Lain-Ego0/G-Exo/Q&A.md

# G-Exo — 产品定位 Q&A

AI主动提问的思路整理

> 状态：**5 轮全部完成 ✓** (2026-06-28)  
> 产出：[关键参数草表 V0.1](specs/关键参数草表-V0.1.md) · [BOM 初稿](specs/BOM-初稿.md)  
> 下一步：等灵足 7 月中旬 DM4340 类似物上市 → 采购 → 样机组装

---

## Round 1 · 产品定位基线 ✓

### 一、用户与场景

| # | 问题 | 回答 |
|---|---|---|
| 1 | **核心用户是谁？** | 户外人群，拓展人类活动边界。搜救、户外爱好者、工业场景 |
| 2 | **使用环境？** | 多场景通用 |
| 3 | **穿戴时长？** | 连续 2-3 小时，充电宝供电 |

### 二、功能与能力

| # | 问题 | 回答 |
|---|---|---|
| 4 | **核心动作？** | 矢状面屈伸 + 冠状面外展/内收。**不要髋旋转** |
| 5 | **"自由度"含义？** | 机械结构多自由度适配人体。髋 1 + 膝 1 |
| 6 | **驱动方式？** | **电机直驱**，连杆 + 绑带固定 |
| 7 | **助力还是矫正？** | **增强健康人的力量/耐力** |

### 三、控制与人机交互

| # | 问题 | 回答 |
|---|---|---|
| 8 | **控制策略？** | IMU + 电机编码器 → 最终选：先 PID/导纳控制跑通硬件 |
| 9 | **操作方式？** | **全自动姿态触发** |

### 四、产品形态

| # | 问题 | 回答 |
|---|---|---|
| 10 | **单腿几个关节？** | 髋 + 膝，双腿共 4 主动自由度 |
| 11 | **材质与重量？** | 铝合金 + 碳纤维。整机 **~4kg**（电池外置） |
| 12 | **穿戴方式？** | 腿部绑带 + 腰部快拆卡扣，独立穿脱 |

### 五、能源与续航

| # | 问题 | 回答 |
|---|---|---|
| 13 | **供电方案？** | 外接充电宝（USB-PD 20V） |
| 14 | **能量回收？** | 有最好 |

### 六、市场与竞品

| # | 问题 | 回答 |
|---|---|---|
| 15 | **对标产品？** | 不同于医疗/工业竞品。G-Exo = 单人小型四自由度主动式外骨骼 |
| 16 | **价格锚点？** | 消费电子级，BOM ≤5K |
| 17 | **差异化卖点？** | 膝关节主动自由度 + 更智能的控制算法 |

### 七、研发阶段

| # | 问题 | 回答 |
|---|---|---|
| 18 | **当前阶段？** | 概念阶段，目标：**8 月物理 AI 黑客松样机** |
| 19 | **最关键瓶颈？** | 选型（关节模组）、确认构型、明确技术路线 |

---

## Round 2 · 深挖矛盾与边界 ✓

### A. 机械构型

| # | 回答 |
|---|---|
| A1 | 竞品 Dnsys X1、Hypershell 仅有髋关节单方向。G-Exo 增加**膝关节主动** + 冠状面**被动** |
| A2 | 冠状面 = **被动跟随**。主动自由度 = 髋屈伸 + 膝屈伸 ×2 = **4 个** |
| A3 | 重量拆解：电机 ×4 ~1,448g + 连杆 ~500g + 绑带腰带 + 电控 ≤ 4kg（电池外置） |

### B. 动力 / 控制 / 成本 / 场景

| # | 回答 |
|---|---|
| B1 | 多档位 **25-60W**，15-20% 助力比例 |
| C1/K1 | 最终选 **路线 3：先 PID/导纳控制跑通硬件，控制算法后续迭代** |
| D1 | **BOM ≤5K**。目标关节模组 ¥799/个，4 个 = ¥3,196 |
| D2 | **购买成品关节模组**，不自研 |
| E1 | **户外场景** |
| E2 | **周末徒步为主** + 越野跑兼容。徒步是最大用户盘（数千万），Dnsys/Hypershell 已做市场验证 |

---

## Round 3 · 关键参数收敛 ✓

| # | 回答 |
|---|---|
| G1 | DM4340：额定 9 N·m / 峰值 27 N·m / 36 rpm / 40:1 / 24V — ⚠️ **缺货** |
| G2 | 扭矩够（峰值 27 N·m ≫ 20% 助力所需 10-14 N·m）。助力比例参考：70kg 成人平地走，髋峰值 ~50-70 N·m，放大 20% → 外骨骼需 ~10-14 N·m |
| H1 | **4 个 IMU**（左右大小腿），G354 车规级 |
| H2 | **不加**压力鞋垫（论文消融实验：去掉仅降 R² 0.03-0.07，徒增成本） |
| H3 | **RK3588 或同类 Linux 开发板**（带 NPU，后续可部署 TCN 推理） |
| I1 | 20V PD → 24V 电机供电拓扑待解决 |
| I2 | **接受**带 1-2 个充电宝（比自制电池包有搞头） |
| K2 | **有动捕设备**，也可租借 |
| O2 | **接受电流估算力矩**（零成本，精度较低但 V1 够用） |

---

## Round 4 · 核心阻塞点突破 ✓

| # | 回答 |
|---|---|
| L1 | CubeMars 太贵。DM4340 ¥799 零售价但缺货。灵足 RS00/RS02 减速比太小速度过快。坚持**买成品模组不自研** |
| L2 | 最终选 **灵足 7 月中旬 DM4340 类似物**（15-60V 宽电压版），直接购买 |
| M1 | PD 3.1 EPR 兼容性差。引用酷泰科 × 中电科外骨骼（充电宝供电 + 双电池换弹式，南京已试用）→ 验证了充电宝外骨骼方向 |
| N1 | 功率 25-60W 三档，助力 15-20% |
| O1 | **4 关节全功能样机**（黑客松用），工作量不会因单腿而减半 |

> 💡 酷泰科情报：充电宝直驱 + 双电池"换弹式"设计，定位户外行走/爬山助力。G-Exo 差异化 = 膝关节主动自由度。

---

## Round 5 · 最终收敛 ✓

| # | 回答 |
|---|---|
| P1 | 黑客松：**2026 年 8 月**。EduLite 05 已上线，但我们不用 |
| P2 | 比赛主题"物理 AI"——强调 AI 算法在物理世界中的应用，与外骨骼契合 |
| Q1 | 灵足 7 月中旬推出 DM4340 类似物（15-60V 宽输入），直接采购。其他品牌售价均有大问题不适用 |
| R1 | 供电拓扑确认：**20V PD 直驱，不升压**。链路：充电宝 → PD 诱骗器(20V) → 电源分配板 → 4×电机 + 降压(5V/3.3V)→主控+IMU |
| R2 | 先单充电宝，后续加热插拔管理器 |
| S1 | 参数共识确认（见下表） |
| S2 | 同意产出参数草表 + BOM |

### 最终参数共识

| 参数 | 值 |
|---|-----|
| 整机重量 | ≤4kg（不含电池） |
| 主动自由度 | 4（髋屈伸×2 + 膝屈伸×2） |
| 被动自由度 | 冠状面外展/内收 |
| 关节模组 | 灵足 4340 类似物 ×4（15-60V，~¥800/个） |
| 助力比例 | 15-20% 生物力矩 |
| 整机功率 | 25-60W（三档：步行/慢跑/爬山） |
| 传感器 | 4×IMU（大小腿）+ 4×电机编码器 |
| 计算平台 | RK3588 / Linux 开发板 |
| 控制 V1 | 电流估算力矩 + 导纳控制 |
| 供电 | 充电宝 20V PD（先单后换弹） |
| BOM | ≤5K |
| 主场景 | 户外徒步 + 慢跑/爬山 |

---

## 附录 A · 灵足 RS06 完整参数

> 用户选型过程中考察的备选方案，保留供参考。最终选择等 7 月中旬 DM4340 类似物。

| 参数 | 值 |
|---|-----|
| 尺寸 | 88 × 88 × 49 mm |
| 重量 | 621g ± 10g |
| 减速比 | 9:1（行星减速，机加工齿轮） |
| 额定电压 | 48V / 使用范围 15-60V |
| 额定扭矩 | 11 N·m / 额定转速 100 rpm |
| 峰值扭矩 | 36 N·m / 峰值电流 57 Apk |
| 空载转速 | 480 rpm |
| 转矩常数 | 1.1 N·m/Arms |
| 编码器 | 14bit 单圈绝对值磁编码器 ×2 |
| 通信 | CAN 总线 1Mbps |
| 驱动 | FOC |
| 认证 | CE / FCC |

## 附录 B · 竞品参考

| | Dnsys X1 | Hypershell | 酷泰科×中电科 | **G-Exo** |
|---|---|---|---|---|
| 关节 | 髋（单） | 髋（单） | 髋（推测） | **髋+膝（4主动）** |
| 供电 | 内置电池 | 内置电池 | 充电宝换弹 | **充电宝 PD 20V** |
| 价格 | ~$500-800 | ~$600-800 | 未公布 | **BOM ≤5K** |
| 场景 | 徒步/登山 | 户外探险 | 行走/爬山 | **徒步+慢跑+爬山** |
| 控制 | 预设模式 | 预设模式 | 未公布 | **导纳控制→TCN力矩估计** |

---

*Q&A 阶段结束。进入等采购 + 构型设计阶段。*
