Lain-Ego0/G-Exo/RL/PHYSICAL_PPO_AUDIT.md

# 动态外骨骼 PPO 复审记录

更新时间：2026-08-02

本文记录动态 URDF、Kinesis 人体、肌肉负载分担和 PPO 链路的第二轮复审结果。

本文不把“相位对齐”列为当前问题。当前所有训练动作使用固定参考动作和固定仿真时间，现阶段首先要解决的是物理传力、肌肉指标和 PPO 探索稳定性。

## 一、已经确认的内容

### 1. 动态模型可以运行

- 动态模型维度：`nq=46, nv=45, nu=90`。
- 人体原有肌肉执行器：`86` 个。
- 外骨骼新增电机：`4` 个。
- 外骨骼质量：约 `3.098 kg`，与 URDF 质量一致。
- 电机通过大腿、小腿绑带约束向人体传力，不再直接给人体关节写入外力矩。
- 绑带力可以通过同一状态下的“电机开/关差值”提取。

### 2. 基线数据已经补齐

当前动态零电机基线为：

```text
11 个动作 × 3 个 seed = 33 个成功 rollout
```

评估模式已经改为严格 seed 模式。缺失 seed 时直接报错，不再自动映射到其他 seed。

### 3. Kinesis 冷启动已经处理

Kinesis 第一次 reset 与后续 reset 存在一次性差异。现在 `AssistBackend.reset()` 会在每个新 backend 的第一次 reset 时预热一次。

同一 motion、同一 seed 的连续测试已经达到完全一致：

```text
activation、muscle torque、MPJPE 的最大差值 = 0
```

## 二、必须优先修正的问题

> 2026-07-31 修复状态：以下四项 P0 已落实。Balance residual 不再终止
> episode；PPO 动作幅值与 `17 Nm` 硬限额解耦，pilot 默认使用 `0.5 Nm`
> 且 `log_std_init=-3`；激活成本只统计跨越四个目标关节的肌肉；力矩
> 省力项改为逐肌肉绝对力矩贡献。新的 33 份基线位于
> `RL/outputs/kinesis_physical_baseline_v2`。以下内容保留为修复依据。

### P0-1：不能用 balance residual 直接终止 episode

原逻辑位于：

```text
RL/env/kinesis/exo_env.py::_abnormal_termination_reason()
```

`balance residual` 表示肌肉层预测力矩与动力学后验力矩之间的不一致，不等价于人体摔倒。

因此以下逻辑不应作为人体失败条件：

```python
if balance_ratio > MAX_BALANCE_RESIDUAL_RATIO:
    return "excessive_muscle_balance_error"
```

它会把正常的探索动作提前截断，导致 PPO 学习“不要探索”，而不是学习如何助力。

真正的 episode 终止条件应只包括：

- pelvis 高度过低；
- 躯干倾角过大；
- Kinesis 原生 tracking failure；
- 肌肉求解器失败；
- NaN/Inf 或其他数值异常。

Balance residual 可以保留为 TensorBoard 指标和软惩罚，但不应直接终止 episode。

### P0-2：训练探索范围不能直接使用 `±17 Nm`

`17 Nm` 是 URDF 给出的硬限制，不应该成为 PPO 初始探索范围。

当前动作近似为：

$$
\tau_t = 17 a_t, \qquad a_t\in[-1,1]
$$

随机策略经过 rate limiter 后，仍可能在数个控制周期内产生较大的力矩，破坏原始步态。

训练应该使用独立的动作课程：

$$
\tau_t = \tau_{\text{train},k}a_t
$$

推荐阶段：

```text
阶段 1：±0.25 或 ±0.5 Nm
阶段 2：±1 Nm
阶段 3：±2 Nm
阶段 4：±4 Nm
阶段 5：±6 Nm
```

`±17 Nm` 只保留为最后的硬安全边界。

同时应使用较小的初始策略方差，例如 `log_std_init=-3`，避免刚开始就输出大幅随机力矩。

### P0-3：激活奖励不应统计全部 86 块肌肉

当前激活成本类似于：

```python
np.mean(np.square(state["muscle_activation"]))
```

这会把上身和不跨越目标关节的肌肉也纳入外骨骼省力奖励。

正确的目标肌肉集合应定义为：

$$
\mathcal{M}_{target}
=
\left\{i\mid \exists j\in\{hip_l,knee_l,hip_r,knee_r\},\ |r_{ij}|>\epsilon\right\}
$$

其中 $r_{ij}$ 是肌肉 $i$ 对目标关节 $j$ 的力矩臂。

之后需要同步修改：

- `AssistBackend` 的目标肌肉 mask；
- `collect_kinesis_baseline.py` 的保存字段；
- `BaselineReference` 的读取字段；
- `exo_env.py` 的 activation reward；
- 33 个基线文件。

### P0-4：净关节力矩不能单独代表肌肉负担

当前关节力矩是：

$$
\tau_j=\sum_i r_{ij}f_i
$$

拮抗肌可能互相抵消，使净关节力矩变小，但肌肉本身仍然很用力。

因此需要同时记录两个量：

1. `net_joint_torque`：用于动力学和平衡；
2. `muscle_effort_torque`：用于省力奖励。

推荐肌肉力矩成本为：

$$
C_{muscle}
=
\frac{1}{|\mathcal{M}_{target}|}
\sum_{i\in\mathcal{M}_{target}}
\sum_{j\in\mathcal{J}}
|r_{ij}f_i|
$$

这样才能区分“净关节力矩下降”和“肌肉真正省力”。

## 三、当前物理模型风险

### 1. 绑带约束仍需校准

目前测得：

- 四个绑带平均位移误差约 `2.1 cm`；
- 峰值约 `3.4 cm`；
- 部分情况下约束力峰值超过 `500 N`。

这说明动态模型已经能够传力，但还不能称为高精度穿戴模型。

需要继续检查：

- 绑带锚点局部坐标；
- `solref` 和 `solimp`；
- 大腿/小腿几何位置；
- 约束力峰值；
- 是否需要有限宽度的绑带接触几何，而不是单点 `connect` 约束。

### 2. 预测 residual 与实际 residual 仍需分开记录

当前应同时保留：

- `pre_step_predicted_balance_residual`：求解器在当前状态的预测误差；
- `post_step_measured_balance_residual`：动力学积分后的实测误差。

二者不能混成一个指标，也不能把后者直接当作摔倒判断。

## 四、剂量响应测试结论

旧测试脚本：

```text
RL/runners/validate_kinesis_dose_response.py
```

移除错误终止并更换目标肌肉口径后，motion 82、三个 seed 的速度同向
助力结果为：

| 助力上限 | 成功率 | 激活省力 | 逐肌肉力矩省力 | MPJPE 变化 |
|---|---:|---:|---:|---:|
| `0 Nm` | `3/3` | `0.00%` | `0.00%` | `0.00 mm` |
| `0.25 Nm` | `3/3` | `-0.18%` | `-1.94%` | `+2.17 mm` |
| `0.5 Nm` | `3/3` | `-0.34%` | `-3.22%` | `+2.50 mm` |
| `1 Nm` | `3/3` | `-2.70%` | `-3.85%` | `+3.75 mm` |
| `2 Nm` | `3/3` | `-5.06%` | `-6.08%` | `+3.31 mm` |
| `4 Nm` | `3/3` | `-17.28%` | `-13.89%` | `+10.27 mm` |

负值表示人体负担增加。该结果证明物理模型可以完成 `2/4 Nm` 测试，旧失败
确实来自人工终止；同时也证明固定速度同向助力不是有效控制律，PPO 必须从低力矩
范围学习何时、向哪个方向助力。完整报告位于
`RL/outputs/kinesis_dose_response/p0_fixed_motion_082.json`。

## 五、重新进入 PPO 前的顺序

1. ~~删除 balance residual 的硬终止。~~ 已完成。
2. ~~加入动作幅值课程和较小初始策略方差。~~ 已完成初始 `0.5 Nm` 阶段；
   后续通过 `--action-scale-nm` 分阶段扩大。
3. ~~修改激活成本，只统计目标下肢肌肉。~~ 已完成。
4. ~~增加逐肌肉力矩成本，保留净关节力矩作为动力学指标。~~ 已完成。
5. ~~重新生成 33 个带新字段的物理基线。~~ 已完成。
6. ~~重跑 `0/0.25/0.5/1/2/4 Nm` 剂量响应。~~ 已完成 motion 82 基线。
7. 从零开始跑 `200k` pilot，而不是从旧模型 resume。
8. 使用多动作、多 seed 的配对指标选择 checkpoint。
9. 只有低力矩阶段稳定后，才扩大动作范围并进入 `1M` 训练。

## 六、PPO 阶段验收标准

短期 pilot 至少需要满足：

- 所有留出动作完成率接近 `100%`；
- 激活成本和逐肌肉力矩成本均下降，而不是只下降净关节力矩；
- MPJPE 不明显恶化；
- balance residual 只作为监控和软惩罚，不作为普通探索的终止条件；
- 绑带约束误差和峰值力保持在可解释范围；
- PPO 的 reward 提升必须和真实配对省力指标同步。

当前不足 `5%` 激活卸载或不足 `3%` 肌肉力矩卸载的结果，不能视为最终达标结果。

## 七、冻结 Kinesis 与外骨骼助力的最终有效性边界

### 7.1 当前闭环到底在计算什么

当前动态链路为：

```text
受助力后的人体状态
        -> 冻结 Kinesis 策略
        -> 86 维名义肌肉兴奋度
        -> MuscleLoadSharing 接收四关节外骨骼力矩
        -> 重新分配肌肉负载
        -> 动态 URDF 通过绑带向人体传力
        -> MuJoCo 积分得到下一状态
```

外骨骼力矩已经真实进入动力学，脉冲测试也证明四个关节的响应方向正确。因此，
当前仿真不是“完全假的”。但冻结 Kinesis 每一步都读取受助力后的状态，并继续以
复现原参考动作为目标。它可能把外骨骼作用识别为扰动，再用人体肌肉进行补偿。

真实使用者通常会在多个步态周期内逐渐调整前馈用力并利用外骨骼；冻结 Kinesis
没有这种助力感知和共同适应能力。因此当前模型中的肌肉变化同时包含：

1. 外骨骼通过物理传力产生的负载变化；
2. `MuscleLoadSharing` 解析层主动重新分配的负载；
3. Kinesis 为维持原参考轨迹产生的反馈补偿。

三者在当前闭环中不能从最终激活值里直接分离。

### 7.2 当前结果可以证明什么

当前链路可以继续用于：

- 检查 URDF 质量、惯量、关节方向和绑带传力；
- 检查电机力矩、变化率、功率和安全限额；
- 检查某条助力曲线是否破坏 Kinesis 的行走稳定性和轨迹质量；
- 做脉冲、剂量响应、故障终止和仿真渲染；
- 把冻结 Kinesis 视为一个特定的鲁棒控制对象，研究闭环扰动响应。

当前链路不能直接证明：

- 真人肌肉激活或代谢消耗下降了同样比例；
- PPO 学到的是人体自然利用助力后的最优策略；
- 仿真中的 `activation_saving` 可以按固定比例映射到实机省力；
- 在冻结 Kinesis 上继续提高 Reward 就一定会提高真人助力效果。

因此，后续报告必须把当前激活、逐肌肉力矩和代谢代理称为“模型内指标”或
“固定轨迹条件下的预测卸载”，不能直接称为真人代谢下降。

### 7.3 已经用过的方案与明确没有做过的方案

已经用过：

- 同一受助力状态下的 `MuscleLoadSharing`；
- 只积分名义激活的 `shadow_activation`；
- 离线零助力 baseline Reward；
- tracking hinge、balance gate、相位/context baseline；
- 50 Hz 因果 TCN、显式未来运动特征和 PPO 对照；
- 动态 URDF、绑带传力、脉冲和剂量响应测试。

这里的 `shadow_activation` 不是一套独立影子人体。它没有独立的 `MjData`、
位置、速度、接触、动力学积分和 Kinesis Observation。因此当前工程从未运行过
“受助力人体与零助力人体同步前进”的完整双动力学影子方案。

也没有实现过以下新方案：

- 以固定运动学轨迹为约束的整周期肌肉--外骨骼联合优化；
- 用该优化结果生成四关节助力标签并监督训练 Actor；
- 能显式接收外骨骼作用并重新学习省力行为的人体策略。

### 7.4 两条已经否决的捷径

不能直接删除或投影 Kinesis 的反作用力。若人为限制与外骨骼反向的肌肉力矩，
激活下降将部分来自人为规则，而不是人体模型自然响应。此时 Reward 会奖励设计者
写入的卸载，无法作为生理结论。

也不能把同一个黑盒 Kinesis 策略的输出简单拆成“名义动作 + 反馈纠偏”：

$$
u_t=\pi(o_t)
$$

在该结构中，助力前后策略输出之差同时包含相位、接触、推进、平衡和轨迹误差的
变化，并不是可辨识的纯反馈项。对这部分做比例缩放同样会人为修改人体控制规律。

TCN 或相位头只能改善 Actor 对未来运动的观察，不能解决肌肉 Reward 的物理
因果性。若人体模型仍把助力当扰动，增加 TCN 只能让 Actor 更准确地预测何时会被
抵消，不能凭空生成自然的人机共同适应。

## 八、时间受限条件下的可执行路线

### 8.1 结论

短时间内可以训练出一个可运行、可部署形式的助力策略，但不应继续从零训练当前
冻结 Kinesis PPO。最快路线是：

```text
Phase 1/2 与 Kinesis 参考运动
        -> 固定轨迹肌肉--外骨骼联合优化
        -> 每帧四关节最优助力标签
        -> 已有 TCN 提供未来运动特征
        -> 监督学习四输出 Actor
        -> Kinesis + 动态 URDF 做稳定性和安全复核
        -> 可选的小范围 residual PPO
```

这条路线不需要先训练一个新的人体行走策略，也不依赖低信噪比的在线 PPO effort
Reward。它把“人体在给定轨迹下怎样分配肌肉和外骨骼负载”变成一个明确的优化
问题，再把求解结果蒸馏为实机可运行的网络。

### 8.2 最优助力标签如何产生

对参考轨迹的每个时刻，先得到维持该运动所需的关节力矩：

$$
\tau_{req,t}=M(q_t)\ddot q_t+C(q_t,\dot q_t)+g(q_t)+\tau_{contact,t}
$$

若 Phase 1/2 已经给出同一关节定义下的生物关节力矩，可以先把它作为
$\tau_{req,t}$ 的数据标签，避免首版重复做完整逆动力学。Kinesis/MuJoCo 轨迹则
应使用其自身模型重新计算名义肌肉力矩，不能把不同人体模型的关节力矩不经标定
直接混用。

在固定 $q_t,\dot q_t$ 下，联合求解肌肉激活 $a_t$ 和四关节外骨骼力矩
$\tau_{e,t}$：

$$
\begin{aligned}
\min_{a_t,\tau_{e,t}}\quad
&w_a\lVert a_t\rVert_2^2
+w_e\lVert\tau_{e,t}\rVert_2^2
+w_s\lVert\tau_{e,t}-\tau_{e,t-1}\rVert_2^2 \\
\text{s.t.}\quad
&R(q_t)F(a_t,q_t,\dot q_t)+\tau_{e,t}=\tau_{req,t}, \\
&0\le a_t\le1, \\
&\lvert\tau_{e,t}\rvert\le\tau_{max}, \\
&\lvert\tau_{e,t}-\tau_{e,t-1}\rvert\le\dot\tau_{max}\Delta t.
\end{aligned}
$$

首版可以复用当前肌肉力臂、主动/被动力和 BVLS/QP 计算，不必立即引入新的大型
肌肉网络。与当前 `MuscleLoadSharing` 的关键区别是：目标运动和所需总力矩固定，
求解器直接比较同一运动下有无外骨骼的最优肌肉代价，不让 Kinesis 在下一步通过
反馈补偿改变问题本身。

为了避免拮抗肌抵消造成假省力，标签筛选同时检查：

$$
C_{act}=\frac{1}{|\mathcal M_{target}|}
\sum_{i\in\mathcal M_{target}}a_i^2
$$

以及：

$$
C_{force}=\frac{1}{|\mathcal M_{target}|}
\sum_{i\in\mathcal M_{target}}\sum_{j\in\mathcal J}|r_{ij}f_i|.
$$

只有两者在留出动作上都下降，且力矩、变化率和功率不超限，才接受该助力标签。

### 8.3 Actor 如何快速训练

部署 Actor 不读取仿真肌肉真值。输入仍使用实机可获得信息：

```text
4 个编码器位置/速度
+ 4 个 IMU 的角速度与比力
+ 历史电机力矩
+ 冻结 TCN 的 100/200 ms 显式未来运动预测
```

监督目标是优化器产生的四关节力矩：

$$
\mathcal L_{actor}
=\lVert\hat\tau_{e,t}-\tau^*_{e,t}\rVert_1
+\lambda_s\lVert\Delta^2\hat\tau_{e,t}\rVert_2^2.
$$

已有 TCN 继续冻结。只训练一个小型 MLP Actor，通常比从零 PPO 快得多，也不会
出现 Reward 被 tracking、seed 噪声或 Kinesis 补偿淹没的问题。若监督 Actor 在
动态 Kinesis 上偶尔破坏稳定性，再让 PPO 只输出小残差：

$$
\tau_{exo}=\tau^*_{actor}+\alpha\,\Delta\tau_{PPO},
\qquad \alpha\in[0.1,0.2].
$$

此时 residual PPO 的主要任务是保持稳定、跟踪和满足硬件约束，不再承担从噪声
肌肉 Reward 中发现完整助力规律的任务。

### 8.4 最短执行计划与工时

建议按以下顺序执行，任何一关失败都停止扩大训练：

| 阶段 | 内容 | 预计墙钟/人工工时 |
|---|---|---:|
| P0 | 用 3 条代表性 motion、每条 1 个周期生成优化标签，画四关节力矩与两类肌肉成本曲线 | `2--4 h` |
| P1 | 扩到现有 8 条训练 motion、多个 seed/cycle，生成训练/验证标签 | `2--6 h` |
| P2 | 冻结 TCN，监督训练小型四输出 Actor，并检查留出误差 | `0.5--1.5 h` |
| P3 | 在动态 Kinesis + URDF 上跑 baseline/teacher/Actor 三组配对测试和渲染 | `1--2 h` |
| P4 可选 | `100k--300k` 小残差 PPO，只修稳定与约束 | `0.5--2 h` |

首个可展示版本预计需要约 `6--12 h`，而不是再等待数百万步 PPO。这里的时间是
基于现有数据、TCN、动态 URDF 和肌肉求解器均可复用的估计，不包含重新训练人体
策略或重新标定完整 OpenSim 模型。

如果只需要当天演示，可以先做更小的 P0/P2：选 1--3 条平地步态，生成周期助力
曲线并训练 Actor。演示应同时展示：

- 零助力与 Actor 助力的动态仿真；
- 四关节力矩、功率和绑带力；
- 固定轨迹优化下的激活平方与逐肌肉力矩成本；
- 动态 Kinesis 下的成功率和 MPJPE 不明显恶化。

展示文案必须明确“固定轨迹模型预测卸载 + 动态稳定性验证”，不能写成已经证明
真人代谢下降。

### 8.5 进入下一阶段的硬门槛

P0 标签实验至少满足以下条件，才值得训练 Actor：

- 优化等式残差足够小，不能靠破坏所需总关节力矩换取省力；
- 激活平方和逐肌肉绝对力矩成本在多数 motion/cycle 上同时下降；
- 标签在周期边界连续，且不持续撞击电机力矩、变化率或功率上限；
- 不同 seed 上的助力方向和主要峰值相位基本一致；
- 留出动作上的收益不是只由单个关节或单块肌肉主导。

若 P0 不通过，问题在肌肉模型、力矩映射或硬件约束，不应开始 Actor/PPO 训练。
若 P0 通过而动态 Kinesis 复核失败，说明冻结人体控制器不接受该助力模式；此时
只能把 Kinesis 用作保守安全筛选，最终动态生理训练仍需助力感知的人体策略。

## 九、长期正确路线

要让动态仿真中的肌肉省力更接近真实共同适应，最终仍需训练或微调一个明确接收
外骨骼作用的人体策略。其输入至少包含人体状态、任务目标和外骨骼交互信息；目标
应是速度、方向、平衡和任务完成，逐帧轨迹只能作为软先验，同时最小化肌肉激活或
代谢代理。

短期固定轨迹优化不是最终人体模型，但它可以提供：

- 可解释的助力上界和相位力矩模板；
- 监督 Actor 的高信噪比标签；
- 助力感知人体策略的 curriculum 和初始外骨骼分布；
- 后续 PPO 不再从随机力矩开始探索的初始化。

因此当前推荐决策是：停止围绕冻结 Kinesis 的肌肉 Reward 继续长程调权重，先完成
固定轨迹优化 P0。P0 通过后用监督 Actor 在当天得到首版策略；PPO 只作为后续小
残差修正，而不是首版助力规律的发现器。
