Lain-Ego0/G-Exo/2.software/alloop/README.md

# Alloop 套件使用范围说明（第三方受限许可）

本目录为 Alloop 提供的黑客松套件（Dart 源代码与随附的二进制组件 AAR）在本地的存放位置。
**套件代码未随本仓库分发（本地保留，仅此说明随仓库提供）**，其使用受 Alloop 的许可条款约束，
不属于本仓库的 MIT 许可范围。

## 许可范围

依据 `code/packages/alloop_blue_lite/LICENSE`（Copyright (c) 2026 Alloop. All rights reserved.）：

> 本软件包（含 Dart 源代码与随附的二进制组件）仅授权黑客松参赛者在
> 本次赛事期间及参赛作品范围内使用、修改与演示。

## 禁止事项（未经版权方书面许可）

1. 将本软件包或其任何组成部分用于赛事之外的商业或生产用途；
2. 对随附的二进制组件（AAR）进行反编译、反汇编或其他逆向工程；
3. 单独再分发本软件包或其任何组成部分。

## 使用前提

- 仅限**黑客松参赛者**在**本次赛事期间及参赛作品范围内**使用；
- 如将本套件用于其他用途（含开源再分发），请先联系 Alloop 获取书面许可；
- 本目录内除 `alloop_blue_lite` 包外的文件未附带明确许可，默认保留所有权利，同样受上述限制约束。

## 版权与联系

Copyright (c) 2026 Alloop. All rights reserved. 许可事宜请联系 Alloop。
