Lain-Ego0/G-Exo/1.hardware/BOM.md

# G-Exo BOM

> 版本：V2.2 · RS02 准直驱 + RL+TCN 混合控制（Nature 2024 范式）  
> 日期：2026-07-30（价格更新）  
> 目标：BOM ≤ ¥5,000  
> 状态：**技术路线确认，RS02 已采购（学生9折，实购5台）**

---

## 技术路线

基于 [Molinaro et al., Nature 2024](https://doi.org/10.1038/s41586-024-08157-7) 的任务无关控制范式 + sanholy 分支 RL 训练框架：

```
G354 IMU×4 + RS02 编码器 → K3 → TCN时序编码 + PPO策略推理 → CAN 力矩指令 → RS02×4
```

- RL + TCN 时序编码器混合架构：TCN 压缩传感器时序特征 → PPO 策略输出四关节力矩
- 仿真训练：MyoSuite 80 肌肉人体 + MuJoCo 物理引擎 + PPO（Stable-Baselines3）
- 同一控制器覆盖走路、跑步、深蹲、弓步、上下楼梯等 28+ 动作，无需任务分类器
- 辅助力矩：策略网络直接输出归一化力矩 → 缩放/延时/滤波/限幅 → CAN MIT 指令

---

## 一、执行器 — ¥2,516（63%）

| # | 物料 | 型号/规格 | 数量 | 单价 | 小计 | 采购 |
|---|---|---|---|---|---|---|
| 1 | 髋关节模组 | **RobStride RS02**（准直驱 QDD，7.75:1，峰值 17Nm，CAN+MIT 模式，Φ58mm，405g） | 2 | ~¥629 | ¥1,258 | ✅ 已采购（学生9折，实购5） |
| 2 | 膝关节模组 | **RobStride RS02**（同上） | 2 | ~¥629 | ¥1,258 | ✅ 已采购（同上，共用5台） |

> RS02 vs 论文 AK80-9：减速比 7.75:1 ≈ 9:1，反驱接近，峰值 17Nm ≈ 18Nm，MIT 协议兼容。  
> 对比先前 DM4340（40:1）：反驱低 5 倍，力控带宽更高，更适合转矩控制方案。

---

## 二、电源系统 — ¥540（12%）🆕 锂电直驱

| # | 物料 | 型号/规格 | 数量 | 单价 | 小计 | 采购 |
|---|---|---|---|---|---|---|
| 3 | 动力电池 | **新安能 6S 3000mAh**（22.2V 标称 / 25.2V 满电，XT60 输出） | 2 | ~¥105 | ¥210 | 🔧 待采购 |
| 4 | 6S 平衡充电器 | ISDT / ToolkitRC（LiPo 平衡充，含并充板） | 1 | ~¥200 | ¥200 | 🔧 待采购 |
| 5 | 电源分配板 | 24V 1进4出 → 4×RS02 + 1×降压模块（XT30×4 + 保险丝） | 1 | ~¥80 | ¥80 | 🔧 等确认电流 |
| 6 | 降压模块 | 24V→5V/5A（主控供电） | 1 | ~¥30 | ¥30 | ✅ 可现购 |
| 7 | 电源开关 + 电压监控 | 20A 开关 + BB响电压报警器 | 1 | ~¥20 | ¥20 | ✅ 可现购 |

> **6S 电压匹配**：满电 25.2V > RS02 最低 24V。放电至 22V 时可能触发 RS02 欠压保护，可尝试将欠压阈值寄存器 `0x00` 调低至 20V（灵足电机通常有余量），或用 BB 响在 3.6V/节（21.6V 总）时提前换电。  
> **续航**（每块 66.6Wh，可用 ~53Wh）：走路 ~80W → **~40min/块** → 两电 ~1.3h；跑步 ~120W → **~26min/块** → 两电 ~50min。  
> **两电轮换**：一块跑一块充，无限续航。

---

## 三、机械结构 — ¥1,100（24%）3D 打印 + 碳纤维

| # | 物料 | 规格 | 数量 | 单价 | 小计 | 采购 |
|---|---|---|---|---|---|---|
| 8 | 髋关节连杆 | 碳纤维管/板 + 3D 打印连接件（适配 RS02 安装孔位） | 2 | ~¥50 | ¥100 | 🔧 等 RS02 到手量尺寸 |
| 9 | 膝关节连杆 | 碳纤维管/板 + 3D 打印连接件（适配 RS02 安装孔位） | 2 | ~¥40 | ¥80 | 🔧 等 RS02 到手量尺寸 |
| 10 | 腰部固定架 | 碳板 + 3D 打印 PETG/尼龙 + 快拆卡扣座 | 1 | ~¥80 | ¥80 | 🔧 等模组尺寸 |
| 11 | 关节-连杆连接件 | 3D 打印 PETG/尼龙 | 8 | ~¥5 | ¥40 | 🔧 等模组尺寸 |
| 12 | 3D 打印耗材 | PETG/PLA+ 1.75mm 2-3kg | 3 | ~¥60 | ¥180 | ✅ 可现购（若有打印机） |
| 13 | 碳纤维管/板外发加工 | 大腿连杆 + 腰部悬臂 + 电机固定板 | 若干 | — | ~¥580 | 🔧 等确认最终尺寸 |
| 14 | 热熔螺母 + 螺栓 | M3/M4 铜螺母 + 不锈钢螺栓 | 若干 | ~¥40 | ¥40 | ✅ 可现购 |

---

## 四、穿戴固定 — ¥200（4%）

| # | 物料 | 规格 | 数量 | 单价 | 小计 | 采购 |
|---|---|---|---|---|---|---|
| 15 | 大腿绑带 | 50mm 尼龙织带 + 魔术贴 + 快拆扣 | 2 | ~¥40 | ¥80 | ✅ 可现购 |
| 16 | 小腿绑带 | 38mm 尼龙织带 + 魔术贴 + 快拆扣 | 2 | ~¥35 | ¥70 | ✅ 可现购 |
| 17 | 腰带 | 加宽尼龙腰带 + 铝合金快拆卡扣 | 1 | ~¥50 | ¥50 | ✅ 可现购 |

---

## 五、电子电控 — ¥85（2%）

| # | 物料 | 型号/规格 | 数量 | 单价 | 小计 | 采购 |
|---|---|---|---|---|---|---|
| 18 | 主控板 | 进迭时空 K3 COM260 Kit | 1 | ¥0 | ¥0 | ✅ 已借到 |
| 19 | USB-CAN 模块 | CANable/周立功 USB 转 CAN（RS02 自带 CAN 但调试需上位机接入） | 1 | ¥0 | ¥0 | ✅ 已有 |
| 20 | IMU 模块 | G354 车规级 6 轴 IMU（SPI/I2C），大腿×2 + 小腿×2 | 4 | ¥0 | ¥0 | ✅ 已有 |
| 21 | 线材与接插件 | XT30/XT60 电源头、CAN 分支线、硅胶线 14-22AWG、JST/SH1.0 信号线 | 若干 | ~¥85 | ¥85 | ✅ 可现购 |

> **RS02 省掉的**：PD 诱骗模块（不再用 USB-C 供电）、额外降压模块（只需一路 24V→5V）、独立编码器（RS02 内置 14-bit 磁编码）。  
> **CAN 拓扑**：K3 → CAN → RS02×4 菊花链（RS02 双 XT30(2+2) 接口支持级联）。  
> **可选**：Moticon 或国产压力鞋垫（~¥500-1000），提升力矩估计 R² 约 0.1，非必需。

---

## 六、其他 — ¥170（4%）

| # | 物料 | 规格 | 数量 | 单价 | 小计 | 采购 |
|---|---|---|---|---|---|---|
| 22 | 紧固件套件 | M3/M4/M5 螺栓+螺母+垫片（不锈钢） | 1 套 | ~¥50 | ¥50 | ✅ 可现购 |
| 23 | 缓冲垫/泡棉 | EVA/PU 自粘垫片（绑带内侧） | 若干 | ~¥30 | ¥30 | ✅ 可现购 |
| 24 | 急停开关 | 工业急停按钮（常闭，串联电源总线） | 1 | ~¥30 | ¥30 | ✅ 可现购 |
| 25 | 杂项耗材 | 扎带、热缩管、绝缘胶带、焊锡、杜邦线 | — | ~¥60 | ¥60 | ✅ 可现购 |

---

## 七、汇总

| 大类 | V1.1（DM4340 减速电机） | **V2.1（RS02 准直驱）** | 占比 | 可现购 |
|---|---|---|---|---|
| 执行器 | ¥3,200 | **¥2,516** | 54% | ✅ RS02 已采购 |
| 电源系统 | ¥145 | **¥540** | 12% | 🔧 待采购电池+充电器 |
| 机械结构 | ¥160 | **¥1,100** | 24% | 🔧 等 RS02 尺寸 |
| 穿戴固定 | ¥200 | ¥200 | 4% | ✅ |
| 电子电控 | ¥85 | **¥85** | 2% | ✅ 核心已有 |
| 其他 | ¥170 | ¥170 | 4% | ✅ |
| **总计** | **¥3,960** | **¥4,611** | 100% | |

> V1.1 → V2.1 变化：执行器从 DM4340（40:1 减速）升级为 RS02（7.75:1 QDD），更适合论文力矩控制方案；  
> 电源从 PD 诱骗改为 6S 锂电直驱；机械结构从全 3D 打印升级为碳纤维+3D 打印混合方案；  
> RS02 单价 ¥699，学生9折后 ~¥629/个，实购 5 台。

---

## 八、RS02 vs DM4340 vs AK80-9（论文）

| 参数 | RS02（选型） | DM4340（放弃） | AK80-9（论文参考） |
|---|---|---|---|
| 类型 | 准直驱 QDD | 减速电机 | 准直驱 QDD |
| 减速比 | **7.75:1** | 40:1 | 9:1 |
| 峰值扭矩 | 17 Nm | 40 Nm | 18 Nm |
| 空载转速 @24V | 205 rpm | 56 rpm | ~285 rpm |
| 重量 | 405 g | 362 g | 485 g |
| 反驱透明度 | ✅ 好 | ❌ 差（40:1 齿轮阻力） | ✅ 好 |
| 力矩控制带宽 | ✅ 高 | ⚠️ 受高减速比限制 | ✅ 高 |
| MIT 协议 | ✅ 原生支持 | ✅ 支持 | ✅ 原生支持 |
| CAN 级联 | ✅ XT30(2+2) 菊花链 | ✅ 双 CAN 口 | ✅ |
| 编码器 | 14-bit 单圈绝对值 | 14-bit 双编码器 | 14-bit 磁编码 |
| 24V 跑步适配 | ✅ 76rpm<205rpm | ❌ 76>56 不够 | ✅ |

---

## 九、采购优先级

| 优先级 | 物料 | 行动 | 金额 |
|---|---|---|---|
| **P0 现在就买** | 绑带腰带、线材接插件、紧固件+缓冲+急停+杂项耗材、3D 打印耗材/热熔螺母、降压模块+电源开关+BB响 | 淘宝 | ~¥725 |
| **P1 近期采购** | RS02 × 4 | 灵足官网/淘宝 | ~¥2,516 |
| **P1 近期采购** | 新安能 6S 3000mAh ×2 + 6S 平衡充电器 | 淘宝 | ~¥410 |
| **P1 近期采购** | 电源分配板 | 淘宝/自制 | ~¥80 |
| **P2 等 RS02 到货** | 碳纤维管/板外发加工（大腿连杆+腰部悬臂+电机固定板） | 按实际尺寸 | ~¥580 |
| **P2 等 RS02 到货** | 3D 打印结构件（髋/膝关节连杆+腰部固定架+连接件） | 按实际尺寸 | ~¥300 |

---

## 十、不含 BOM 的工具/设备

| 项目 | 用途 |
|---|---|
| 3D 打印机 | 结构件打样 |
| 电烙铁 + 焊锡 | 接线 |
| 万用表 | 调试 |
| 内六角扳手套装 | 组装 |
| RS02 上位机调试软件 | 电机校准/参数配置（灵足官网下载） |
| 动作捕捉（可选） | 如需自采训练数据（可租用高校实验室） |

---

*🟢 BOM ¥4,611。RS02 ×4（实购5，含1台自费备用）+ RL+TCN 控制方案（sanholy 分支）。主控 K3 / IMU / USB-CAN 已有，6S 新安能锂电直驱。*
>
> *注：以上物料价格为大致估计（基于当前市场询价和历史采购经验），实际采购价格可能因渠道、促销、批次等因素存在少量差异。*
