Lain-Ego0/G-Exo/4.document/K3 260com kit/K3-COM260_KIT_V02_20260318_BOM.xls

Sheet: K3-COM260_KIT_V02_20260306
 |  |  | K3-COM260_KIT_BOM_V02: J13颜色规定黑色 | 2026-03-18
Item | Value | Quantity | Reference | PCB Footprint | Description | Manufacturer | Part Numbe | ASSY_OPT | 备注
1 | EFM8SB10F2G-P3737 | 1 | U1402 | QFN020Q_P050_0030_T018X018 | 8 位微控制器MCU | SILICON LABS | EFM8SB10F8G-A-QFN20 |  | EFM8SB10F2G-P3737
2 | 100uF-50V | 2 | C1001,C1002 | CAP_SMD_7343 | 100uF±20%,25V,钽电容 | KEMET | T521D107M025ATE040 |  | https://item.szlcsc.com/datasheet/T521D107M025ATE040/730895.html
3 | 1uF | 7 | C1003,C1205,C1312,C1324,C1328,C1502,C1812 | C0402 | 1uF±10%,25V,X5R
4 | 100nF | 1 | C1101 | C0603 | 100nF±10%,50V,X7R
5 | 22uF-25V | 2 | C1102,C1105 | C0805 | 22uF±20%,25V,X5R
6 | 1uF | 1 | C1103 | C0603 | 1uF±10%,25V,X7R
7 | 4.7uF | 1 | C1104 | C0603 | 4.7uF±10%,25V,X5R |  |  | NC
8 | 4.7uF | 1 | C1201 | C0603 | 4.7uF±10%,25V,X5R
9 | 22uF | 1 | C1202 | C0805 | 22uF±20%,25V,X5R
10 | 0.47uF | 1 | C1203 | C0402 | 0.47uF±10%,25V,X5R
11 | 0.47uF | 2 | C1204,C1206 | C0402 | 0.47uF±10%,25V,X5R |  |  | NC
12 | 10uF | 6 | C1301,C1302,C1303,C1313,C1314,C1315 | C0603 | 10uF±20%,25V,X5R
13 | 100nF | 2 | C1304,C1316 | C0402 | 100nF±10%,16V,X7R
14 | 0.1uF | 10 | C1305,C1317,C1401,C1402,C1501,C1506,C1507,C1508,C1510,C1511 | C0402 | 0.1uF±10%,25V,X5R
15 | 2.2nF | 2 | C1306,C1318 | C0402 | 2.2nF±10%,50V,X7R
16 | 22uF | 8 | C1307,C1308,C1309,C1310,C1319,C1320,C1321,C1322 | C0603 | 22uF±20%,10V,X5R
17 | 2.2uF | 2 | C1311,C1323 | C0402 | 2.2uF±20%,25V,X5R
18 | 10uF | 2 | C1325,C1327 | C0603 | 10uF±20%,16V,X5R
19 | 22pF | 1 | C1326 | C0402 | 22pF±5%,25V,C0G
20 | 2.2uF | 1 | C1329 | C0402 | 2.2uF±10%,16V,X5R
21 | 10nF | 2 | C1403,C2503 | C0402 | 10nF±10%,50V,X7R
22 | 4.7uF | 1 | C1503 | C0402 | 4.7uF±20%,16V,X5R
23 | 390pF | 2 | C1504,C1505 | C0402 | 390pF±5%,50V,C0G
24 | 100uF-50V | 1 | C1509 | CAP_SMD_3216 | 100uF±20%,6.3V,钽电容 | KEMET | T520A107M006ATE070 | NC
25 | 0.1uF | 55 | C1601,C1602,C1603,C1606,C1607,C1608,C1609,C1610,C1613,C1614,C1616,C1617,C1628,C1629,C1630,C1631,C1632,C1636,C1637,C1638,C1639,C1640,C1641,C1701,C1702,C1801,C1802,C1803,C1804,C1805,C1806,C1807,C1808,C1809,C1810,C1811,C1901,C1902,C2001,C2102,C2103,C2104,C2105,C2107,C2202,C2211,C2302,C2307,C2308,C2401,C2402,C2501,C2504,C2505,C2507 | C0402 | 0.1uF±10%,16V,X5R
26 | 1uF | 15 | C1604,C1605,C1611,C1615,C1619,C1622,C1623,C1624,C1625,C1626,C1627,C1633,C1634,C1635,C1642 | C0402 | 1uF±10%,16V,X5R
27 | 10uF | 2 | C1612,C1621 | C0402 | 10uF±20%,10V,X5R
28 | 10pF | 2 | C1618,C1620 | C0402 | 10pF±5%,50V,C0G
29 | 100nF | 1 | C1643 | C0201 | 100nF±10%,16V,X5R
30 | 1uF | 1 | C1644 | C0201 | 1uF±20%,16V,X5R
31 | 1nF | 1 | C2002 | C1206 | 1nF±10%,2000V,X7R
32 | 10uF | 4 | C2101,C2106,C2201,C2301 | C0402 | 10uF±20%,6.3V,X5R
33 | 0.22uF | 10 | C2203,C2204,C2205,C2206,C2207,C2208,C2209,C2210,C2303,C2304 | C0402 | 0.22uF±10%,10V,X5R
34 | 0.22uF | 2 | C2305,C2306 | C0402 | 0.22uF±10%,10V,X5R |  |  | NC
35 | 1uF | 1 | C2502 | C0402 | 1uF±10%,6.3V,X7R
36 | 0.1uF | 1 | C2506 | C0402 | 0.1uF±10%,16V,X5R |  |  | NC
37 | NCD0603G1 | 1 | D1001 | sled1x2-2_7x1_1-h1_0 | LED,绿色,2.4V | 国星光电 | NCD0603G1
38 | BAT54HT1G | 1 | D1002 | sod2-p2_32-1_8x1_35-h1_0 | Vf=800mV@100mA Ir=2uA@25V Vr=30V | onsemi(安森美) | BAT54HT1G
39 | DDZ22BSF-7 | 1 | D1101 | diode_smd_sod323_c | 稳压二极管,耐压:21.18V 电流:0.07uA@19.6V | DIODES | DDZ22BSF-7 |  | https://item.szlcsc.com/datasheet/DDZ22BSF-7/602234.html
40 | BAT54CW | 2 | D1401,D1402 | SOT323 | 一对共阴级,电压:30V 电流:200mA | DIODES | BAT54CW-7-F |  | https://item.szlcsc.com/datasheet/BAT54CW-7-F/84738.html
41 | BZT52C3V3T | 1 | D1403 | diode_smd_sod523_b | 稳压二极管,独立式 耐压:3.3V 电流:5uA@1.0V | DIODES | BZT52C3V3T-7 |  | https://item.szlcsc.com/datasheet/BZT52C3V3T-7/162903.html
42 | MSMP20A-M3/89A | 1 | D1501 | DO219AD-2_3X1_4-H0_73 | 单向TVS 20V截止 峰值浪涌电流：4.6A@10/1000us 23.4A@8/20us | VISHAY | MSMP20A-M3/89A |  | https://item.szlcsc.com/datasheet/MSMP20A-M3%252F89A/2066115.html
43 | BTRD04A02 | 23 | D1502,D1503,D1504,D1505,D1601,D1602,D1603,D1604,D1605,D1606,D1607,D1608,D2101,D2102,D2401,D2402,D2403,D2404,D2501,D2502,D2503,D2504,D2505 | sdom2-1_4x0_85 |  |  | BTRD04A02 |  | BTRD04A02
44 | ESD | 40 | D1701,D1702,D1703,D1704,D1705,D1706,D1802,D1803,D1901,D1902,D1903,D1904,D1905,D1906,D1907,D1908,D1909,D1910,D1911,D1912,D1913,D1914,D1915,D1916,D1917,D1918,D1919,D1920,D1921,D1922,D1923,D1924,D1925,D1926,D1927,D1928,D1929,D1930,D1931,D1932 | ESD0402 | 双向ESD Vrwm=5V 0.05pF 8kV15kV | 伯恩半导体 | BPESD0402-05ST
45 | WS03DLC-B | 9 | D1801,D2001,D2002,D2003,D2004,D2005,D2006,D2007,D2008 | sdom2-3_3x0_7-h1_1 | VRWM=3.3V IPP=1A | TECH PUBLIC(台舟) | WS03DLC-B
46 | 120R-2A | 1 | FB1701 | 0402BL | 磁珠-120R/100MHz/2A/55m欧-型号：BLM15PX121SN1D-封装 0402BL | muRata | BLM15PX121SN1D |  | https://atta.szlcsc.com/upload/public/pdf/source/20181120/C333978_3E581FB55966932B05020139ABDE8E01.pdf
47 | CON_SODIMM_260 | 1 | J2 | con_sodimm_260_smt_ra_f_p005 | SODIMM连接器,260pin,0.5mm | TE Connectivity | 2309413-1 |  | https://item.szlcsc.com/datasheet/2309413-1/2904207.html?c=Q2
48 | HDR1x2P MALE 1.25MM | 1 | J3 | CON_MISC_002_SMD_RA_M_P013_WTB_B |  |  |  | NC
49 | Type-C-24PIN | 1 | J5 | CON_USB_024_SMT_RA_F_100X096_C | 24pin TypeC连接器 | Amphenol | 12401826E412A |  | https://item.szlcsc.com/datasheet/12401826E412A/3759549.html?c=Q2
50 | USB-303WSD-BRY | 2 | J6,J7 | USB3_DUAL-12_50x17_50-h16_19 | USB3.0 双层TYPE-A型母座 22P 弯插 | 讯普电子 | USB-303WSD-BRY |  | https://item.szlcsc.com/datasheet/USB-303WSD-BRY/3132965.html?c=Q2
51 | Molex-displayport-472720024_1 | 1 | J8 | dp20-p0_5-s17_8x14_4-h7 | I/O连接器 间距0.50mm的DisplayPort直角表面贴装插座，镀金层厚度0.76µm，20路，带盖、锁孔、聚酯薄膜、定位销、外壳焊片，无凸缘，无铅 | MOLEX | 472720024 |  | https://www.molex.com/content/dam/molex/molex-dot-com/products/automated/en-us/salesdrawingpdf/472/47272/472720024_sd.pdf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\
52 | 2199230-4 | 1 | J10 | m2_keyE-75p-22_15x9_35-h2_75 | M.2 KEY_E连接器 间距:0.5mm 台阶高:4.2mm 67Pin SMD | TE Connectivity | 2199230-4 |  | https://item.szlcsc.com/datasheet/2199230-4/3390450.html
53 | 1-2199230-5 | 1 | J11 | m2_keyM-77-P0_5-22x9_1-h2_75 | M.2 KEY_M连接器 间距:0.5mm 台阶高:4.2mm 67Pin SMD | TE Connectivity | 1-2199230-5 |  | https://item.szlcsc.com/datasheet/1-2199230-5/618718.html
54 | HDR2X20P | 1 | J12 | CON_HDR_002X020_TH_ST_M_P025_B | 2x20P 间距:2.54mm 排针,直插,黑色
55 | HDR1x4P MALE 1.25MM | 1 | J13 | CON_MISC_004_TH_ST_M_P013_WTB | 1x4P 间距:1.25mm 直插 系列:PicoBlade(MX 1.25) 黑色 | XUNPU | WAFER-MX1.25-4PZZ |  | https://item.szlcsc.com/datasheet/WAFER-MX1.25-4PZZ/3561409.html
56 | HDR1x12P MALE 2.54MM | 1 | J14 | CON_HDR_001X012_TH_RA_M_P025 | 排针2.54PH H2.5 1x12Pin 90度 PC3.0 PA6.0 PB4.3 L13.8 弯凹面 | HC | HC-PZ254-13.8L-1x12PWA |  | https://item.szlcsc.com/datasheet/HC-PZ254-13.8L-1x12PWA/43143816.html?c=Q2
57 | LPJG0926HENL | 1 | J15 | RJ45_POE-15_93x21_25-h13_30 | RJ45连接器 带POE供电 20Pin 直插 | LINK-PP | LPJG0926HENL |  | https://item.szlcsc.com/datasheet/LPJG0926HENL/24125913.html
58 | DC-005-A250 | 1 | J16 | JACK_DC-005-5A-2P5_XKB | DC电源插座 内径2.5 外径6.3 | XKB | DC-005-5A-2.5 |  | https://item.szlcsc.com/datasheet/DC-005-5A-2.5/353347.html
59 | PZ254V-11-02P | 1 | J18 | header2-1_0-p2_54 | 间距:2.54mm 1x2P 直插 方针 | XFCN | PZ254V-11-02P | NC
60 | PZ254V-11-04P | 1 | J19 | con_hdr_001x004_th_st_m_p025 | 间距:2.54mm 1x4P 直插 方针 | XFCN | PZ254V-11-04P | NC
61 | XW05202-220R-00 | 2 | J20,J21 | 22p_0-5pitch-smd | 翻盖式 下接 P数:22P 间距:0.5mm | HCTL | XW05202-220R-00 |  | https://item.szlcsc.com/datasheet/XW05202-220R-00/3178500.html?c=Q2
62 | 1-2199230-5 | 1 | J24 | con_minipex_075_smt_ra_m2_keym_b | M.2 KEY_M连接器 间距:0.5mm 台阶高:4.2mm 67Pin SMD | TE Connectivity | 1-2199230-5 |  | https://item.szlcsc.com/datasheet/1-2199230-5/618718.html
63 | FPC_30P | 1 | J1701 | FPC30-1_0-22_1X2_5-H5_4 | 15P 连接器2*15P-pitch：1mm 型号:X10C2515TP | XKB | X10C2515TP |  | https://item.szlcsc.com/datasheet/X10C2515TP/3091734.html
64 | FXL0630_1R5_M | 1 | L1301 | L2-7_3X6_8-H3_0 | SMD，7*6.6*2.8mm 合金电感，一体成型电感，大电流 | cjiang | FXL0630-1R5-M |  | https://item.szlcsc.com/datasheet/FXL0630-1R5-M/178600.html
65 | MWSA0624S_1R0MT | 1 | L1302 | L2-7_3X6_8-H2_4 | 1uH ±20% 15A | Sunlord | MWSA0624S-1R0MT |  | https://item.szlcsc.com/datasheet/MWSA0624S-1R0MT/397781.html
66 | 1uH | 1 | L1303 | ind_2016a | 1uH±20%,4A | Sunlord | WPN201610UF1R0MT |  | https://item.szlcsc.com/datasheet/WPN201610UF1R0MT/297950.html
67 | NC/12ohm | 6 | L1501,L1801,L1802,L1803,L1804,L1805 | filter_004_smd_006x005 |  |  |  | NC
68 | 4.7uH-2A | 1 | L1601 | IND2520 |  |  |  |  | https://atta.szlcsc.com/upload/public/pdf/source/20231024/D9DB0CBBB5804BFBC9233D4A02F4216A.pdf
69 | 螺柱 | 3 | MEC1,MEC2,MEC3 | HOLE3_8X5_5-PTH-TP | SMTS02025CTS |  | SMTS02025CTS
70 | NX3008NBKW | 6 | Q1001,Q2501,Q2502,Q2503,Q2504,Q2505 | sot323-P1_3-2_2x1_35-h1_0 | NMOS,30V,350mA,1.4Ω@4.5V,SOT-323-3 | Nexperia(安世) | NX3008NBKW
71 | AONR21357 | 5 | Q1101,Q1201,Q1202,Q1204,Q1205 | DFN8-p0_65-3x3-h0_9 | 1个P沟道 耐压:30V 电流:34A | AOS | AONR21357 |  | https://item.szlcsc.com/datasheet/AONR21357/427208.html
72 | BSS138DW-7-F | 2 | Q1203,Q1206 | SC70_6 | 2个N沟道 耐压:50V 电流:200mA | DIODES | BSS138DW-7-F |  | https://item.szlcsc.com/datasheet/BSS138DW-7-F/166242.html
73 | 2N7002 | 5 | Q1207,Q1402,Q1501,Q2101,Q2102 | sot-23-3_0x1_4-h1_15 | 1个N沟道 耐压:60V 电流:115mA VGS=2.5v RDS=7.5R | 江苏长电 | 2N7002 |  | https://item.szlcsc.com/datasheet/2N7002/9040.html
74 | DMG1012UW-7 | 1 | Q1301 | SOT323-3-0_65-2_2X1_35-H1_1 | 1个N沟道 耐压:20V 电流:1A | DIODES | DMG1012UW-7 |  | https://item.szlcsc.com/datasheet/DMG1012UW-7/167735.html
75 | DMN26DOUFB4-7 | 1 | Q1302 | dfet_003_smd_010x006_b | 1个N沟道 耐压:20V 电流:240mA | DIODES | DMN26D0UFB4-7 |  | https://item.szlcsc.com/datasheet/DMN26D0UFB4-7/252731.html
76 | BSS84W-7-F | 1 | Q1401 | SOT323-3-0_65-2_2X1_35-H1_1 | P沟道 耐压:50V 电流:130mA | DIODES | BSS84W-7-F |  | https://item.szlcsc.com/datasheet/BSS84W-7-F/111713.html
77 | WPM3401 | 2 | Q1701,Q2401 | SOT3-3_52x3_4-h1_25 | PMOS 耐压:30V 电流:4.6A | WILLSEMI(韦尔) | WPM3401
78 | S8050 | 3 | Q1702,Q1801,Q1802 | SOT3-3_5x3_8-h1_1 | NPN 耐压:25V 电流:500mA | FH(风华) | S8050LT1-J3Y
79 | NST45010MW6T1G | 1 | Q2402 | SC70_6 | 2个P沟道 电流:100mA 电压:45V | onsemi(安森美) | NST45010MW6T1G |  | https://item.szlcsc.com/datasheet/NST45010MW6T1G/161579.html
80 | 10k | 43 | R1001,R1012,R1013,R1201,R1205,R1208,R1301,R1303,R1309,R1313,R1317,R1319,R1403,R1404,R1405,R1407,R1408,R1503,R1504,R1604,R1605,R1607,R1617,R1618,R1619,R1621,R1627,R1628,R1629,R1630,R1815,R1817,R1820,R1910,R2317,R2318,R2508,R2509,R2510,R2511,R2512,R2514,R2517 | R0402 | 10k±1%,R0402
81 | 47k | 14 | R1002,R1003,R1004,R1005,R1006,R1007,R1008,R1009,R1501,R2101,R2102,R2103,R2201,R2302 | R0402 | 47k±1%,R0402 | YAGEO | RC0402FR-0747KL | NC
82 | 1k | 5 | R1010,R1305,R1315,R1412,R1417 | R0402 | 1k±1%,R0402
83 | 1.8k | 1 | R1011 | R0402 | 1.8k±1%,R0402
84 | 0R | 54 | R1014,R1204,R1306,R1320,R1505,R1506,R1507,R1509,R1510,R1512,R1513,R1514,R1516,R1518,R1519,R1601,R1602,R1603,R1606,R1608,R1609,R1612,R1613,R1614,R1615,R1622,R1623,R1801,R1802,R1803,R1806,R1807,R1808,R1809,R1810,R1811,R1813,R1909,R2001,R2004,R2106,R2202,R2304,R2305,R2306,R2307,R2308,R2312,R2314,R2320,R2321,R2322,R2518,R2523 | R0402 | 0R±1%,R0402
85 | 0R | 27 | R1015,R1312,R1413,R1624,R1633,R1907,R1908,R2104,R2105,R2107,R2109,R2110,R2111,R2112,R2113,R2114,R2203,R2204,R2301,R2303,R2309,R2310,R2311,R2313,R2315,R2316,R2519 | R0402 | 0R±1%,R0402 | YAGEO | RC0402FR-070RL | NC
86 | 1mR | 2 | R1101,R1104 | R2512 | 1mR±1%,R2512,33
87 | 1R | 1 | R1102 | R0402 | 1R±1%,R0402 | YAGEO | RC0402FR-071RL | NC
88 | 100k | 25 | R1103,R1105,R1304,R1311,R1314,R1321,R1324,R1401,R1415,R1416,R1418,R1420,R1423,R1625,R1631,R1634,R1702,R1703,R1704,R1812,R1814,R1818,R2401,R2402,R2403 | R0402 | 100k±1%,R0402
89 | 49.9k | 2 | R1202,R1206 | R0402 | 49.9k±1%,R0402 | YAGEO | RC0402FR-0749K9L | NC
90 | 33k | 1 | R1203 | R0402 | 33k±1%,R0402
91 | 15k | 1 | R1207 | R0402 | 15k±1%,R0402
92 | 1M | 4 | R1209,R1210,R1804,R1805 | R0402 | 1M±1%,R0402
93 | 10k | 11 | R1302,R1308,R1318,R1406,R1410,R1411,R1414,R1901,R1902,R2501,R2513 | R0402 | 10k±1%,R0402 | YAGEO | RC0402FR-0710KL | NC
94 | 13.7k | 1 | R1307 | R0402 | 13.7k±1%,R0402
95 | 1.27R | 1 | R1310 | R0402 | 1.27R±1%,R0402
96 | 22.1k | 1 | R1316 | R0402 | 22.1k±1%,R0402
97 | 20k | 1 | R1322 | R0402 | 20k±1%,R0402
98 | 4.7k | 1 | R1323 | R0402 | 4.7k±1%,R0402 | YAGEO | RC0402FR-074K7L | NC
99 | 4.7k | 11 | R1325,R1409,R1610,R1903,R1904,R1905,R1906,R2502,R2503,R2504,R2505 | R0402 | 4.7k±1%,R0402
100 | 200k | 1 | R1326 | R0402 | 200k±1%,R0402
101 | 4.42k | 1 | R1327 | R0402 | 4.42k±1%,R0402
102 | 110R | 1 | R1402 | R0402 | 110R±1%,R0402
103 | 91k | 1 | R1419 | R0402 | 91k±1%,R0402
104 | 19.6k | 1 | R1421 | R0402 | 19.6k±1%,R0402
105 | 5.11k | 1 | R1422 | R0402 | 5.11k±1%,R0402
106 | 100k | 5 | R1424,R1502,R1511,R1701,R2507 | R0402 | 100k±1%,R0402 | YAGEO | RC0402FR-07100KL | NC
107 | 3.4k | 1 | R1508 | R0402 | 3.4k±1%,R0402
108 | 1M | 2 | R1515,R1517 | R0402 | 1M±1%,R0402 | YAGEO | RC0402FR-071ML | NC
109 | 6.04k | 1 | R1611 | R0402 | 6.04k±1%,R0402
110 | 470k | 1 | R1616 | R0402 |  |  |  | NC
111 | 22R | 1 | R1620 | R0402 | 22R±1%,R0402
112 | 3.4k-1% | 3 | R1626,R1632,R1635 | R0402 | 3.4k±1%,R0402
113 | 47k | 6 | R1816,R1821,R2108,R2115,R2116,R2404 | R0402 | 47k±1%,R0402
114 | 6.8k-1% | 2 | R1819,R2524 | R0402 | 6.8k±1%,R0402
115 | 510R | 2 | R2002,R2003 | R0402 | 510R±1%,R0402
116 | 33R | 2 | R2205,R2319 | R0402 | 33R±1%,R0402
117 | 130R | 1 | R2506 | R0402 | 130R±1%,R0402
118 | 120R | 1 | R2515 | R0402 | 120R±1%,R0402
119 | 499R | 1 | R2516 | R0402 | 499R±1%,R0402
120 | 33R | 1 | R2522 | R0402 | 33R±1%,R0402 | YAGEO | RC0402FR-0733RL | NC
122 | 74LVC1G07GW | 4 | U1001,U1401,U2101,U2301 | SC70_5 | 漏极开路输出缓冲器 | Nexperia(安世) | 74LVC1G07GW,125 |  | https://item.szlcsc.com/datasheet/74LVC1G07GW%252C125/268433.html
123 | SY8370TMC | 2 | U1301,U1302 | QFN13-4_1X3_1-H0_85 | 高效率快速响应 11A 28V 输入同步降压调节器 | Silergy | SY8370TMC |  | https://item.szlcsc.com/datasheet/SY8370TMC/3563351.html
124 | ETA3512FSG | 1 | U1303 | SOT563 | DCDC BUCK 3A | ETA | ETA3512FSG |  | https://item.szlcsc.com/datasheet/ETA3512FSG/48844183.html
125 | ETA5053V180WF1E | 1 | U1304 | DFN4-0_65-1_05X1_05HS0_47-H0_4 | 电源抑制比70dB、低噪声、快速响应、300mA低压差线性稳压器（LDO） | ETA | ETA5053V180WF1E |  | https://item.szlcsc.com/datasheet/ETA5053V180DF1E/23810805.html
126 | SN74LV1T125 | 4 | U1403,U1404,U1901,U1902 | SC70_5 | 单电源供电、带三态输出的单缓冲门CMOS逻辑电平转换器 | TI | SN74LV1T125DCKR |  | https://www.ti.com/cn/lit/ds/symlink/sn74lv1t125.pdf?ts=1760968572454
127 | WS4603E | 6 | U1501,U1606,U1608,U1609,U1803,U2503 | sot5-3_02x1_7x1_15-H1_15 | 限流开关器件，Imax=6.8A，2.5-5.5V | WILLSEMI(韦尔) | WS4603E-5/TR |  | https://item.szlcsc.com/datasheet/WS4603E-5%252FTR/238858.html
128 | FUSB301TMX | 1 | U1502 | QFN010R_P040_0012X0016_B | 自主型USB Type-C控制器，支持Super Speed开关控制 | onsemi(安森美) | FUSB301TMX |  | https://item.szlcsc.com/datasheet/FUSB301TMX/143589.html
129 | ESD73034D | 8 | U1503,U1504,U1602,U1603,U1604,U1605,U1801,U1802 | DFN10-2_55x1_05-H0_55 | 四路ESD VRM:3.3V IPP:5.5A | OmniVision | ESD73034D |  | https://item.szlcsc.com/datasheet/ESD73034D/8170920.html
130 | VL817 | 1 | U1601 | QFN76-p0_4-9_0x9_0-h1_0 | USB3.1 HUB 芯片，1扩4 | 威锋 | VL817-Q7(B0) |  | https://item.szlcsc.com/datasheet/VL817-Q7(B0)/210703.html
131 | P25Q40H | 1 | U1607 | TSSOP8-p0_65-3_0x6_4-h1_2 | 串行接口闪存存储器 4Mbit | 普冉 | P25Q40H |  | https://item.szlcsc.com/datasheet/P25Q40SH-SSH-IT/3005000.html
132 | CAG94104SQNAR | 7 | U1610,U2401,U2402,U2403,U2404,U2405,U2406 | QFN12-2_5x2_8-h0_55 | 双向电平转换芯片 | SENSYLINK | CAG94104SQNAR |  | CAG94104SQNAR
133 | TS3USB30E | 1 | U1903 | QFN010R_P040_0018X0014 | TS3USB30E 具有单独使能和 ESD 保护的高速 USB 2.0 1:2 多路复用/多路解复用开关 | TI | TS3USB30ERSWR |  | https://www.ti.com/cn/lit/ds/symlink/ts3usb30e.pdf?ts=1761032869609
134 | GT24C02B-2TFLI-TR | 1 | U2501 | SOT5-3_5x3_7-h1_25 | EEPROM 2K Bits | 聚辰 | GT24C02B-2TFLI-TR
135 | MCP2562FD | 1 | U2502 | DFN8-0_65-3_0X3_0H2_4X1_6-H1_0 | 高速CAN灵活数据速率收发器 | MICROCHIP | MCP2562FD-E/MF |  | https://item.szlcsc.com/datasheet/MCP2562FD-E%252FMF/664791.html
136 | 25MHz,10pF,20PPM | 1 | Y1601 | TSX-3225 | 25MHz ±15ppm 8pF | NDK | NX3225SA-25.000MHz-STD-CRS-2 |  | https://item.szlcsc.com/datasheet/NX3225SA-25.000MHz-STD-CRS-2/2077387.html
137 | 32.768KHz 25ppm | 2 | Y2201,Y2301 | XTAL_SMD_4_032X025_D | 32.768KHz 25ppm | HOSONIC | D3SX003270004E |  | https://www.hosonic.com/Upload/202409/product_2024092820015506.pdf
138 | 32.768KHz 25ppm | 1 | Y2302 | XTAL_SMD_4_032X025_D |  |  |  | NC

Sheet: Sheet1
1
2
3
4
5
6
7
8
9
10
11
12
13
14
15
16
17
18
19
20
21
22
23
24
25
26
27
28
29
30
31
32
33
34
35
36
37
38
39
40
41
42
43
44
45
46
47
48
49
50
51
52
53
54
55
56
57
58
59
60
61
62
63
64
65
66
67
68
69
70
71
72
73
74
75
76
77
78
79
80
81
82
83
84
85
86
87
88
89
90
91
92
93
94
95
96
97
98
99
100
101
102
103
104
105
106
107
108
109
110
111
112
113
114
115
116
117
118
119
120
