Lain-Ego0/G-Exo/1.hardware/G-exo/镜向打印件-方碳管-长碳管链接V2-2.STEP

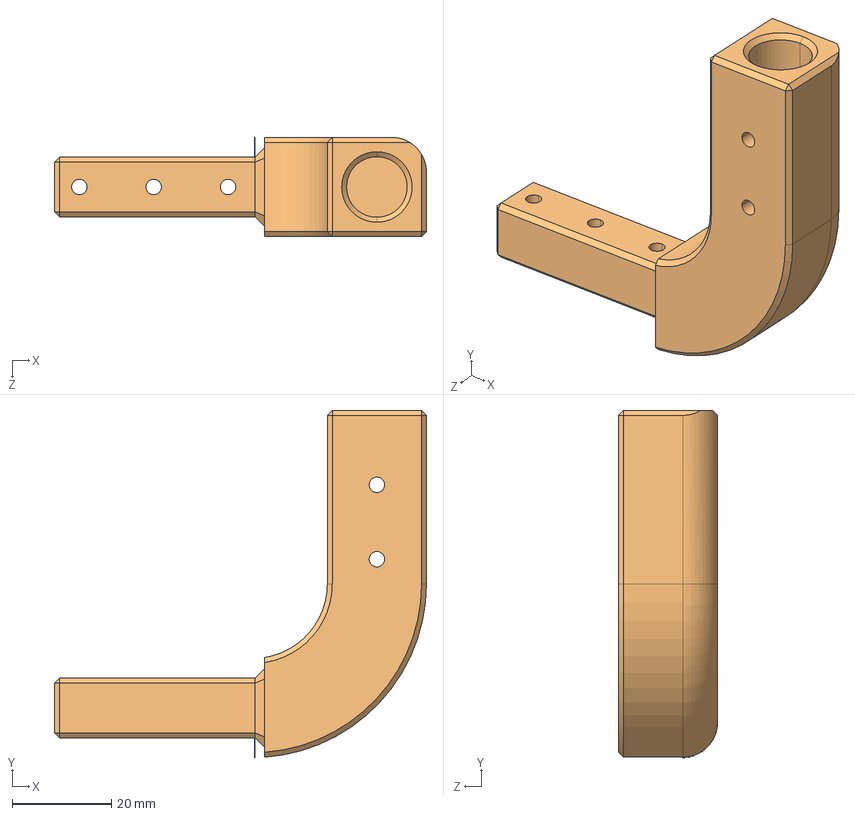
[picture p6: CAD file, 2026-10-31]
1.hardware/G-exo/镜向打印件-方碳管-长碳管链接V2-2.STEP
75.0 x 70.0 x 20.0 mm
