Lain-Ego0/G-Exo/1.hardware/G-exo_URDF/meshes/l_thigh.STL

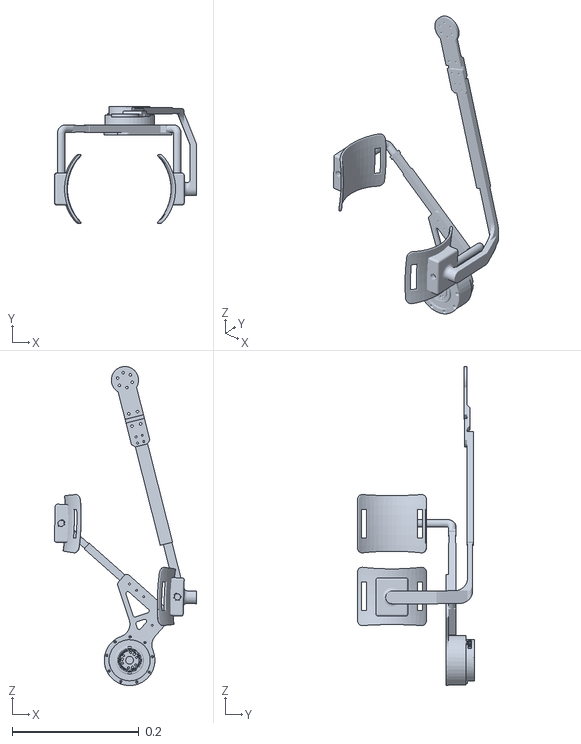
[picture p7: CAD file, 2026-07-26]
1.hardware/G-exo_URDF/meshes/l_thigh.STL
0.224 x 0.185 x 0.503
