Lain-Ego0/G-Exo/1.hardware/腰部悬臂.STEP

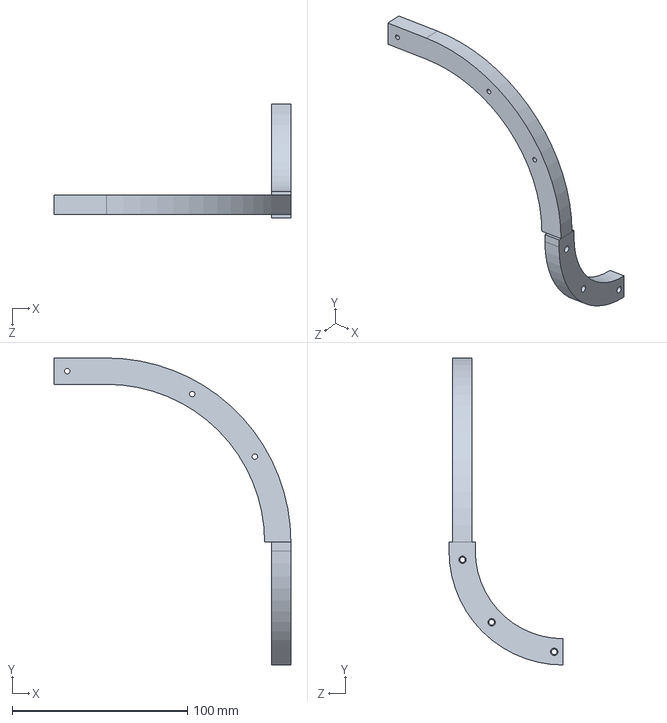
[picture p8: CAD file, 2026-10-31]
1.hardware/腰部悬臂.STEP
135.0 x 175.0 x 65.0 mm
