Lain-Ego0/G-Exo/4.document/DM-J4340-2EC/3D模型/DM-J4340-2EC-V1.1_3d_20260325_1.stp

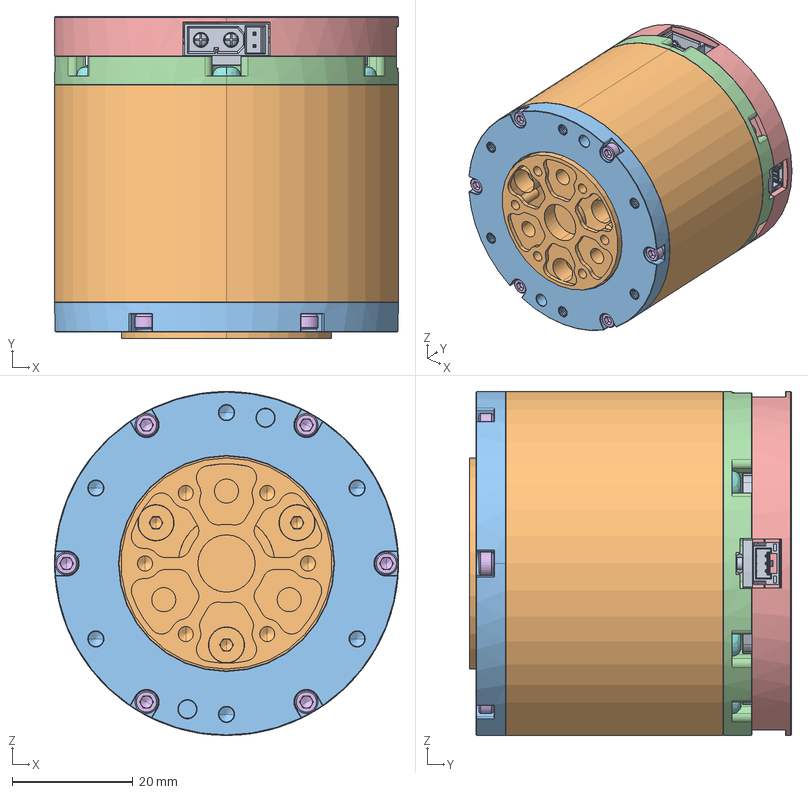
[picture p9: CAD file, 2026-06-28]
4.document/DM-J4340-2EC/3D模型/DM-J4340-2EC-V1.1_3d_20260325_1.stp
57.0 x 53.3 x 57.0 mm
DM_4340_3D_1_1_1_1_4
4340__3D_20240814_1_2_4
G43_V1_1_3-230824_4
4040V300
M2_5-800 x 6
M2_5-L4 x 4
M2_5-L6 x 7
_M2_5-100001 x 4
