Lain-Ego0/G-Exo/1.hardware/加强件.STEP

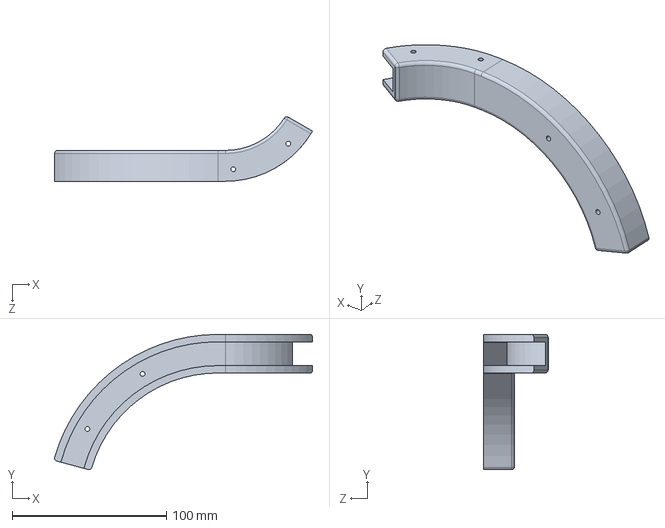
[picture p10: CAD file, 2026-10-31]
1.hardware/加强件.STEP
167.1 x 87.6 x 41.8 mm
