Lain-Ego0/G-Exo/1.hardware/G-exo/镜向碳板-电机内部固定-11.SLDPRT

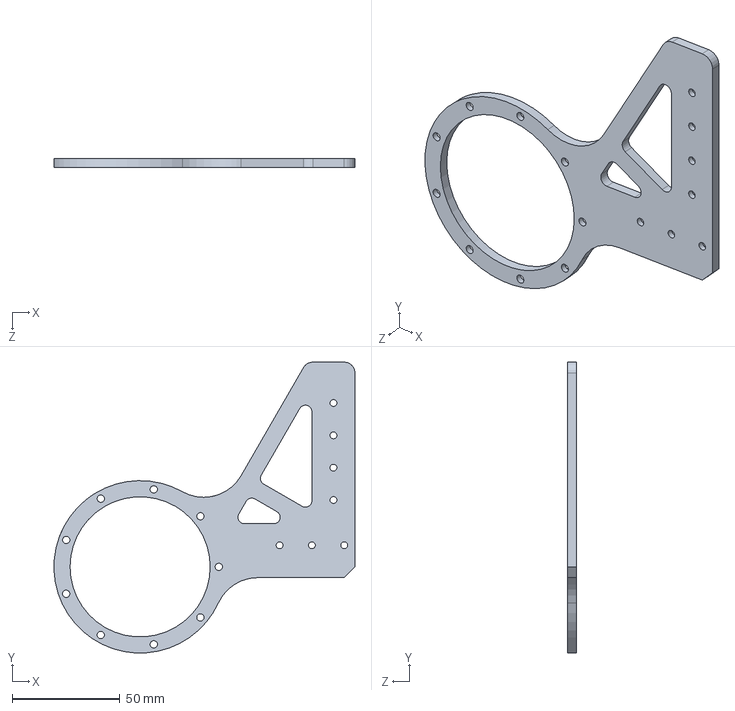
[picture p11: CAD file, 2026-10-31]
1.hardware/G-exo/镜向碳板-电机内部固定-11.SLDPRT
139.6 x 134.9 x 4.00 mm
