Lain-Ego0/G-Exo/1.hardware/G-exo_URDF/meshes/l_calf.STL

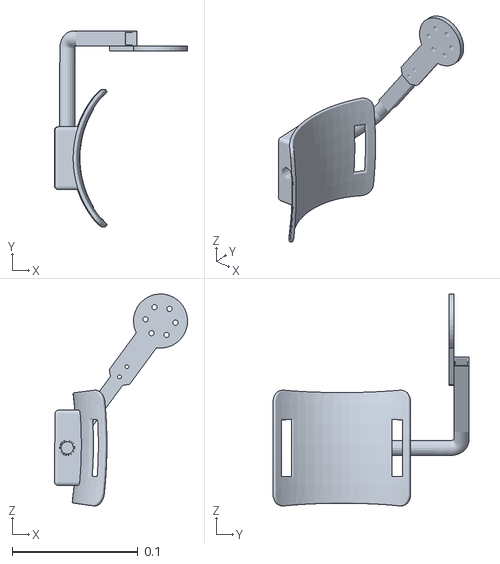
[picture p12: CAD file, 2026-07-26]
1.hardware/G-exo_URDF/meshes/l_calf.STL
0.106 x 0.156 x 0.168
