Lain-Ego0/G-Exo/1.hardware/G-exo/镜向打印件-圆管管夹1.STEP

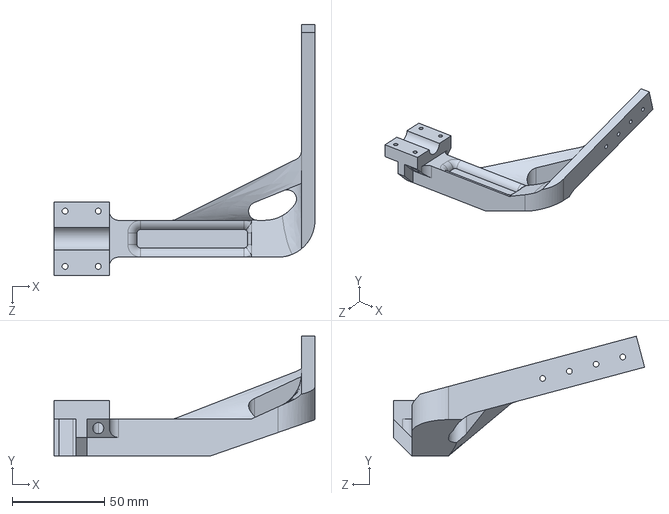
[picture p13: CAD file, 2026-10-31]
1.hardware/G-exo/镜向打印件-圆管管夹1.STEP
141.5 x 64.9 x 136.3 mm
