Lain-Ego0/G-Exo/1.hardware/G-exo_URDF/meshes/base_link.STL

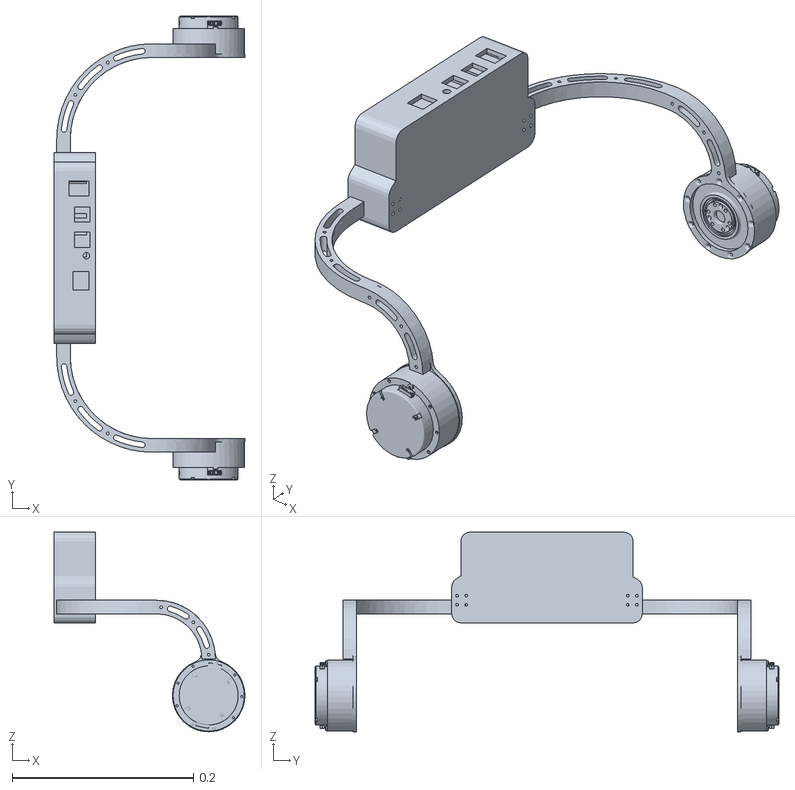
[picture p14: CAD file, 2026-07-26]
1.hardware/G-exo_URDF/meshes/base_link.STL
0.21 x 0.511 x 0.22
