Lain-Ego0/G-Exo/1.hardware/G-exo/护垫2.0.STEP

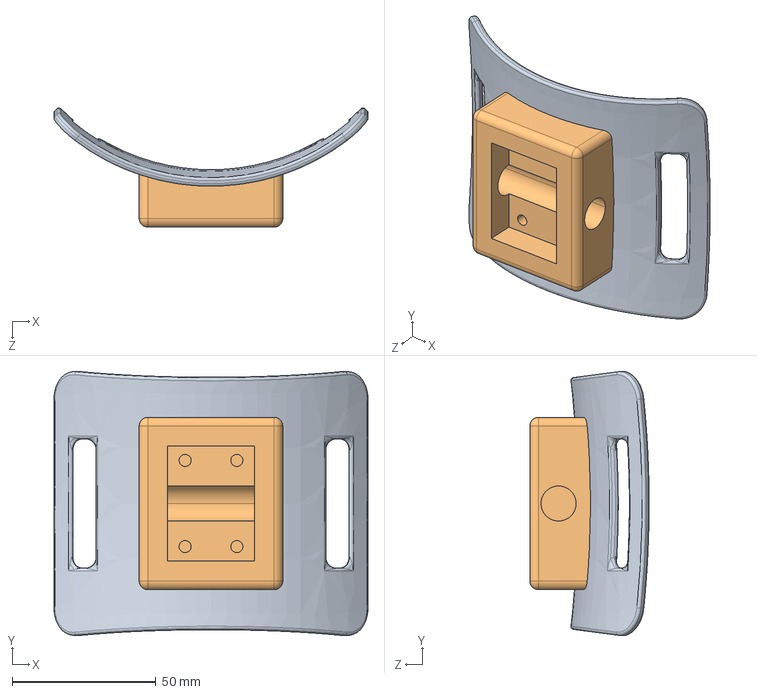
[picture p15: CAD file, 2026-10-31]
1.hardware/G-exo/护垫2.0.STEP
109.3 x 92.1 x 41.5 mm
