Lain-Ego0/G-Exo/1.hardware/G-exo/标准件/镜向GB╱T 70.1-2008[内六角圆柱头螺钉M3×12].SLDPRT

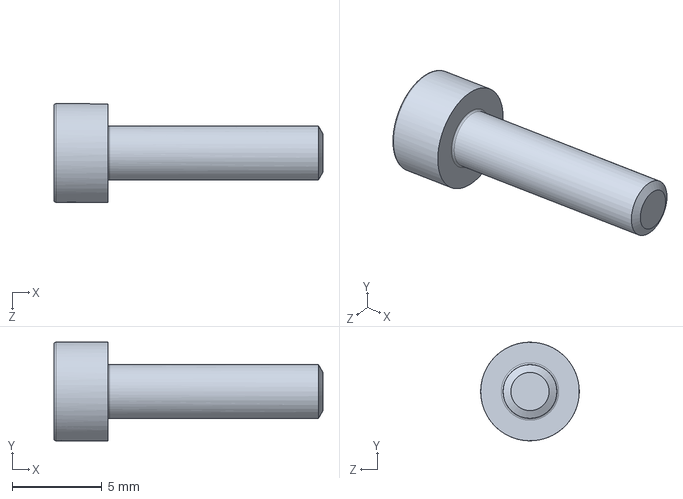
[picture p16: CAD file, 2026-10-31]
1.hardware/G-exo/标准件/镜向GB╱T 70.1-2008[内六角圆柱头螺钉M3×12].SLDPRT
15.0 x 5.50 x 5.50 mm
