Lain-Ego0/G-Exo/1.hardware/G-exo/标准件/GB╱T 70.2-2015[内六角平圆头螺钉M3×16].sldprt

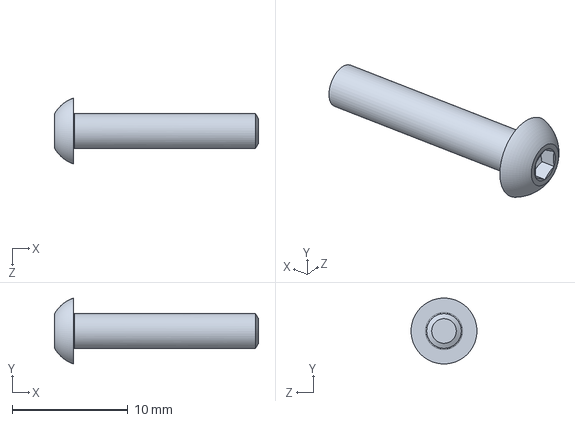
[picture p18: CAD file, 2026-09-22]
1.hardware/G-exo/标准件/GB╱T 70.2-2015[内六角平圆头螺钉M3×16].sldprt
17.7 x 5.70 x 5.70 mm
