Lain-Ego0/G-Exo/1.hardware/G-exo/镜向碳管-大腿1.SLDPRT

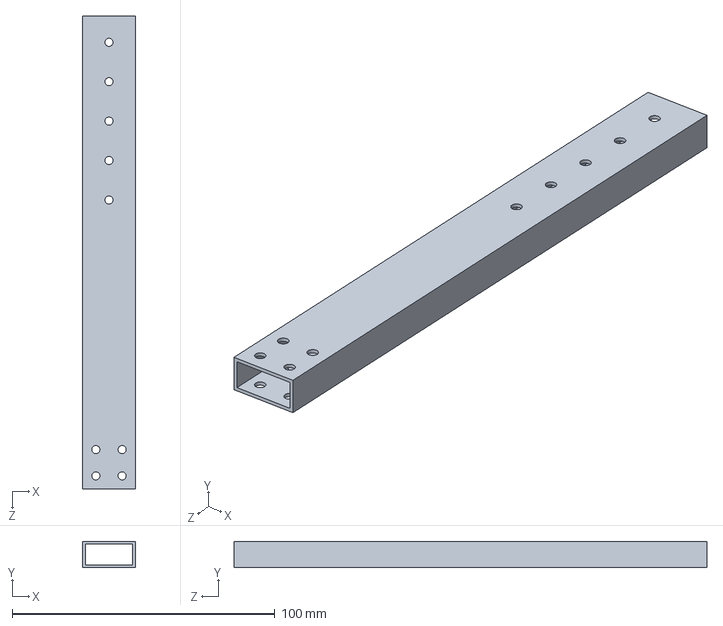
[picture p19: CAD file, 2026-10-31]
1.hardware/G-exo/镜向碳管-大腿1.SLDPRT
20.0 x 10.0 x 180.0 mm
