Lain-Ego0/G-Exo/1.hardware/G-exo/标准件/GB╱T 70.3-2008[内六角沉头螺钉M3×20].sldprt

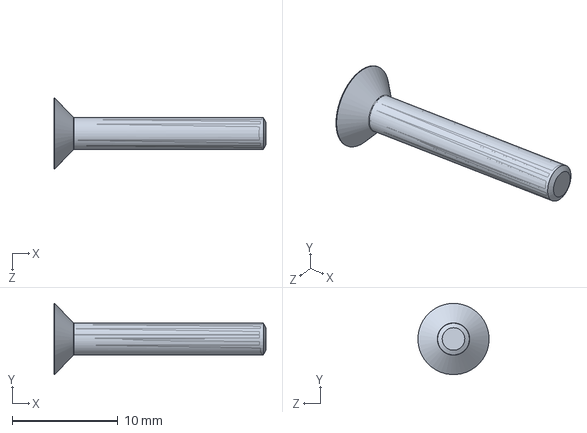
[picture p21: CAD file, 2026-09-22]
1.hardware/G-exo/标准件/GB╱T 70.3-2008[内六角沉头螺钉M3×20].sldprt
20.0 x 6.72 x 6.72 mm
