Lain-Ego0/G-Exo/1.hardware/G-exo/碳板改打印件-大腿.STEP

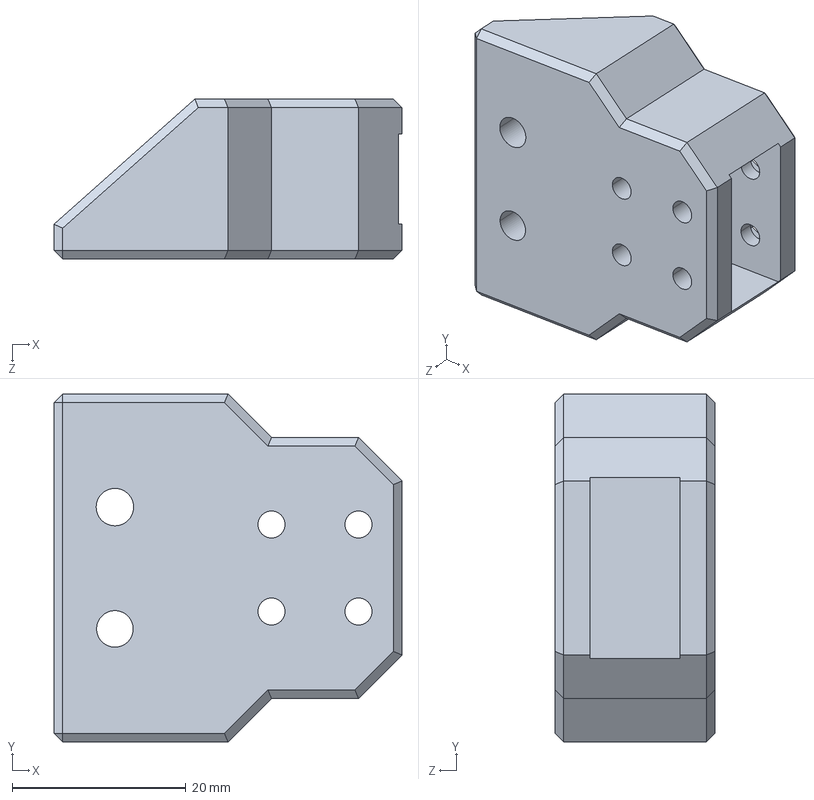
[picture p22: CAD file, 2026-10-31]
1.hardware/G-exo/碳板改打印件-大腿.STEP
40.0 x 40.0 x 18.4 mm
