Lain-Ego0/G-Exo/1.hardware/G-exo/镜向打印件-方碳管-长碳管链接1.SLDPRT

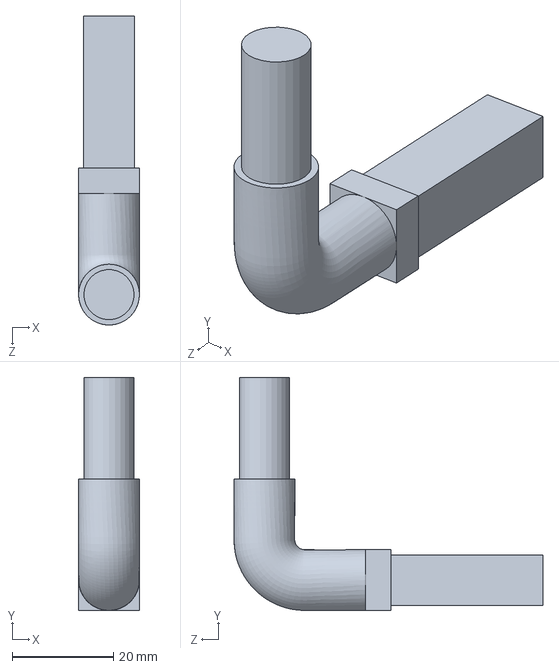
[picture p23: CAD file, 2026-10-31]
1.hardware/G-exo/镜向打印件-方碳管-长碳管链接1.SLDPRT
12.0 x 46.0 x 61.0 mm
