Lain-Ego0/G-Exo/1.hardware/G-exo/镜向打印件-电机外部装饰-1.SLDPRT

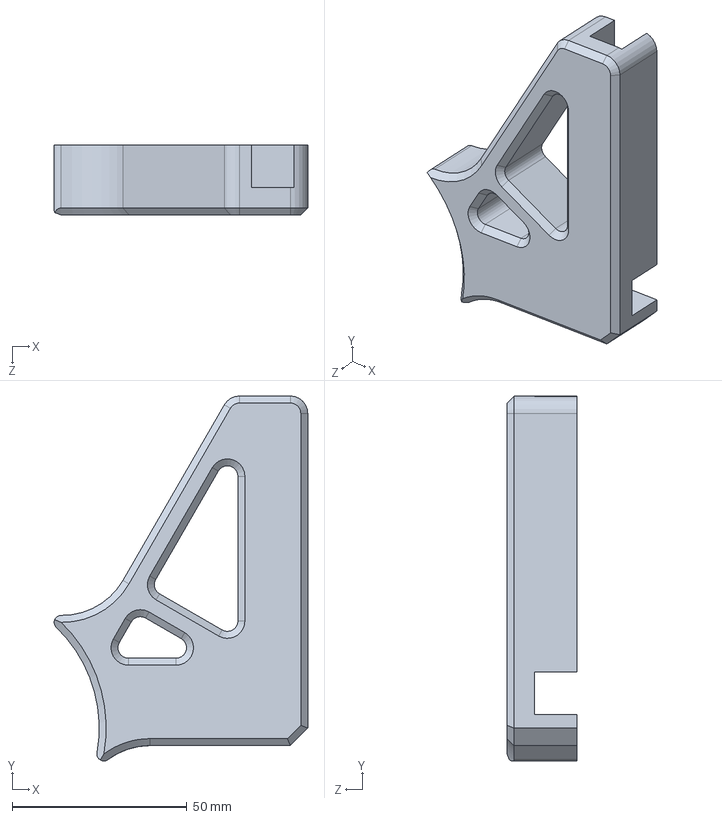
[picture p24: CAD file, 2026-10-31]
1.hardware/G-exo/镜向打印件-电机外部装饰-1.SLDPRT
72.6 x 104.4 x 20.0 mm
