Lain-Ego0/G-Exo/1.hardware/G-exo/镜向碳板-大腿1.SLDPRT

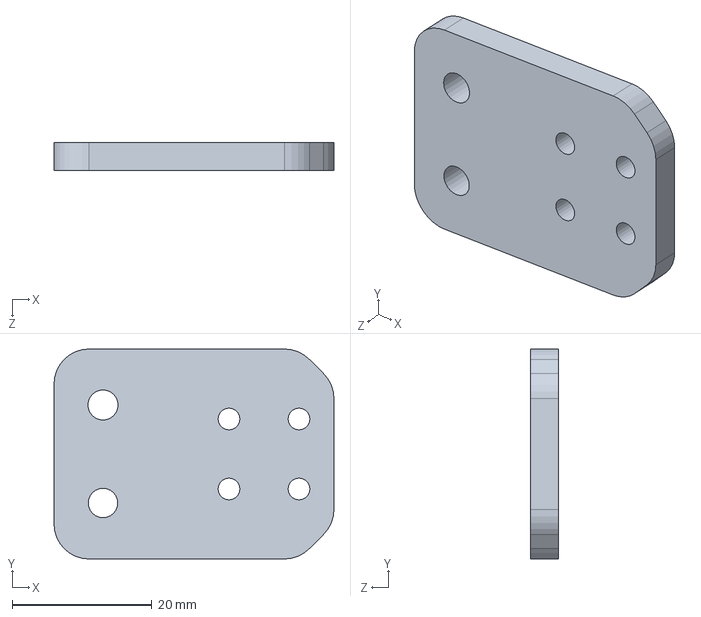
[picture p25: CAD file, 2026-10-31]
1.hardware/G-exo/镜向碳板-大腿1.SLDPRT
40.0 x 30.0 x 4.00 mm
