Lain-Ego0/G-Exo/1.hardware/G-exo/镜向rs02.stp1.SLDPRT

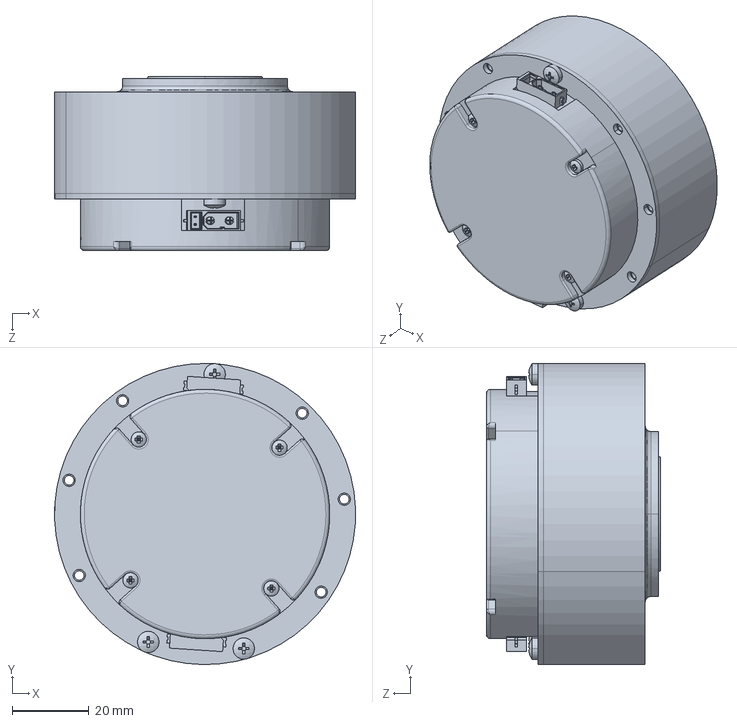
[picture p26: CAD file, 2026-10-31]
1.hardware/G-exo/镜向rs02.stp1.SLDPRT
78.5 x 78.5 x 45.4 mm
