Lain-Ego0/G-Exo/1.hardware/G-exo/腰部悬臂.SLDPRT

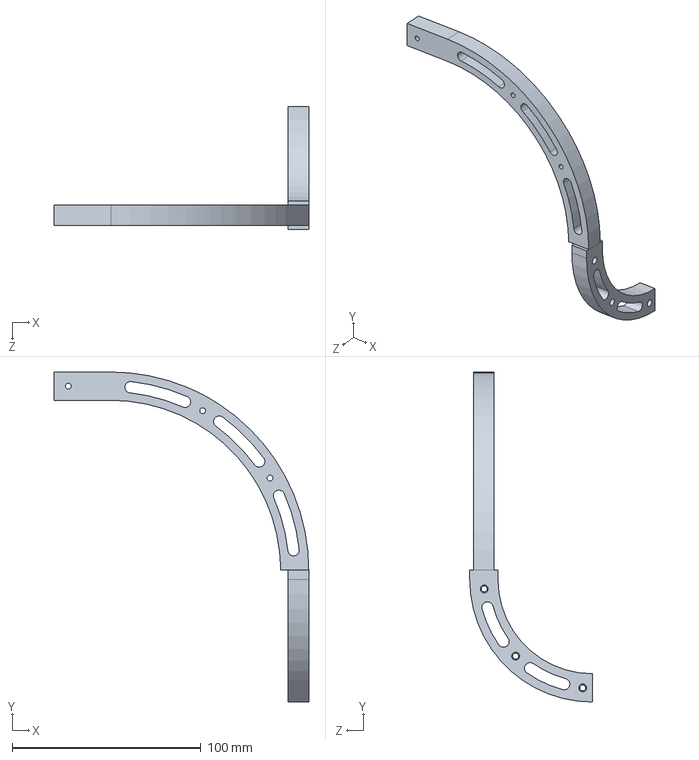
[picture p27: CAD file, 2026-09-22]
1.hardware/G-exo/腰部悬臂.SLDPRT
135.0 x 175.0 x 65.0 mm
