Lain-Ego0/G-Exo/1.hardware/G-exo/主控制器盖板.SLDPRT

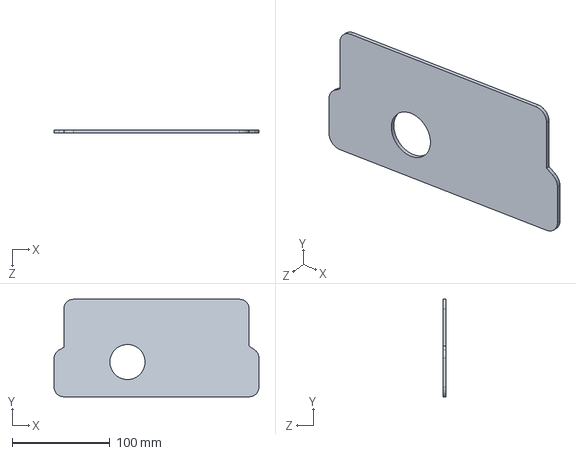
[picture p28: CAD file, 2026-09-22]
1.hardware/G-exo/主控制器盖板.SLDPRT
210.0 x 100.0 x 3.00 mm
