Lain-Ego0/G-Exo/1.hardware/G-exo/碳板-腰部悬臂加强件-1.SLDPRT

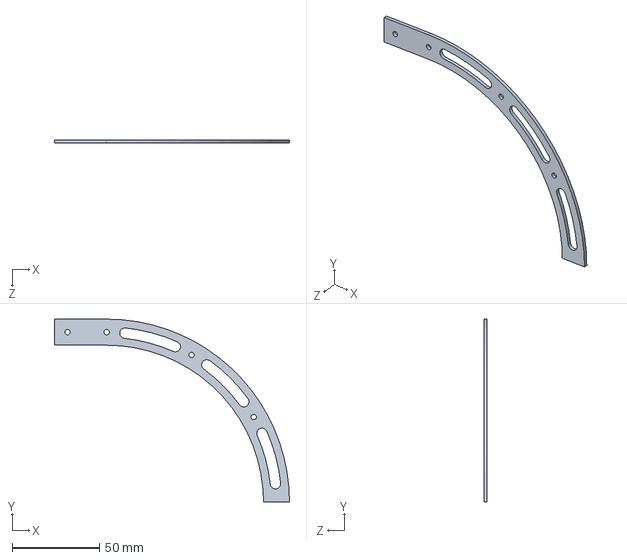
[picture p29: CAD file, 2026-09-22]
1.hardware/G-exo/碳板-腰部悬臂加强件-1.SLDPRT
135.0 x 105.0 x 2.00 mm
