Lain-Ego0/G-Exo/1.hardware/G-exo/测试-模拟小腿.SLDPRT

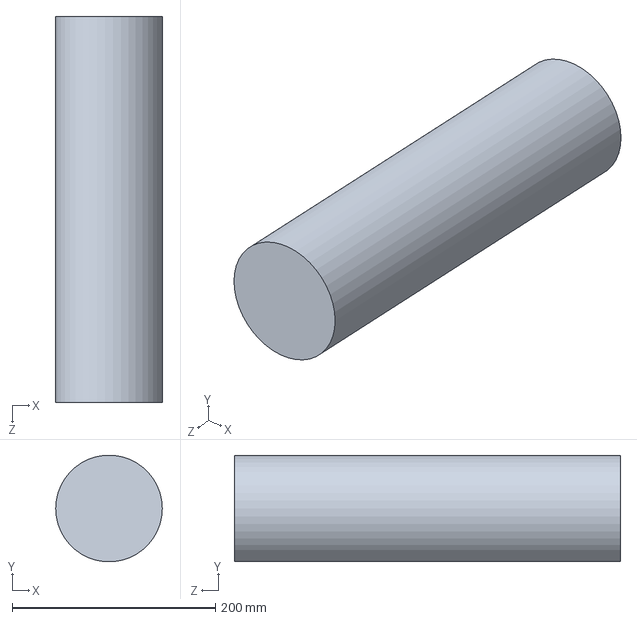
[picture p30: CAD file, 2026-09-22]
1.hardware/G-exo/测试-模拟小腿.SLDPRT
105.0 x 104.7 x 380.0 mm
