Lain-Ego0/G-Exo/1.hardware/G-exo/小腿电机出轴链接件.SLDPRT

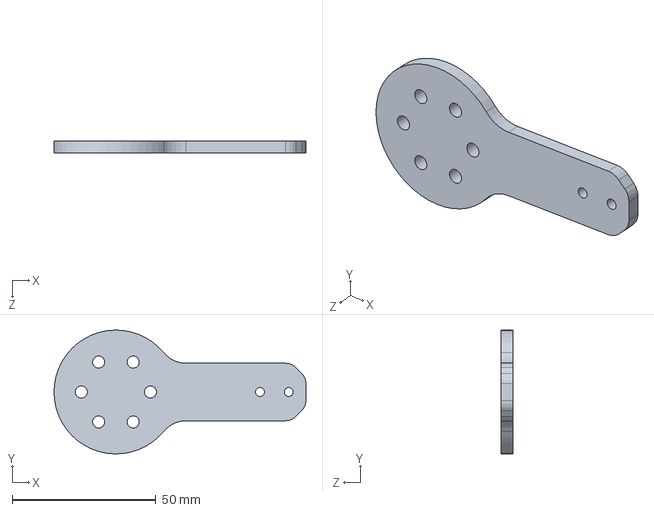
[picture p31: CAD file, 2026-09-22]
1.hardware/G-exo/小腿电机出轴链接件.SLDPRT
87.5 x 43.0 x 4.00 mm
