Lain-Ego0/G-Exo/1.hardware/G-exo/测试-模拟大腿.SLDPRT

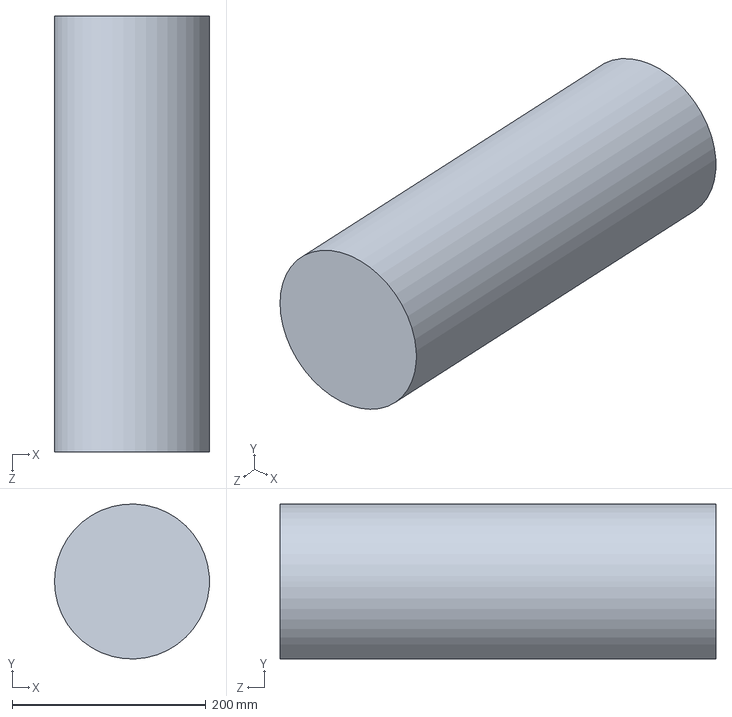
[picture p32: CAD file, 2026-09-22]
1.hardware/G-exo/测试-模拟大腿.SLDPRT
160.0 x 159.9 x 450.0 mm
