Lain-Ego0/G-Exo/1.hardware/G-exo/碳板-电机内部固定.SLDPRT

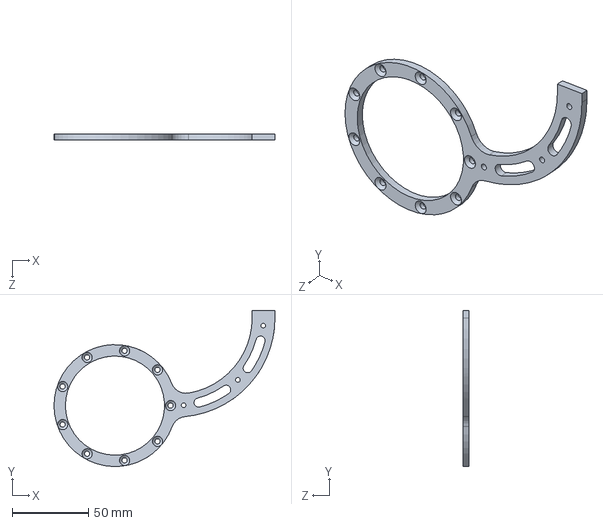
[picture p33: CAD file, 2026-09-22]
1.hardware/G-exo/碳板-电机内部固定.SLDPRT
145.0 x 102.4 x 4.00 mm
