Lain-Ego0/G-Exo/1.hardware/G-exo/方形碳管-2.SLDPRT

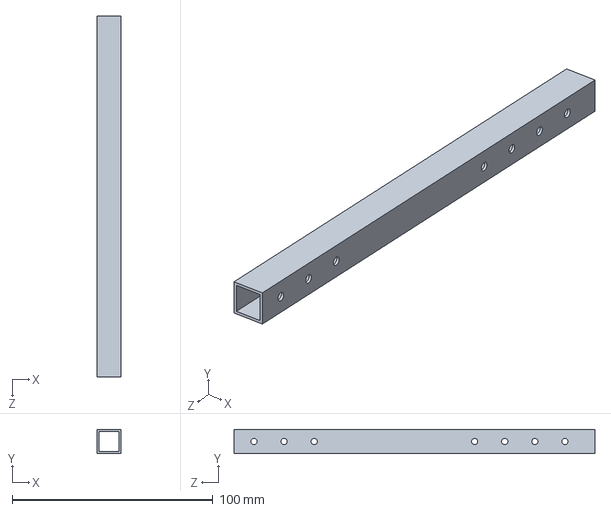
[picture p34: CAD file, 2026-09-22]
1.hardware/G-exo/方形碳管-2.SLDPRT
12.0 x 12.0 x 180.0 mm
