Lain-Ego0/G-Exo/1.hardware/G-exo/碳管-大腿.SLDPRT

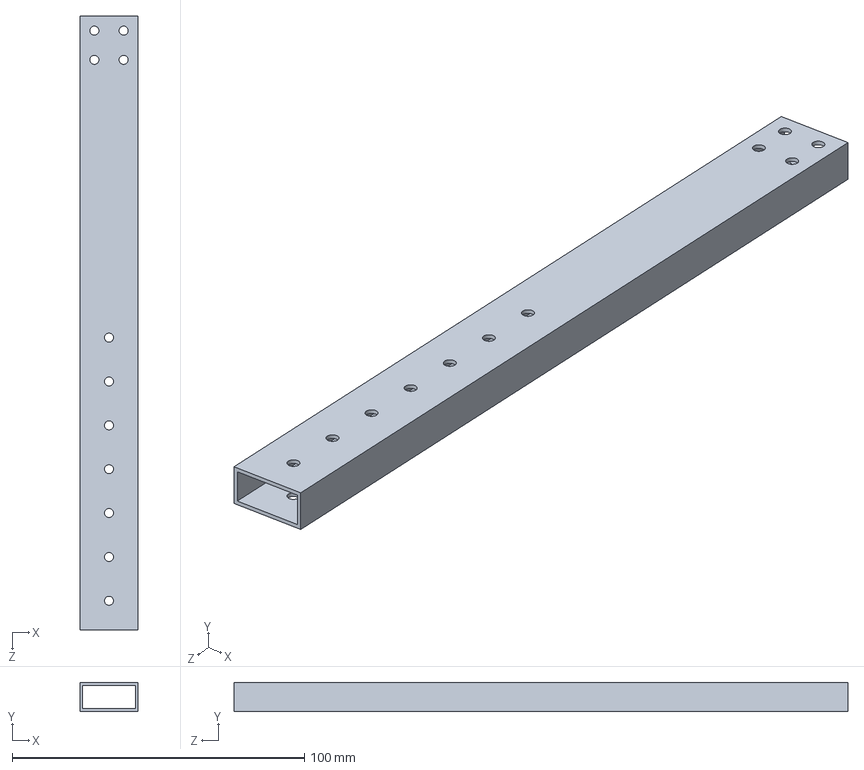
[picture p35: CAD file, 2026-09-22]
1.hardware/G-exo/碳管-大腿.SLDPRT
20.0 x 10.0 x 210.0 mm
