Lain-Ego0/G-Exo/1.hardware/G-exo/K3 CoM260 Kit.SLDPRT

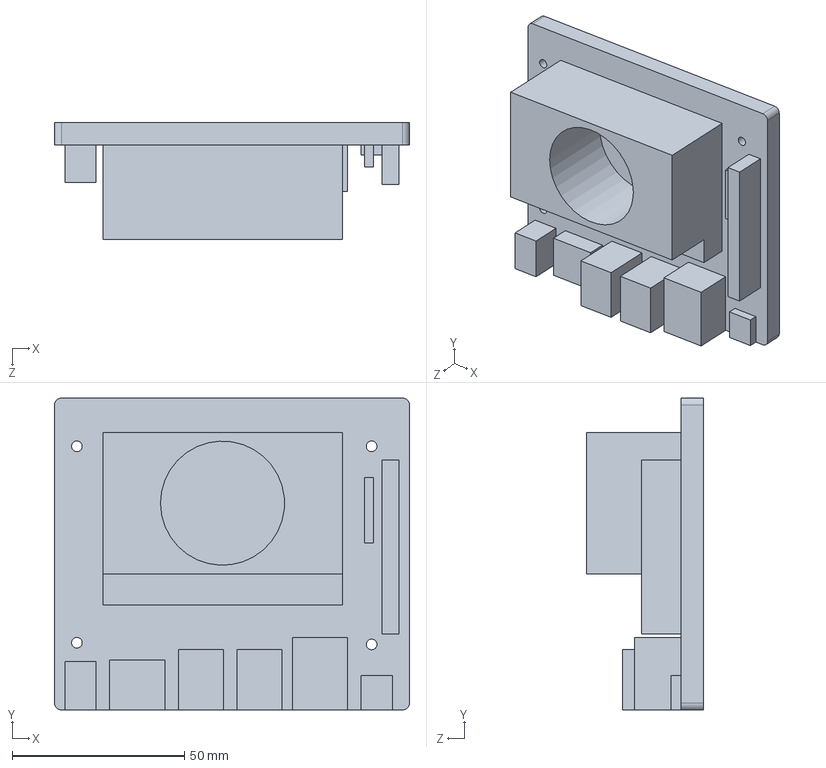
[picture p36: CAD file, 2026-09-22]
1.hardware/G-exo/K3 CoM260 Kit.SLDPRT
103.0 x 90.5 x 34.0 mm
