Lain-Ego0/G-Exo/1.hardware/G-exo/大腿电机出轴连接件.SLDPRT

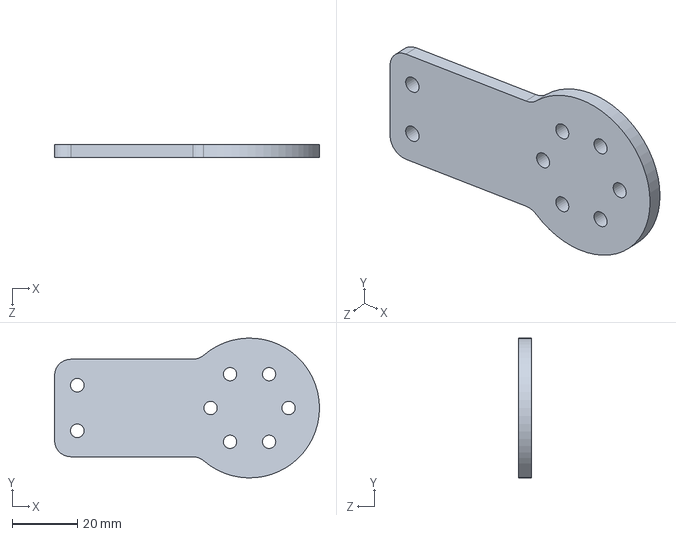
[picture p37: CAD file, 2026-09-22]
1.hardware/G-exo/大腿电机出轴连接件.SLDPRT
81.5 x 43.0 x 4.00 mm
