Lain-Ego0/G-Exo/1.hardware/G-exo/打印件-方碳管-长碳管链接V2-1.SLDPRT

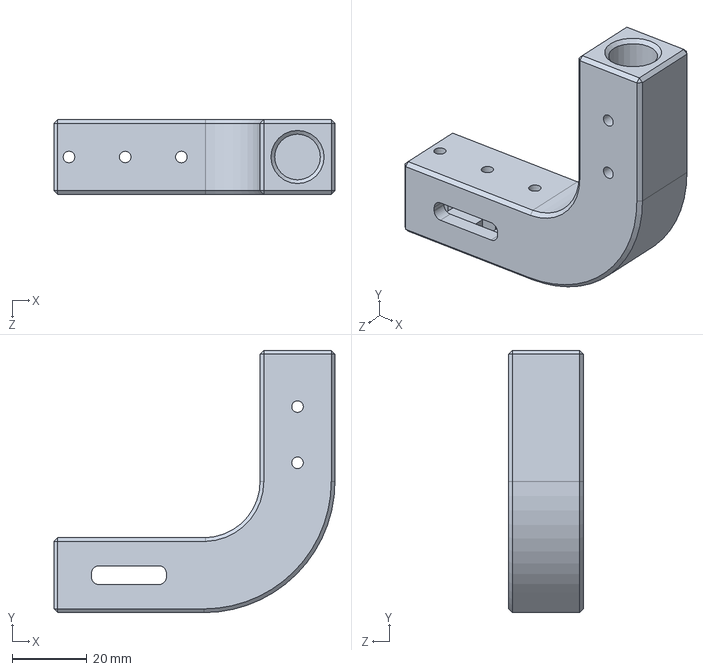
[picture p38: CAD file, 2026-09-22]
1.hardware/G-exo/打印件-方碳管-长碳管链接V2-1.SLDPRT
75.0 x 70.0 x 20.0 mm
