Lain-Ego0/G-Exo/1.hardware/G-exo/打印件-方碳管-长碳管链接.SLDPRT

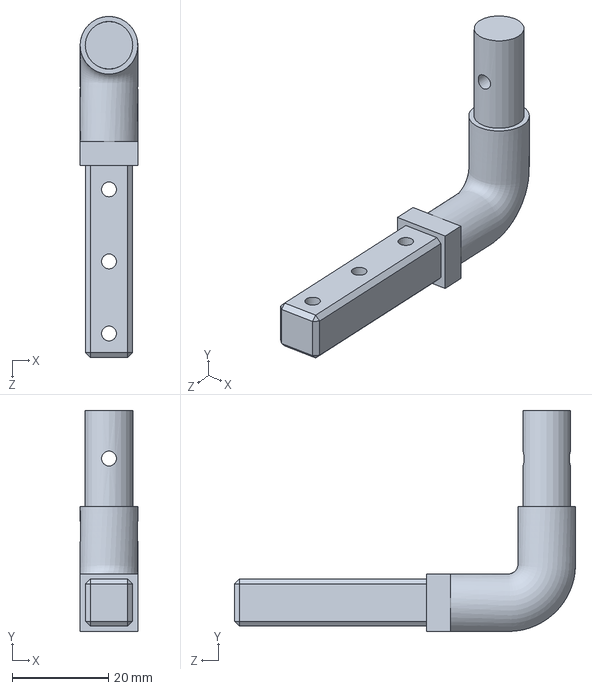
[picture p39: CAD file, 2026-09-22]
1.hardware/G-exo/打印件-方碳管-长碳管链接.SLDPRT
12.0 x 46.0 x 71.0 mm
