Lain-Ego0/G-Exo/1.hardware/G-exo/护腰.SLDPRT

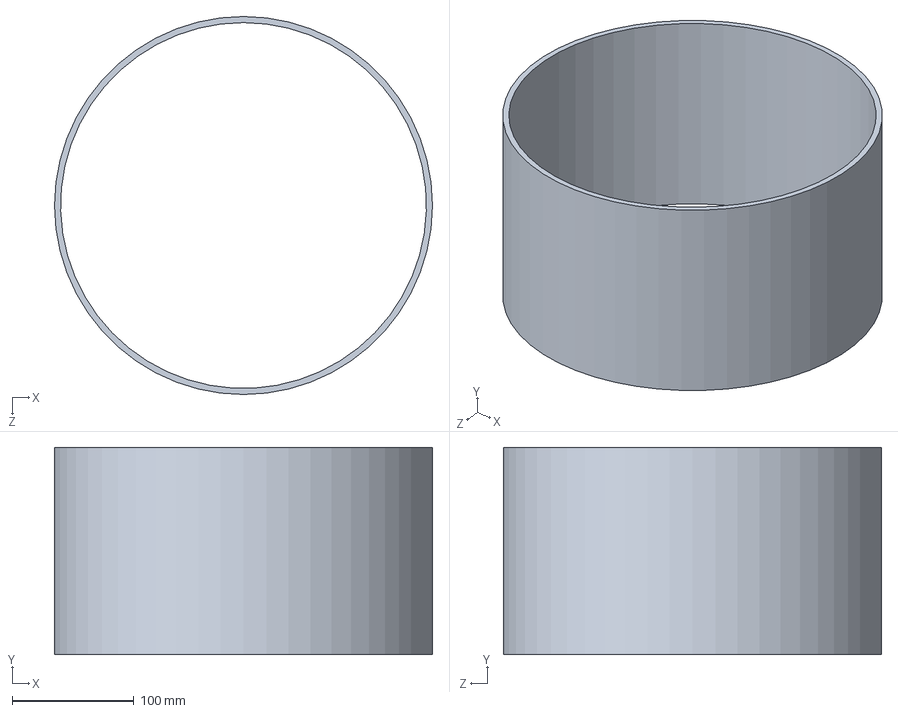
[picture p40: CAD file, 2026-09-22]
1.hardware/G-exo/护腰.SLDPRT
310.0 x 170.0 x 310.0 mm
