Lain-Ego0/G-Exo/1.hardware/G-exo/测试-连接碳管.SLDPRT

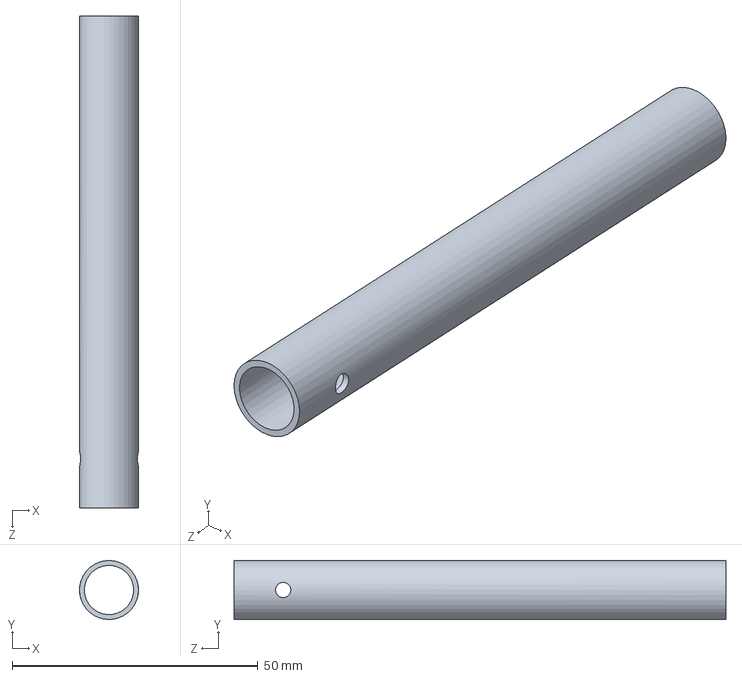
[picture p41: CAD file, 2026-09-22]
1.hardware/G-exo/测试-连接碳管.SLDPRT
12.0 x 12.0 x 100.0 mm
