Lain-Ego0/G-Exo/(list of files, cad)

Other CAD files:
1.hardware/G-exo/G-exo.SLDASM
1.hardware/G-exo/标准件/镜向GB╱T 70.3-2008[内六角沉头螺钉M3×20].SLDPRT
1.hardware/G-exo/标准件/镜向GB╱T 70.2-2015[内六角平圆头螺钉M4×10].SLDPRT
1.hardware/G-exo/镜向测试-连接碳管1.SLDPRT
1.hardware/G-exo_URDF/meshes/r_thigh.STL
1.hardware/G-exo/标准件/镜向GB╱T 70.2-2015[内六角平圆头螺钉M3×16].SLDPRT
1.hardware/打印件-方碳管-长碳管链接V2-2.STEP
1.hardware/G-exo/标准件/镜向GB╱T 70.3-2008[内六角沉头螺钉M4×12].SLDPRT
1.hardware/镜向腰部悬臂1.STEP
1.hardware/G-exo/标准件/镜向GB╱T 70.2-2015[内六角平圆头螺钉M3×20].SLDPRT
1.hardware/G-exo/镜向打印件-圆管管夹-后1.SLDPRT
1.hardware/G-exo_URDF/meshes/r_calf.STL
1.hardware/镜向加强件.STEP
1.hardware/G-exo/标准件/镜向GB╱T 70.3-2008[内六角沉头螺钉M3×10].SLDPRT
1.hardware/G-exo/镜向护垫2.01.SLDPRT
1.hardware/镜向打印件-方碳管-长碳管链接V2-2.STEP
1.hardware/G-exo/镜向碳板-电机内部固定1.SLDPRT
1.hardware/G-exo/标准件/镜向GB╱T 70.2-2015[内六角平圆头螺钉M3×20]1.SLDPRT
1.hardware/G-exo/镜向方形碳管-21.SLDPRT
1.hardware/G-exo/镜向碳板-腰部悬臂加强件-11.SLDPRT
1.hardware/G-exo/镜向小腿电机出轴链接件1.SLDPRT
1.hardware/G-exo/镜向加强件.SLDPRT
1.hardware/G-exo/镜向碳板改打印件-大腿.SLDPRT
1.hardware/G-exo/镜向大腿铰链1.SLDPRT
1.hardware/G-exo/镜向方形碳管-11.SLDPRT
1.hardware/G-exo/打印件-圆管管夹.STEP
1.hardware/G-exo/镜向方形碳管-31.SLDPRT
1.hardware/G-exo/镜向腰部悬臂1.SLDPRT
1.hardware/G-exo/打印件-方碳管-长碳管链接V2-2.STEP
1.hardware/G-exo/镜向大腿电机出轴连接件1.SLDPRT
1.hardware/G-exo/镜向打印件-方碳管-长碳管链接V2-1.SLDPRT
1.hardware/G-exo/镜向打印件-碳管内垫.SLDPRT
1.hardware/G-exo/rs02.stp.SLDPRT
1.hardware/G-exo/碳板-大腿.SLDPRT
1.hardware/G-Exo V1/01.00.00.00 - Corpo Humano.stp
1.hardware/G-Exo V1/Exoskeleton 4340_4310P.SLDASM
1.hardware/G-Exo V1/G-exo.SLDASM
1.hardware/G-Exo V1/rs02.stp.SLDPRT
1.hardware/G-Exo V1/主控制器与背板.SLDPRT
1.hardware/G-Exo V1/打印件-方碳管-长碳管链接.SLDPRT
1.hardware/G-Exo V1/护垫.SLDPRT
1.hardware/G-Exo V1/镜向大腿电机出轴连接件1.SLDPRT
1.hardware/G-Exo V1/镜向大腿铰链1.SLDPRT
1.hardware/G-Exo V1/镜向小腿电机出轴链接件.SLDPRT
1.hardware/G-Exo V1/镜向打印件-圆管管夹-后1.SLDPRT
1.hardware/G-Exo V1/镜向打印件-圆管管夹1.SLDPRT
1.hardware/G-Exo V1/镜向打印件-方碳管-长碳管链接.SLDPRT
1.hardware/G-Exo V1/镜向护垫2.01.SLDPRT
1.hardware/G-Exo V1/镜向方形碳管-11.SLDPRT
1.hardware/G-Exo V1/镜向方形碳管-21.SLDPRT
1.hardware/G-Exo V1/镜向方形碳管-31.SLDPRT
1.hardware/G-Exo V1/镜向测试-连接碳管.SLDPRT
1.hardware/G-Exo V1/镜向测试-连接碳管1.SLDPRT
1.hardware/G-Exo V1/镜向碳板-大腿1.SLDPRT
1.hardware/G-Exo V1/镜向碳管-大腿1.SLDPRT
1.hardware/G-Exo V2/G-exo.SLDASM
1.hardware/G-Exo V2/K3 CoM260 Kit.SLDPRT
1.hardware/G-Exo V2/K3 CoM260 Kit.STEP
1.hardware/G-Exo V2/主控制器与背板.SLDPRT
1.hardware/G-Exo V2/主控制器盖板.SLDPRT
1.hardware/G-Exo V2/大腿电机固定.SLDPRT
1.hardware/G-Exo V2/打印件-圆管管夹-后.SLDPRT
1.hardware/G-Exo V2/打印件-圆管管夹.SLDPRT
1.hardware/G-Exo V2/打印件-方碳管-长碳管链接.SLDPRT
1.hardware/G-Exo V2/打印件-电机外部装饰-1.SLDPRT
1.hardware/G-Exo V2/打印件/大腿链接.gcode.3mf
1.hardware/G-Exo V2/打印件/悬臂+装饰.gcode.3mf
1.hardware/G-Exo V2/打印件/打印件-圆管管夹.STEP
1.hardware/G-Exo V2/打印件/打印件-方碳管-长碳管链接.STEP
1.hardware/G-Exo V2/打印件/打印件-电机外部装饰-1.STEP
1.hardware/G-Exo V2/打印件/打印件-碳方转碳管.gcode.3mf
1.hardware/G-Exo V2/打印件/护垫2.0.STEP
1.hardware/G-Exo V2/打印件/碳板改打印件-大腿.STEP
1.hardware/G-Exo V2/打印件/腰部悬臂.STEP
1.hardware/G-Exo V2/打印件/镜向打印件-圆管管夹1.STEP
1.hardware/G-Exo V2/打印件/镜向打印件-电机外部装饰-1.STEP
1.hardware/G-Exo V2/打印件/镜向腰部悬臂1.STEP
1.hardware/G-Exo V2/护垫2.0.SLDPRT
1.hardware/G-Exo V2/方形碳管-2.SLDPRT
1.hardware/G-Exo V2/方形碳管-3.SLDPRT
1.hardware/G-Exo V2/标准件/镜向GB╱T 70.1-2008[内六角圆柱头螺钉M3×12].SLDPRT
1.hardware/G-Exo V2/标准件/镜向GB╱T 70.2-2015[内六角平圆头螺钉M3×16].SLDPRT
1.hardware/G-Exo V2/标准件/镜向GB╱T 70.2-2015[内六角平圆头螺钉M3×20].SLDPRT
1.hardware/G-Exo V2/标准件/镜向GB╱T 70.2-2015[内六角平圆头螺钉M4×10].SLDPRT
1.hardware/G-Exo V2/标准件/镜向GB╱T 70.3-2008[内六角沉头螺钉M3×10].SLDPRT
1.hardware/G-Exo V2/标准件/镜向GB╱T 70.3-2008[内六角沉头螺钉M3×20].SLDPRT
1.hardware/G-Exo V2/标准件/镜向GB╱T 70.3-2008[内六角沉头螺钉M4×12].SLDPRT
1.hardware/G-Exo V2/碳件发加工/碳件发加工/碳方管（大腿后侧垫）-12mm-1mm厚-2根.STEP
1.hardware/G-Exo V2/碳件发加工/碳件发加工/碳方管（大腿）-20mmx10mm-1mm厚-2根.STEP
1.hardware/G-Exo V2/碳件发加工/碳件发加工/碳板-腰部悬臂加强件-4块.STEP
1.hardware/G-Exo V2/碳件发加工/碳件发加工/碳板-膝电机出轴链接件-2块.STEP
1.hardware/G-Exo V2/碳件发加工/碳件发加工/碳板-髋关节电机固定（右）-1块.STEP
1.hardware/G-Exo V2/碳板-电机内部固定-1.SLDPRT
1.hardware/G-Exo V2/碳板-电机内部固定.SLDPRT
1.hardware/G-Exo V2/碳板-腰部.SLDPRT
1.hardware/G-Exo V2/碳管-大腿.SLDPRT
1.hardware/G-Exo V2/腰部悬臂.SLDPRT
1.hardware/G-Exo V2/镜向rs02.stp1.SLDPRT
1.hardware/G-Exo V2/镜向大腿电机出轴连接件.SLDPRT
1.hardware/G-Exo V2/镜向大腿电机出轴连接件1.SLDPRT
1.hardware/G-Exo V2/镜向大腿铰链1.SLDPRT
1.hardware/G-Exo V2/镜向小腿电机出轴链接件1.SLDPRT
1.hardware/G-Exo V2/镜向打印件-圆管管夹-后.SLDPRT
1.hardware/G-Exo V2/镜向打印件-圆管管夹-后1.SLDPRT
1.hardware/G-Exo V2/镜向打印件-圆管管夹1.SLDPRT
1.hardware/G-Exo V2/镜向打印件-方碳管-长碳管链接1.SLDPRT
1.hardware/G-Exo V2/镜向打印件-电机外部装饰-1.SLDPRT
1.hardware/G-Exo V2/镜向护垫2.01.SLDPRT
1.hardware/G-Exo V2/镜向方形碳管-11.SLDPRT
1.hardware/G-Exo V2/镜向方形碳管-2.SLDPRT
1.hardware/G-Exo V2/镜向方形碳管-21.SLDPRT
1.hardware/G-Exo V2/镜向方形碳管-3.SLDPRT
1.hardware/G-Exo V2/镜向方形碳管-31.SLDPRT
1.hardware/G-Exo V2/镜向测试-连接碳管1.SLDPRT
1.hardware/G-Exo V2/镜向碳板-大腿1.SLDPRT
1.hardware/G-Exo V2/镜向碳板-电机内部固定-11.SLDPRT
1.hardware/G-Exo V2/镜向碳板-电机内部固定-11.STEP
1.hardware/G-Exo V2/镜向碳板-电机内部固定1.SLDPRT
1.hardware/G-Exo V2/镜向碳板-腰部悬臂加强件-1.SLDPRT
1.hardware/G-Exo V2/镜向碳板-腰部悬臂加强件-11.SLDPRT
1.hardware/G-Exo V2/镜向碳管-大腿1.SLDPRT
1.hardware/G-Exo V2/镜向腰部悬臂1.SLDPRT
1.hardware/G-Exo V3/3D_PCB1_2025-08-21.step
1.hardware/G-Exo V3/G-exo.SLDASM
1.hardware/G-Exo V3/K3_PICO_ITX_260528.stp
1.hardware/G-Exo V3/human body model.stp
1.hardware/G-Exo V3/jp30（福来翔-23）.SLDPRT
1.hardware/G-Exo V3/大腿碳管.SLDPRT
1.hardware/G-Exo V3/打印件-圆管管夹.SLDPRT
1.hardware/G-Exo V3/打印件-圆管管夹.STEP
1.hardware/G-Exo V3/打印件-方碳管-长碳管链接-改.SLDPRT
1.hardware/G-Exo V3/打印件-方碳管-长碳管链接.SLDPRT
1.hardware/G-Exo V3/打印件/打印件-圆管管夹-后.3mf
1.hardware/G-Exo V3/打印件/打印件-圆管管夹-后.STEP
1.hardware/G-Exo V3/打印件/打印件-方碳管-长碳管链接-改.STEP
1.hardware/G-Exo V3/打印件/打印件-方碳管-长碳管链接V2-1.STEP
1.hardware/G-Exo V3/打印件/打印件-方碳管-长碳管链接V2-2.STEP
1.hardware/G-Exo V3/打印件/打印件-电机出轴垫片.STEP
1.hardware/G-Exo V3/打印件/打印件-电机外部装饰-1.STEP
1.hardware/G-Exo V3/打印件/打印件-电机外部装饰-12.3mf
1.hardware/G-Exo V3/打印件/打印件-碳管内垫.STEP
1.hardware/G-Exo V3/打印件/护垫2.0.3mf
1.hardware/G-Exo V3/打印件/未命名_plate_1.gcode.3mf
1.hardware/G-Exo V3/打印件/核心仓.STEP
1.hardware/G-Exo V3/打印件/腰部悬臂.STEP
1.hardware/G-Exo V3/打印件/镜向打印件-方碳管-长碳管链接1.STEP
1.hardware/G-Exo V3/打印件/镜向打印件-电机外部装饰-1.STEP
1.hardware/G-Exo V3/打印件/镜向腰部悬臂1.STEP
1.hardware/G-Exo V3/护垫2.0.SLDPRT
1.hardware/G-Exo V3/标准件/GB╱T 70.2-2015[内六角平圆头螺钉M4×16].sldprt
1.hardware/G-Exo V3/标准件/镜向GB╱T 70.1-2008[内六角圆柱头螺钉M3×12].SLDPRT
1.hardware/G-Exo V3/标准件/镜向GB╱T 70.2-2015[内六角平圆头螺钉M3×16].SLDPRT
1.hardware/G-Exo V3/标准件/镜向GB╱T 70.2-2015[内六角平圆头螺钉M3×20].SLDPRT
1.hardware/G-Exo V3/标准件/镜向GB╱T 70.2-2015[内六角平圆头螺钉M3×20]1.SLDPRT
1.hardware/G-Exo V3/标准件/镜向GB╱T 70.2-2015[内六角平圆头螺钉M4×10].SLDPRT
1.hardware/G-Exo V3/标准件/镜向GB╱T 70.3-2008[内六角沉头螺钉M3×10].SLDPRT
1.hardware/G-Exo V3/标准件/镜向GB╱T 70.3-2008[内六角沉头螺钉M3×20].SLDPRT
1.hardware/G-Exo V3/标准件/镜向GB╱T 70.3-2008[内六角沉头螺钉M4×12].SLDPRT
1.hardware/G-Exo V3/核心仓.SLDPRT
1.hardware/G-Exo V3/碳件发加工/碳件发加工/碳圆管-d12mm-1mm厚-8根.STEP
1.hardware/G-Exo V3/碳件发加工/碳件发加工/碳方管（小腿后侧垫）-12mm-1mm厚-2根.STEP
1.hardware/G-Exo V3/碳件发加工/碳件发加工/碳板-大腿电机出轴连接件-2块.STEP
1.hardware/G-Exo V3/碳件发加工/碳件发加工/碳板-膝关节电机固定（右）-1块.STEP
1.hardware/G-Exo V3/碳件发加工/碳件发加工/碳板-膝关节电机固定（左）-1块.STEP
1.hardware/G-Exo V3/碳件发加工/碳件发加工/碳板-髋关节电机固定（左）-1块.STEP
1.hardware/G-Exo V3/碳板-电机内部固定-1.SLDPRT
1.hardware/G-Exo V3/镜向rs02.stp1.SLDPRT
1.hardware/G-Exo V3/镜向大腿电机出轴连接件1.SLDPRT
1.hardware/G-Exo V3/镜向大腿铰链.SLDPRT
1.hardware/G-Exo V3/镜向大腿铰链1.SLDPRT
1.hardware/G-Exo V3/镜向小腿电机出轴链接件1.SLDPRT
1.hardware/G-Exo V3/镜向打印件-圆管管夹-后1.SLDPRT
1.hardware/G-Exo V3/镜向打印件-圆管管夹1.SLDPRT
1.hardware/G-Exo V3/镜向打印件-圆管管夹1.STEP
1.hardware/G-Exo V3/镜向打印件-方碳管-长碳管链接1.SLDPRT
1.hardware/G-Exo V3/镜向打印件-方碳管-长碳管链接V2-1.SLDPRT
1.hardware/G-Exo V3/镜向打印件-方碳管-长碳管链接V2-2.SLDPRT
1.hardware/G-Exo V3/镜向打印件-电机外部装饰-1.SLDPRT
1.hardware/G-Exo V3/镜向打印件-碳管内垫.SLDPRT
1.hardware/G-Exo V3/镜向护垫2.0.SLDPRT
1.hardware/G-Exo V3/镜向护垫2.01.SLDPRT
1.hardware/G-Exo V3/镜向方形碳管-11.SLDPRT
1.hardware/G-Exo V3/镜向方形碳管-21.SLDPRT
1.hardware/G-Exo V3/镜向方形碳管-31.SLDPRT
1.hardware/G-Exo V3/镜向测试-连接碳管1.SLDPRT
1.hardware/G-Exo V3/镜向碳板-大腿1.SLDPRT
1.hardware/G-Exo V3/镜向碳板-电机内部固定-1.SLDPRT
1.hardware/G-Exo V3/镜向碳板-电机内部固定-11.SLDPRT
1.hardware/G-Exo V3/镜向碳板-电机内部固定1.SLDPRT
1.hardware/G-Exo V3/镜向碳板-腰部悬臂加强件-11.SLDPRT
1.hardware/G-Exo V3/镜向碳板改打印件-大腿.SLDPRT
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
