Lain-Ego0/G-Exo/4.document/K3 Pico-ITX/k3_pico_itx_2d_0512.pdf

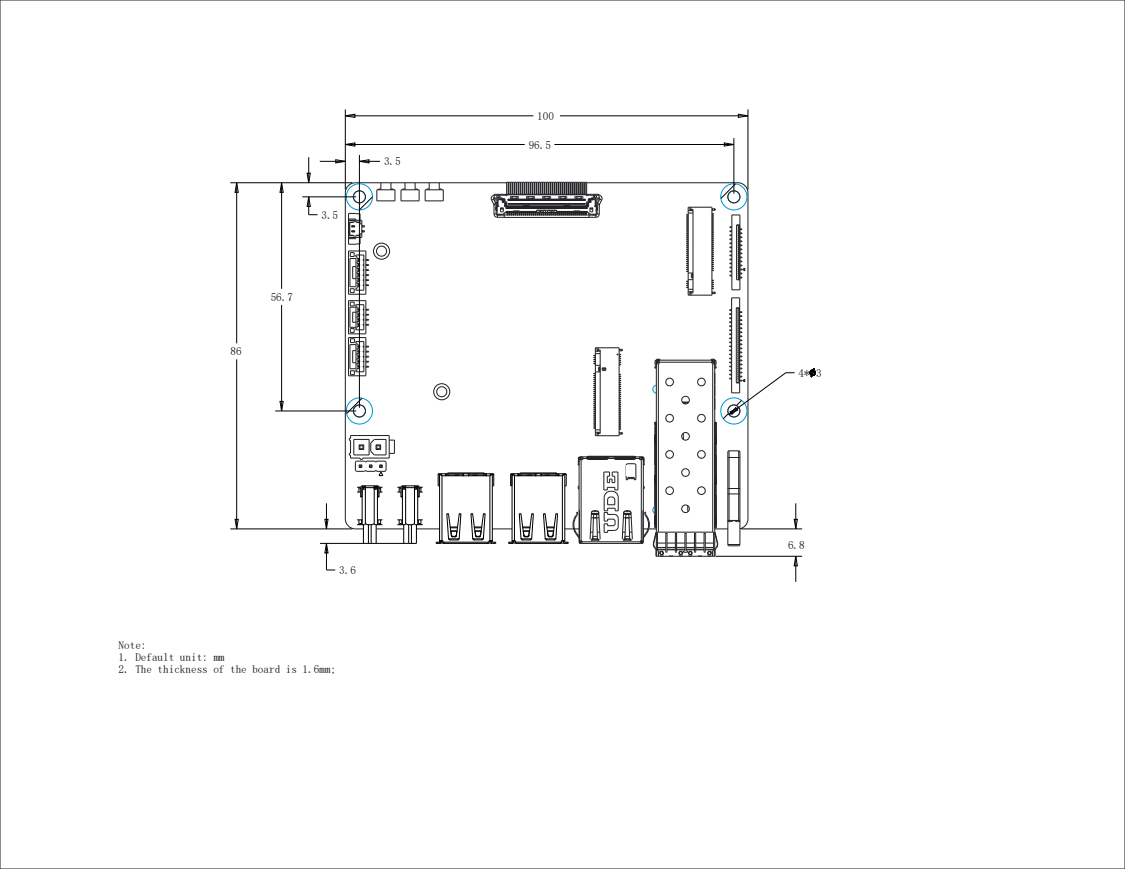
[picture p42: page 1]

Note:
1. Default unit: mm
2. The thickness of the board is 1.6mm;
