Lain-Ego0/G-Exo/4.document/K3 Pico-ITX/PCB-146-V10_K3_DEB1_P1_LP5315B_PDF.pdf

# ART FILM - BOTTOM

# SC631 SC627 SC626

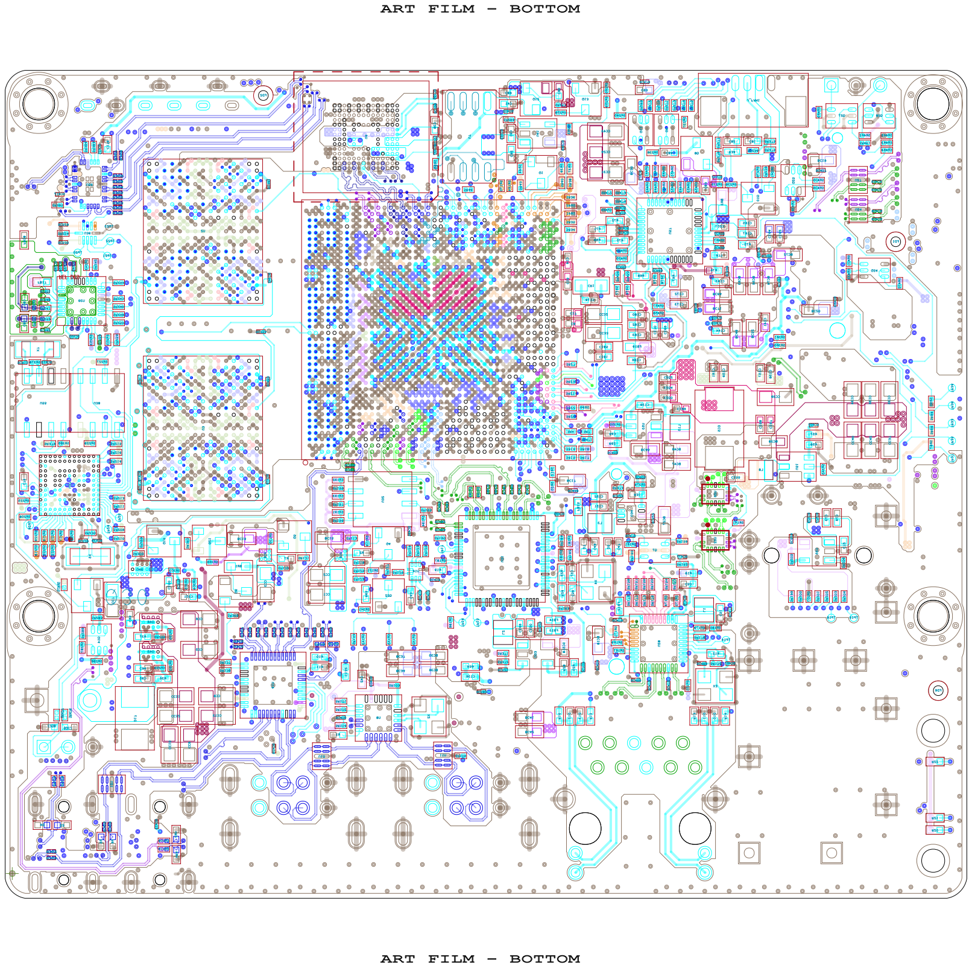
[picture p43: page 1]

# ART FILM - GND09

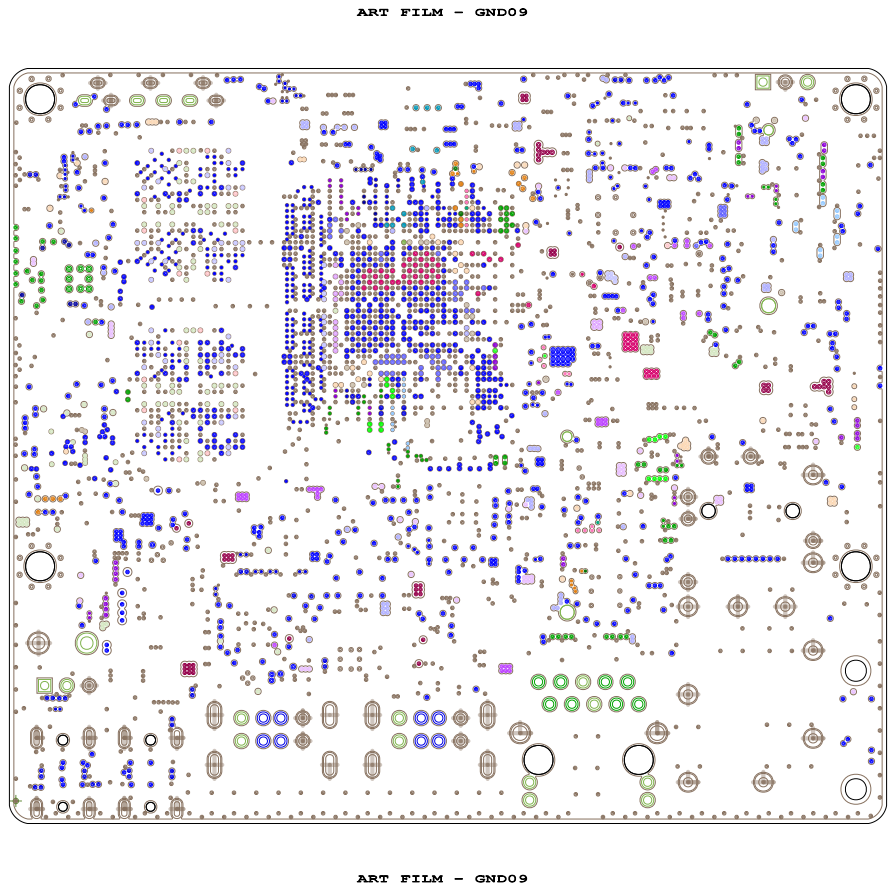
[picture p44: page 2]
ART FILM - GND09

# ART FILM - ART08

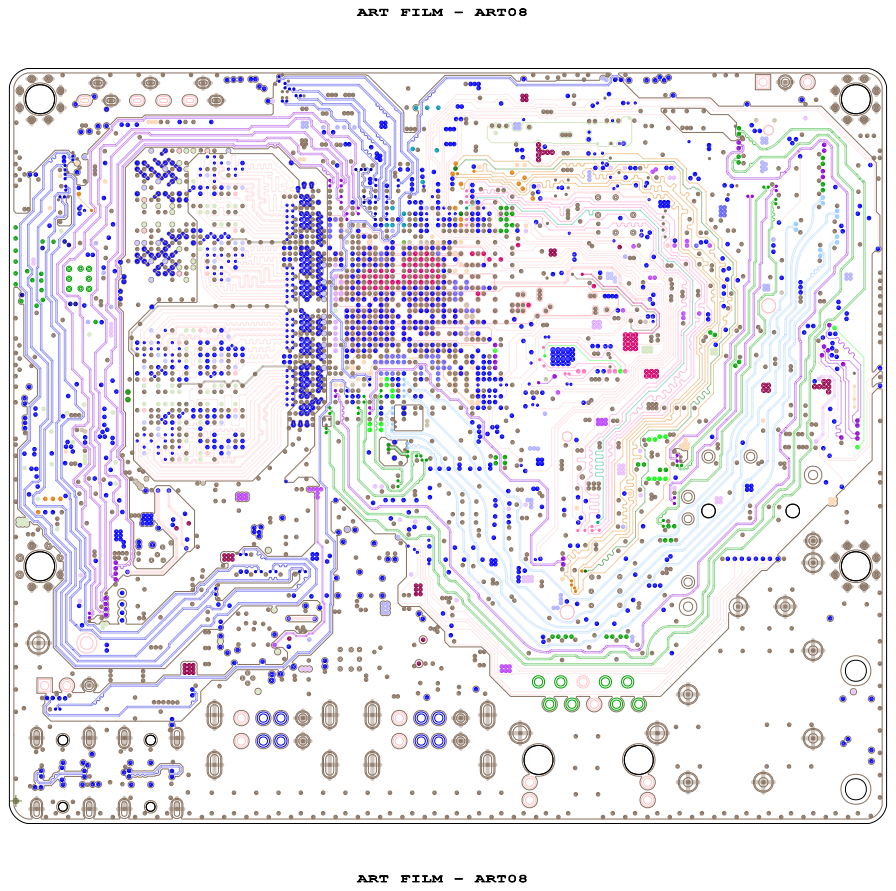
[picture p45: page 3]
ART FILM - ART08

# ART FILM - GND07

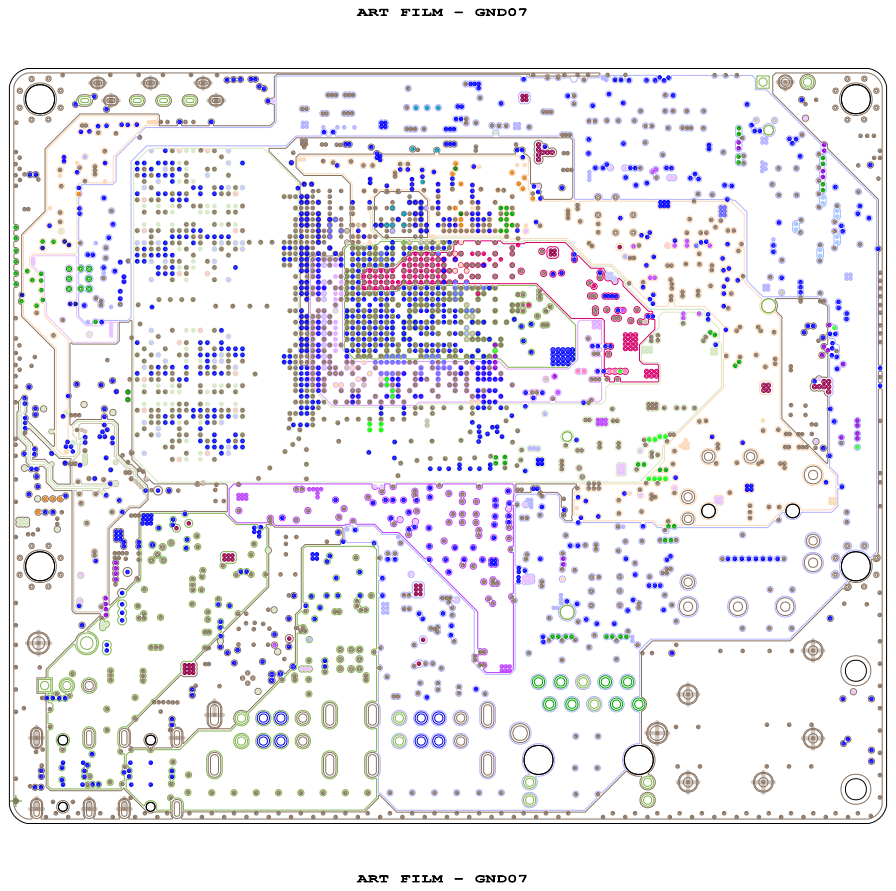
[picture p46: page 4]
ART FILM - GND07

# ART FILM - PWR06

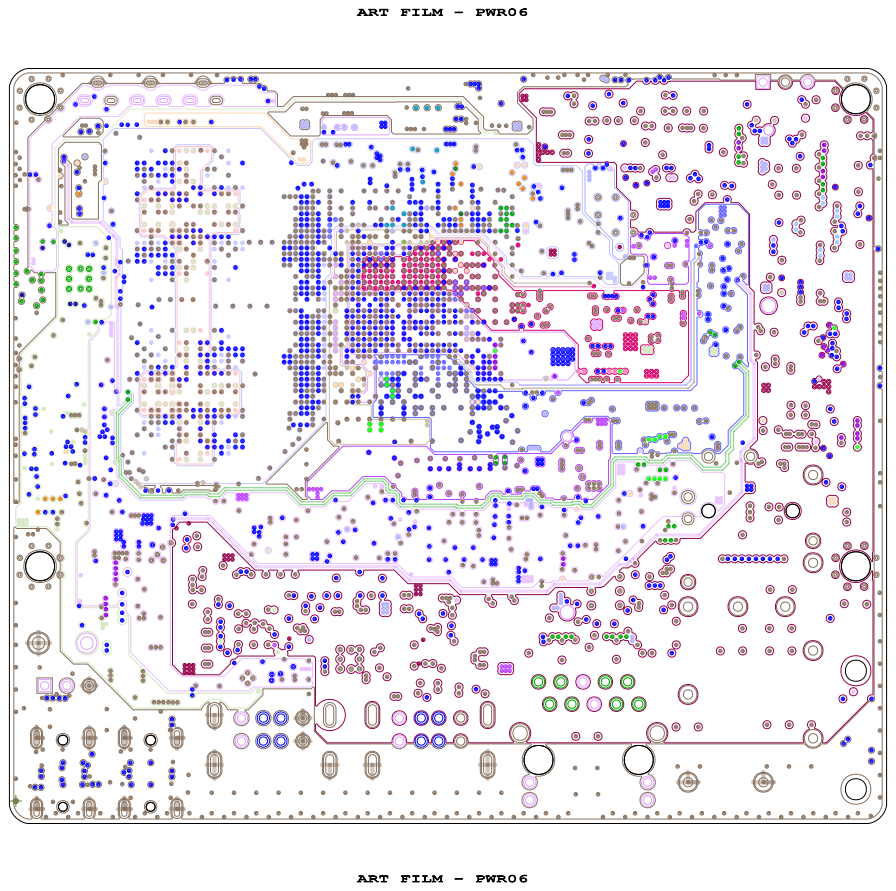
[picture p47: page 5]
ART FILM - PWR06

# ART FILM - ART05

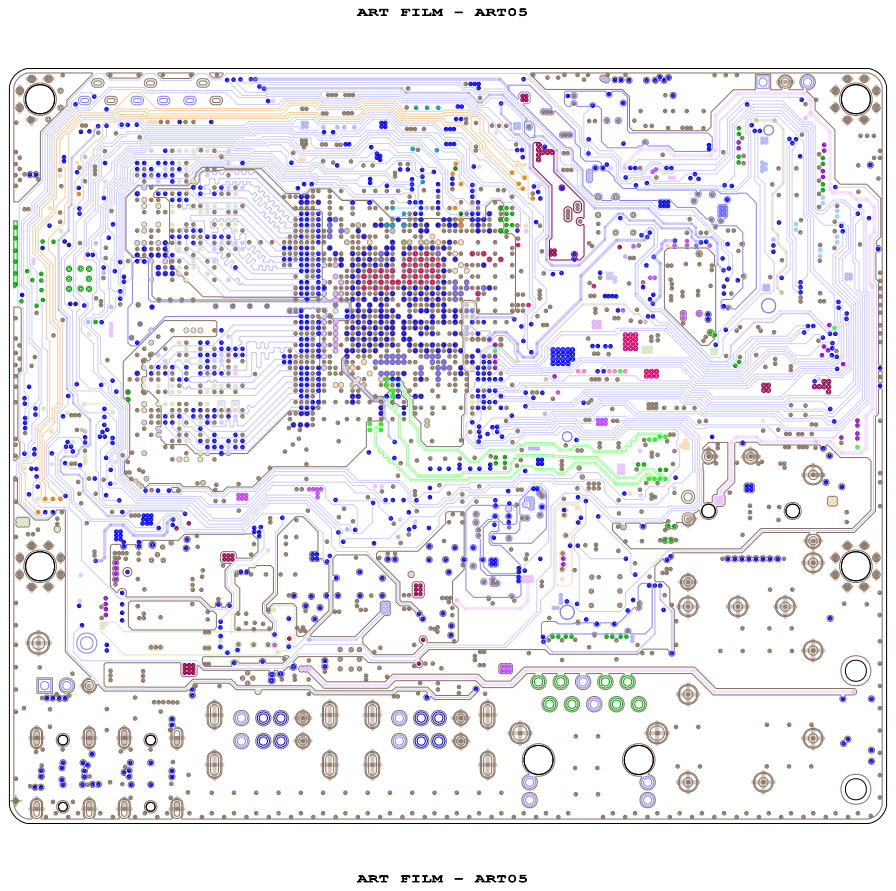
[picture p48: page 6]
ART FILM - ART05

# ART FILM - GND04

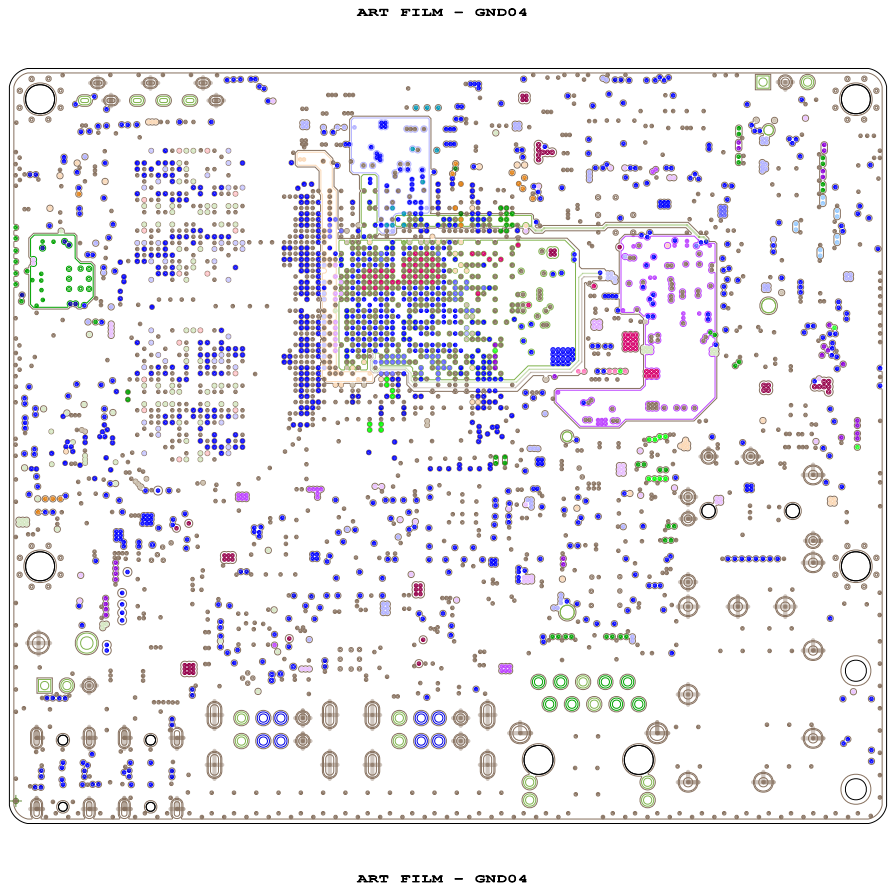
[picture p49: page 7]
ART FILM - GND04

# ART FILM - ART03

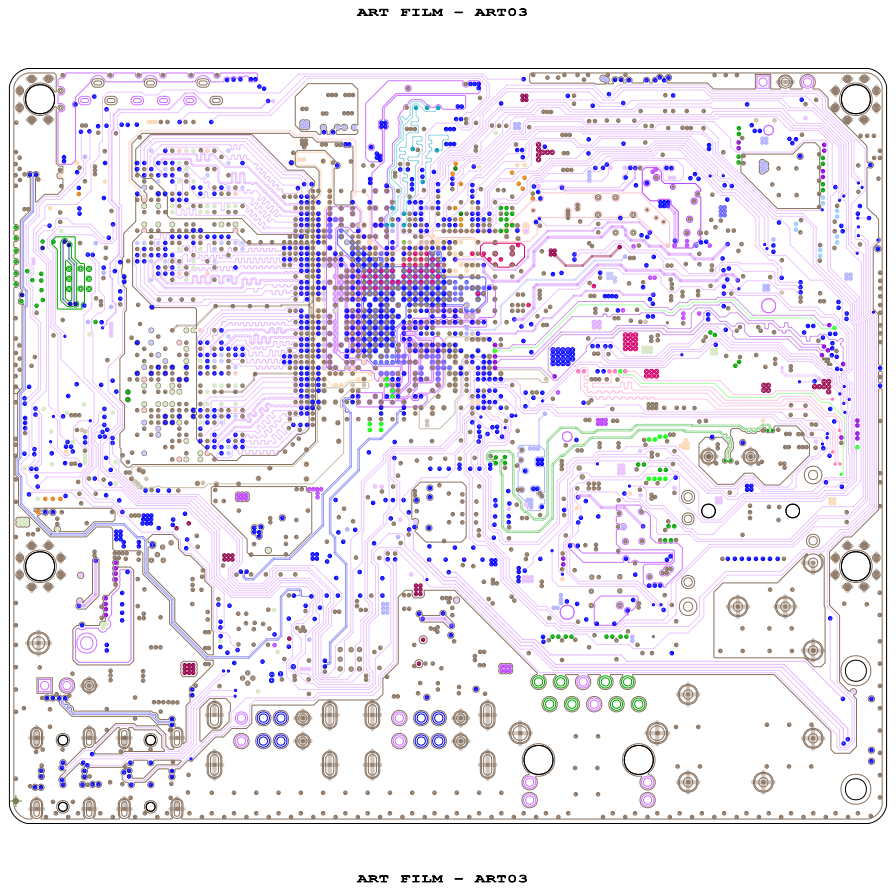
[picture p50: page 8]
ART FILM - ART03

# ART FILM - GND02

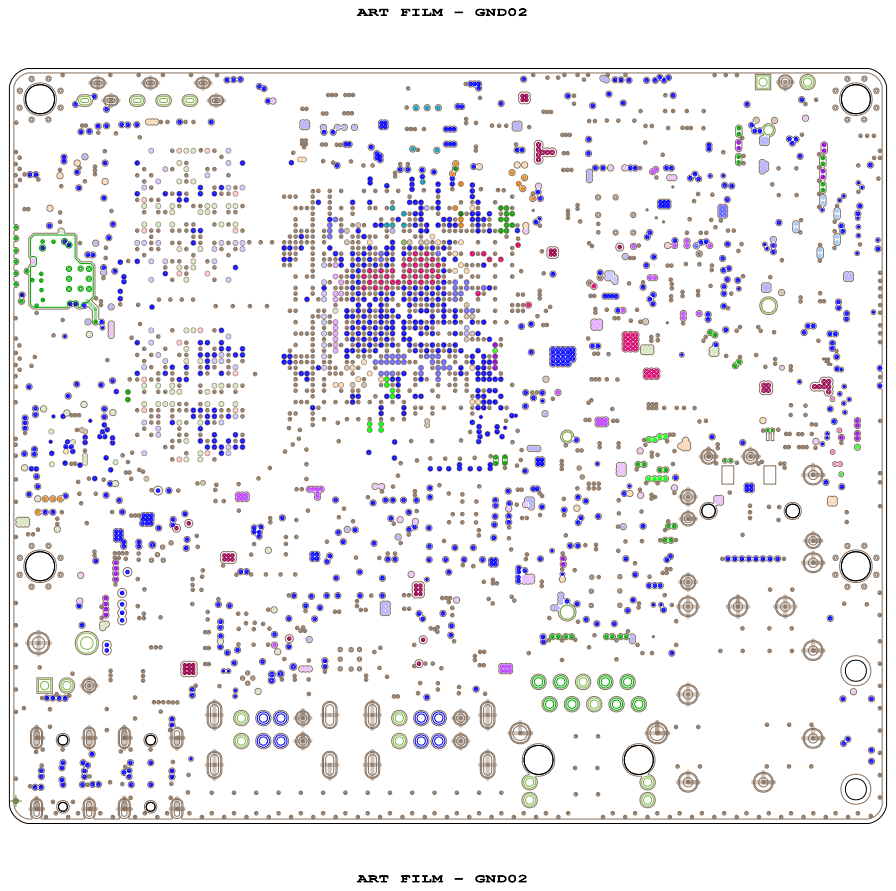
[picture p51: page 9]
ART FILM - GND02

# ART FILM - TOP

# REF DES FD4

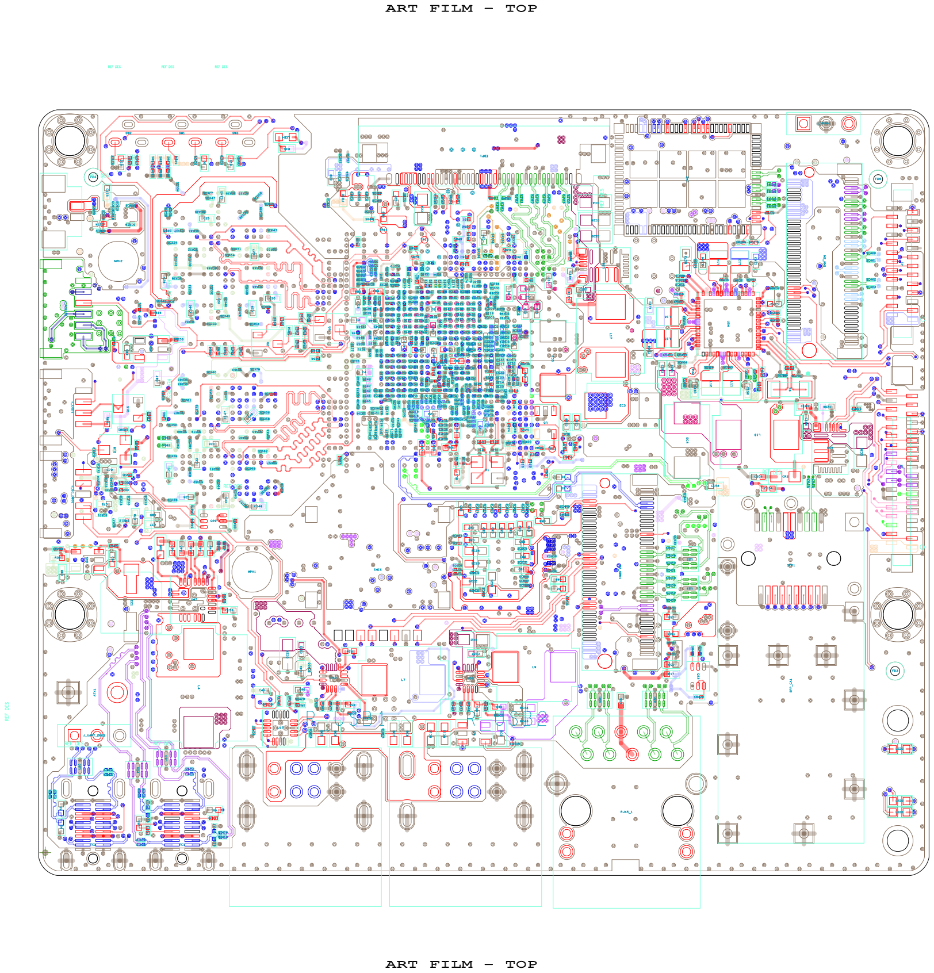
[picture p52: page 10]

# ART FILM - SILK_BOT

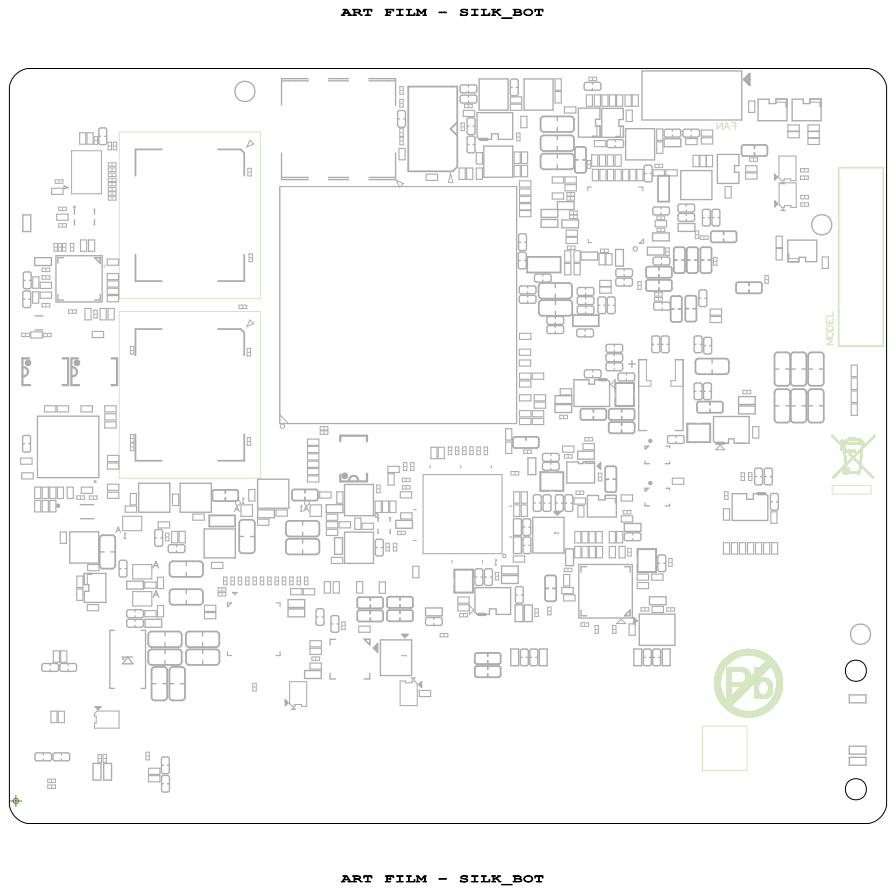
[picture p53: page 11]
ART FILM - SILK_BOT; MODEL

# ART FILM - SILK_TOP

# BAT

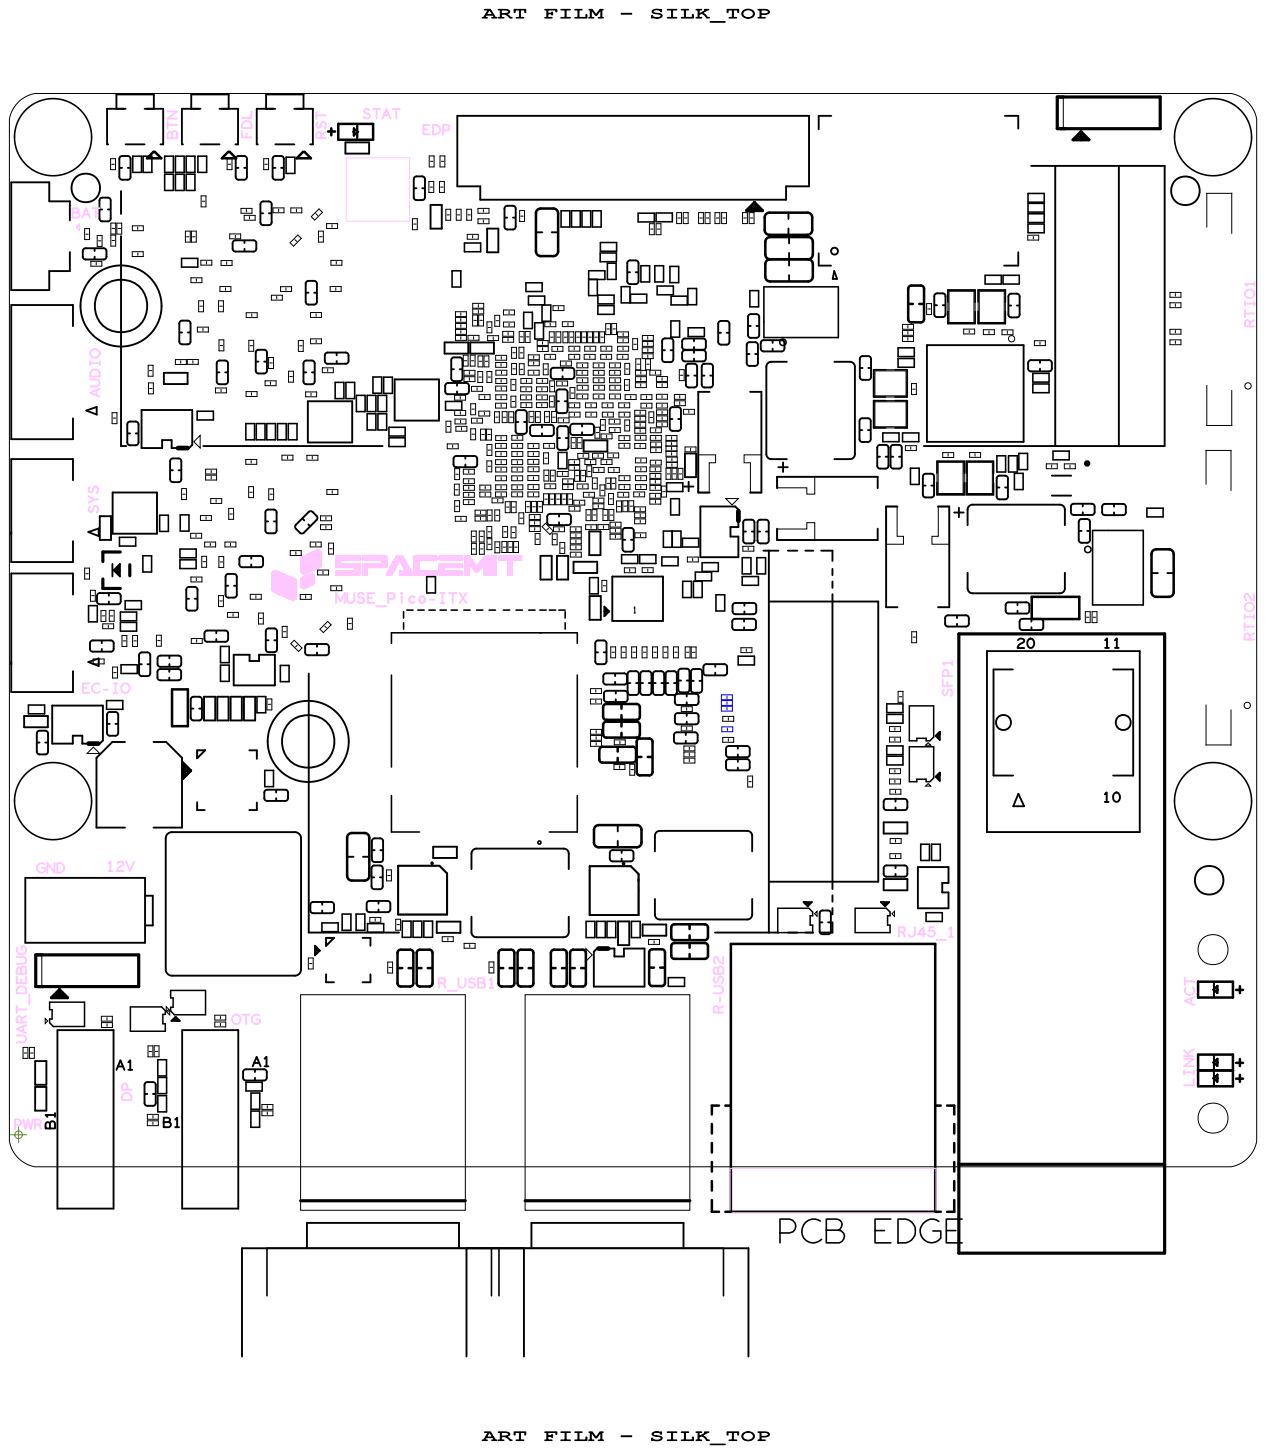
[picture p54: page 12]
ART FILM - SILK_TOP; PWRUART_DEBUG; GND; B1BTN; OTGFDL; RST; STAT; EDP; R_USB1; R-USB2; PCB EDGE; RJ45_1SFP1; LINK ACT; RTIO2 RTIO1

EC-IO SYS AUDIO

# ART FILM - PASTE_BOT

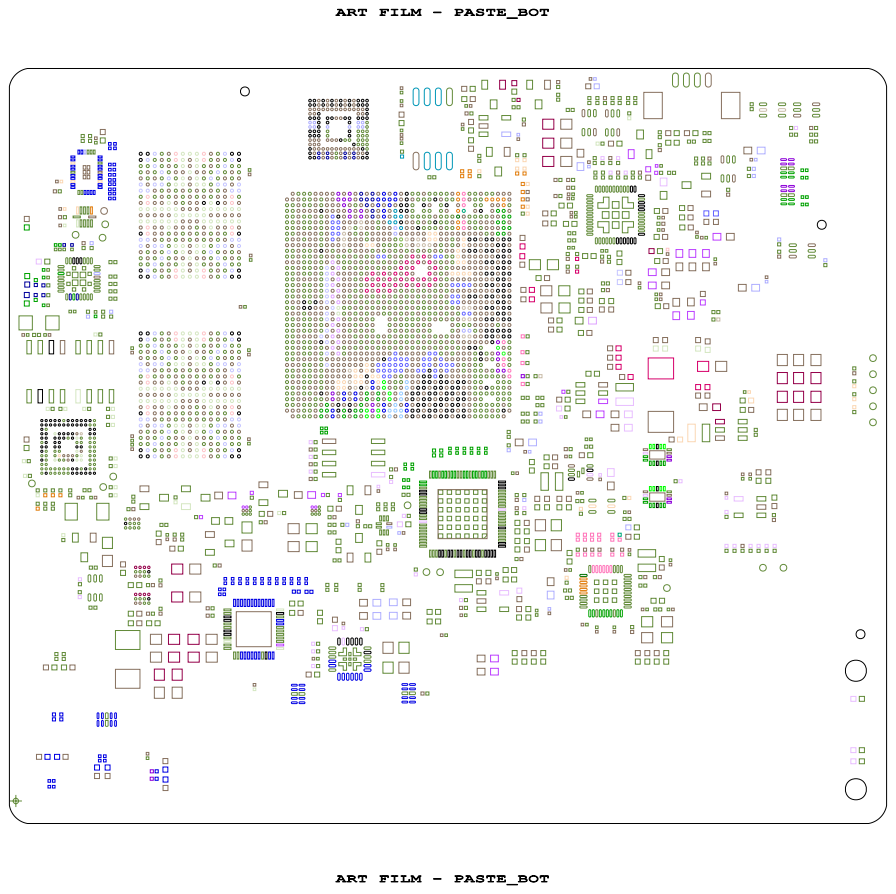
[picture p55: page 13]
ART FILM - PASTE_BOT

# ART FILM - PASTE_TOP

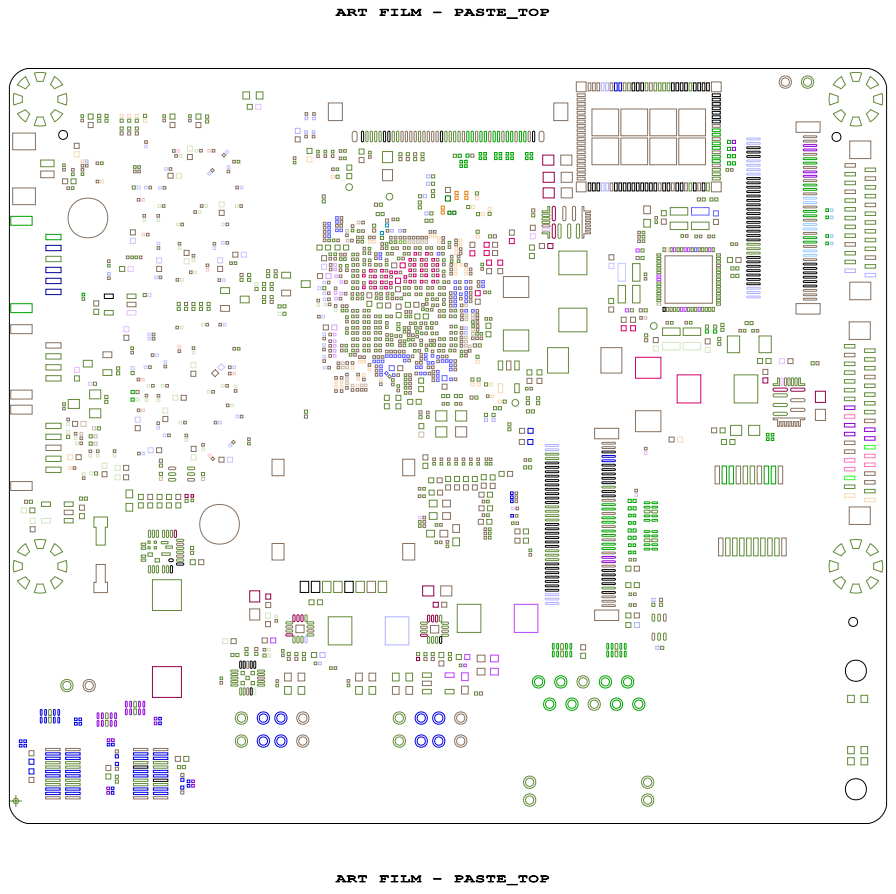
[picture p56: page 14]
ART FILM - PASTE_TOP

# ART FILM - SOLDER_BOT

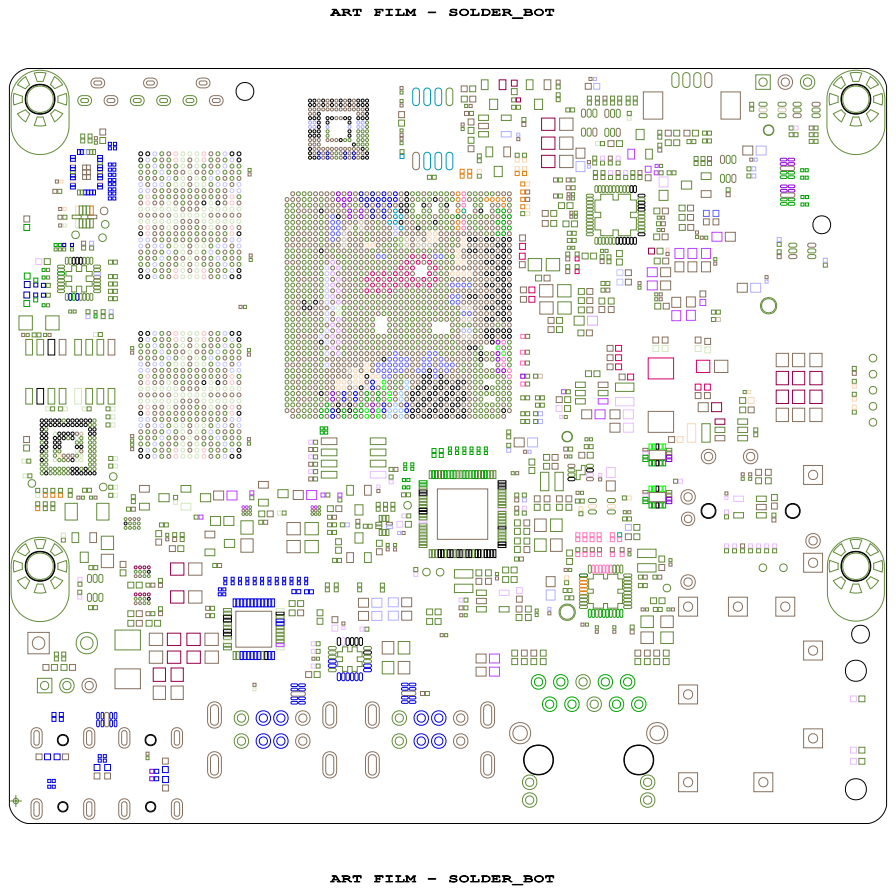
[picture p57: page 15]
ART FILM - SOLDER_BOT

# ART FILM - SOLDER_TOP

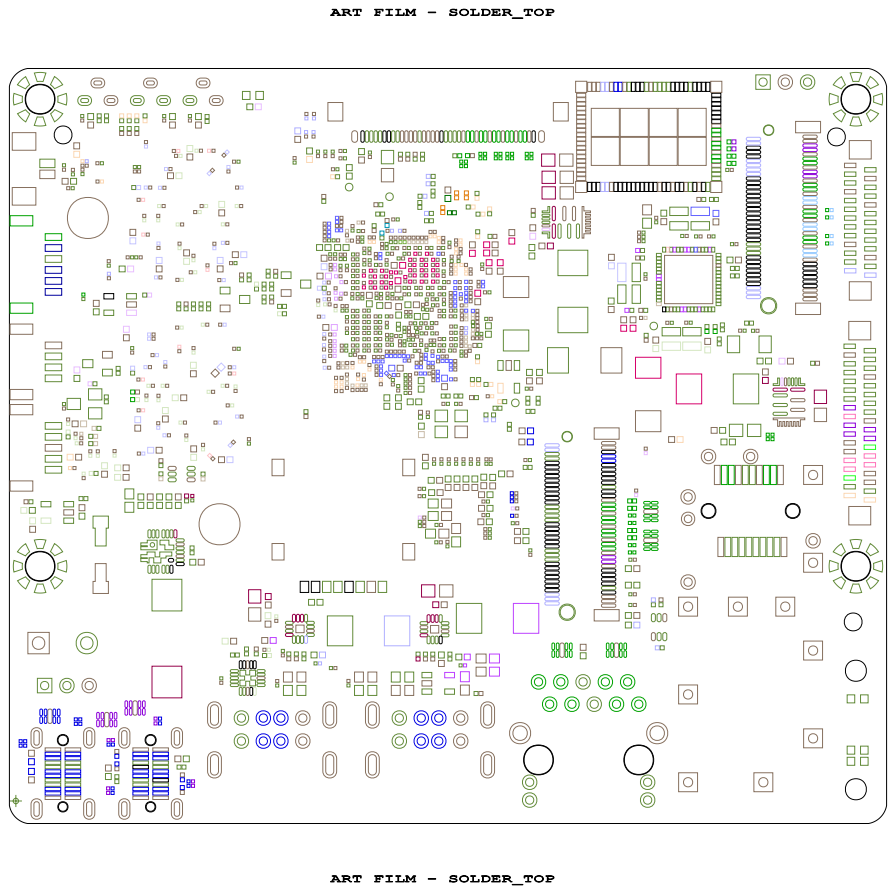
[picture p58: page 16]
ART FILM - SOLDER_TOP

# ART FILM - ADB

# SR258C90

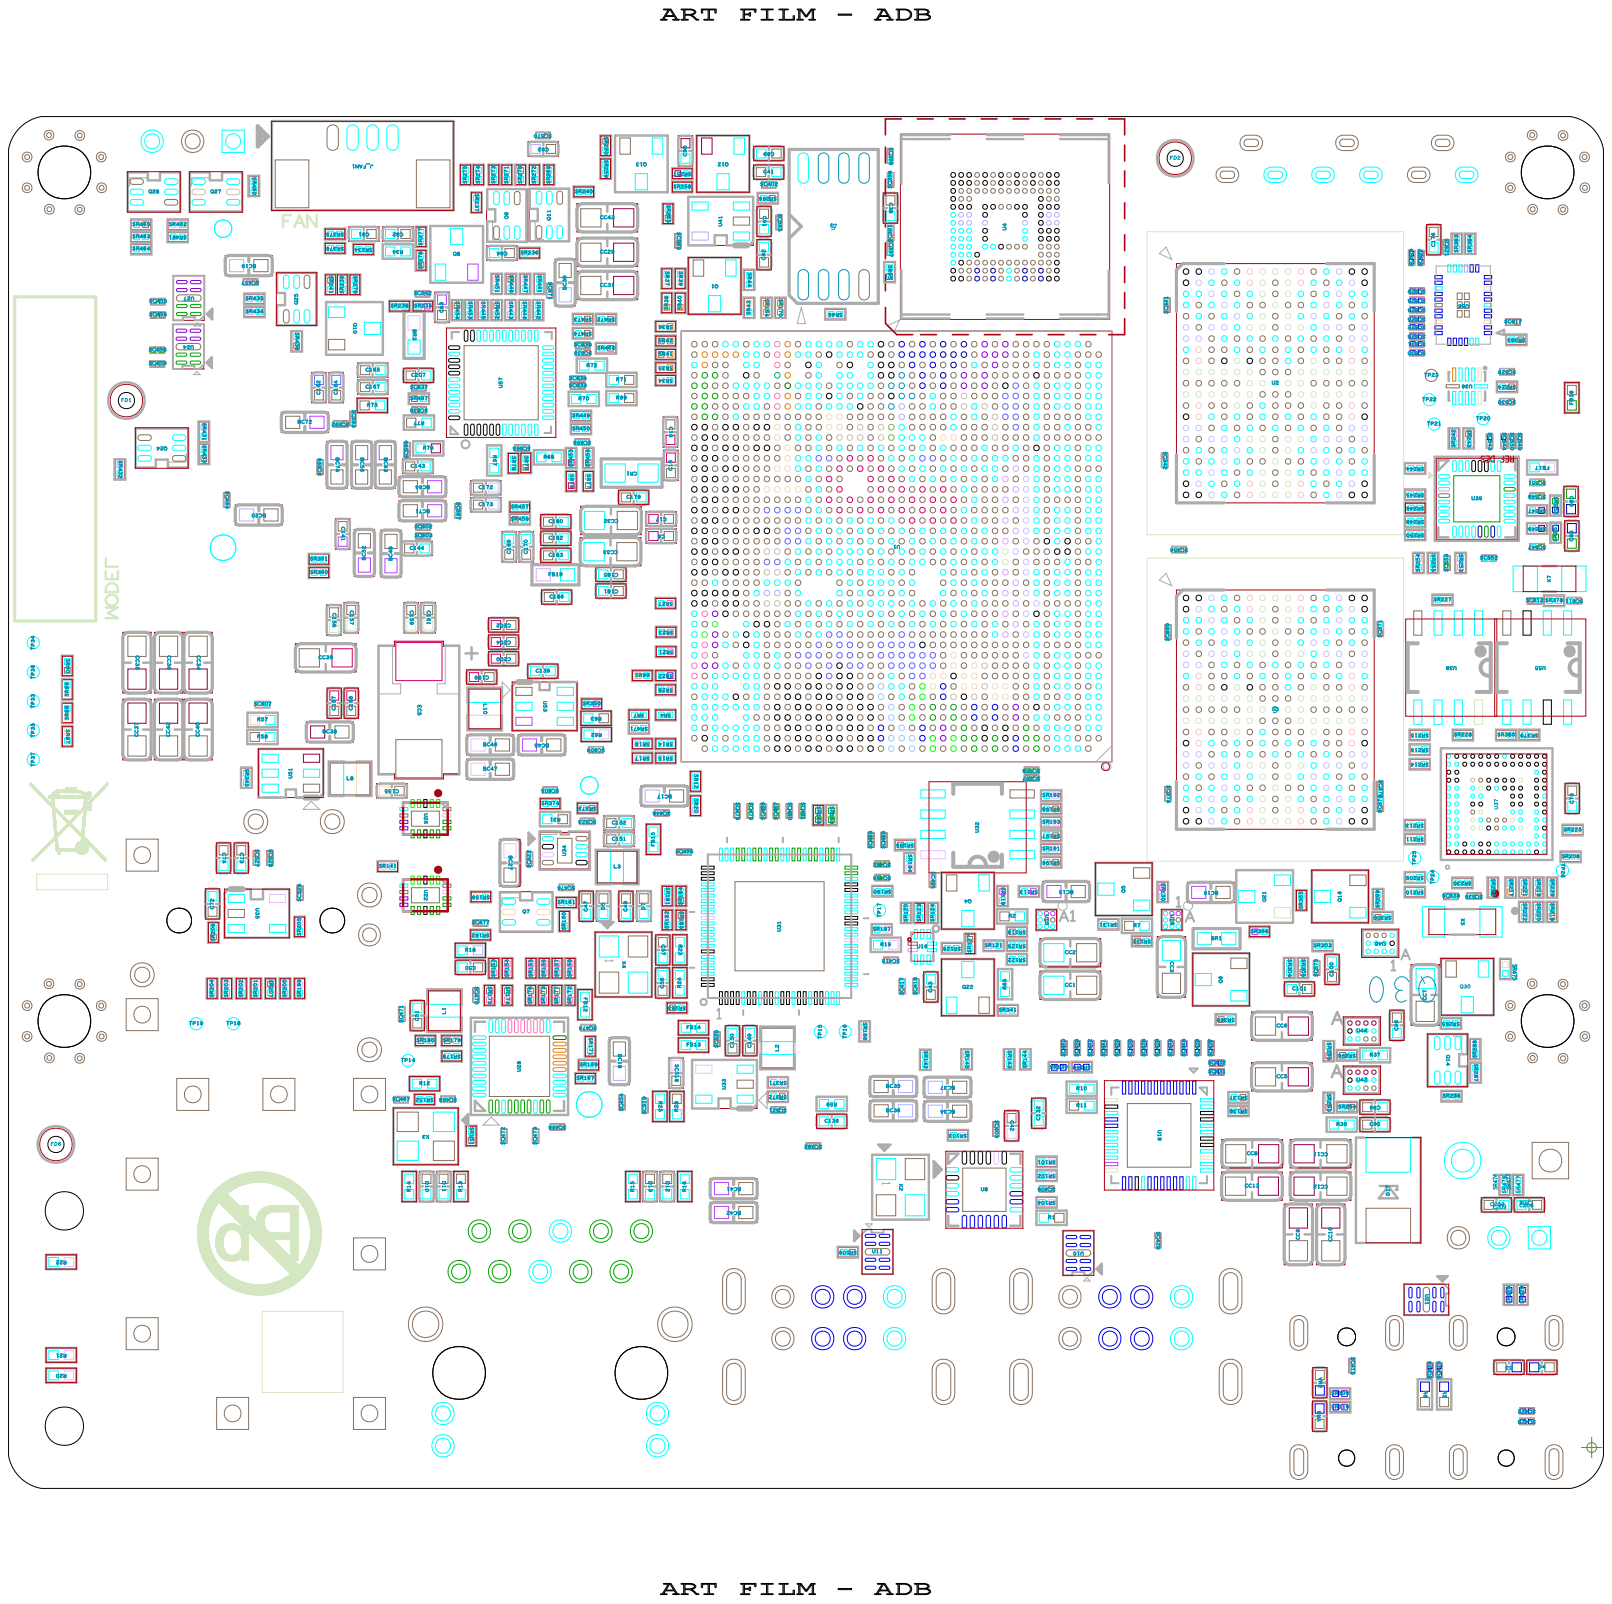
[picture p59: page 17]

# ART FILM - ADT

# BAT

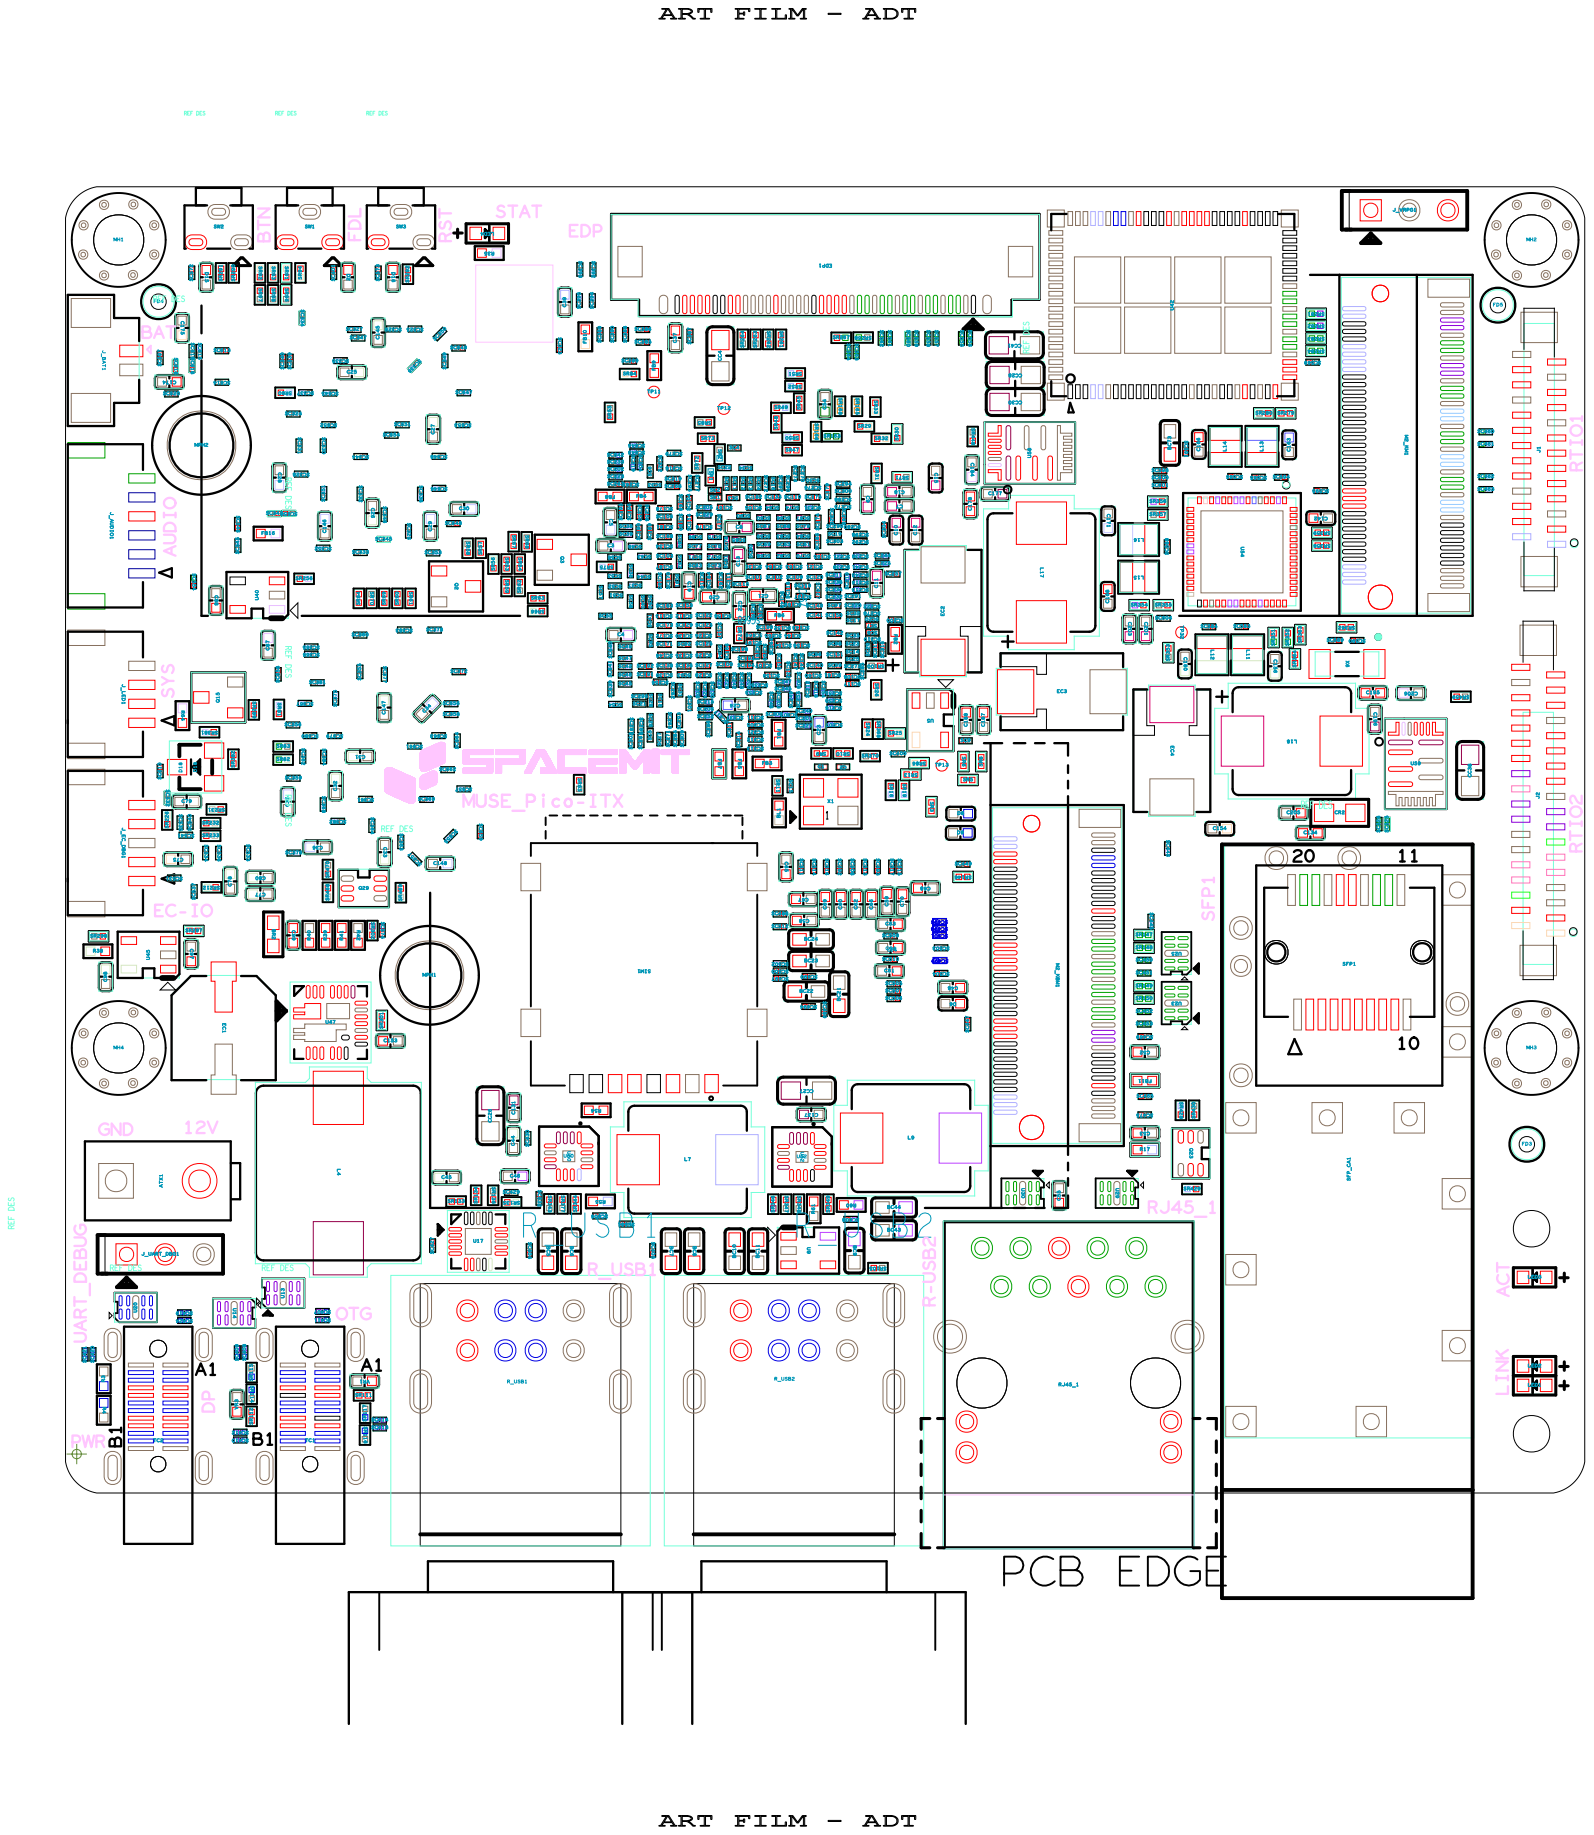
[picture p60: page 18]

# ART FILM - OUTLINE

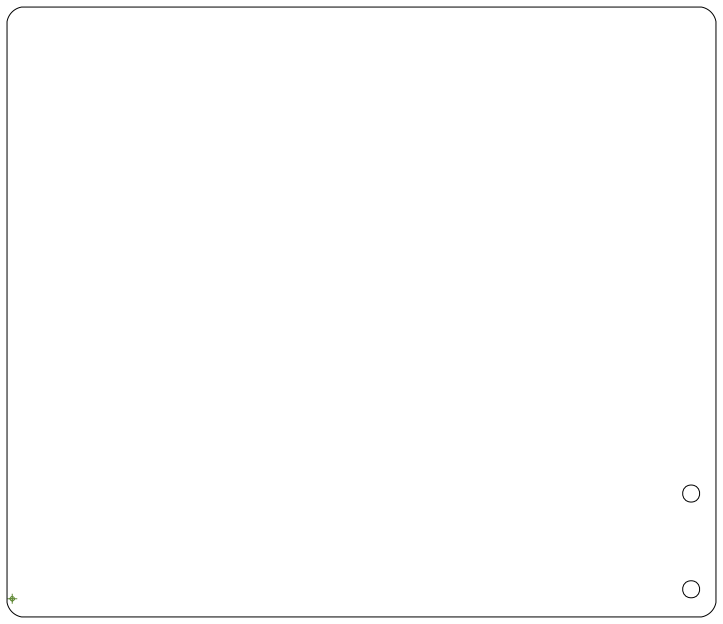
[picture p61: figure]

# ART FILM - OUTLINE
