Lain-Ego0/G-Exo/(commit log)

2026-06-23 添加任务无关外骨骼控制的文档和PDF文件
2026-06-28 更新 README.md，添加项目状态、核心参数和目录结构；新增 Q&A 文档和 BOM 初稿；新增关键参数草表 V0.1
2026-06-28 新增 README.md 文件，添加 ess_imu_driver2 的相关链接；新增 RS06.STEP 文件和 RS06 使用说明书 PDF 文件
2026-06-28 Add user manuals and documentation for DM-J4340-2EC and RS06
    - Added DM-J4340-2EC User Manual (V1.1) PDF (16,666 KB)
    - Added DM-J4340-2EC Reduction Motor Manual (V1.1) PDF (8,327 KB)
    - Added RS06 STEP file (4,471 KB)
    - Added RS06 User Manual (260428) PDF (1,795 KB)
2026-06-28 新增 BOM 文档，包含物料清单、采购优先级及降本路径
2026-06-29 新增基于运动预测的髋关节外骨骼实时助力控制文档
2026-07-04 新增 .gitignore 文件以忽略 .DS_Store
2026-07-23 更新 BOM 文档至 V2.0，调整执行器和电源系统配置，优化控制方案，确保在预算内
2026-07-23 更新 BOM 文档，调整执行器和电源系统配置，修正物料单价
2026-07-23 更新 BOM 文档，移除“假设已有”描述以简化工具/设备部分
2026-07-23 Add K3 Pico-ITX user guide in Chinese (k3_pico_ug_zh.pdf)
2026-07-23 Add Chinese translation and annotations for "Task-agnostic Exoskeleton Control via Biological Joint Moment Estimation" paper; include PDF version.
2026-07-26 IMU driver and mahony
    IMU
2026-07-26 IMU driver and mahony 可用了
    可用了
2026-07-26 删了sb的编译文件
2026-07-26 Add URDF model and associated files for G-exo robot
    - Created package.xml for G-exo URDF description package.
    - Added G-exo URDF file with links and joints for the robot structure.
    - Included CSV file for link properties such as mass and inertia.
    - Added STL mesh files for the right thigh and other components.
2026-07-26 Update G-Exo V2 hardware files and URDF mesh components
    - Modified G-exo.SLDASM and several .SLDPRT files in the G-Exo V2 directory.
    - Updated binary files for various components including rs02.stp1.SLDPRT and others with new revisions.
    - Changed base_link.STL and other mesh files in the G-exo_URDF directory to reflect the latest design updates.
    - Ensured all binary files are correctly versioned and differ from previous commits.
2026-07-26 更新 G-exo URDF 文件，调整关节限制和电机参数
2026-07-27 更新 G-exo URDF 文件，调整关节限制和电机参数注释
2026-07-30 Update G-Exo V2 hardware files with various modifications
    - Updated G-exo.SLDASM with new binary data.
    - Modified multiple SLDPRT files including GB T 70.1-2008, GB T 70.2-2015, and GB T 70.3-2008 with new versions.
    - Adjusted rs02.stp1.SLDPRT and other related files with updated binary content.
    - Enhanced several SLDPRT files related to structural components and assembly configurations.
    - Ensured compatibility and improved performance across the hardware design files.
2026-07-30 Update README and project documentation for G-Exo software stack and hardware design
    - Enhanced README.md with project overview, software architecture, and branch details.
    - Added detailed descriptions of remote branches for RL training framework and IMU driver.
    - Updated specifications and project planning documents, including a new project proposal for sponsorship.
    - Revised technical details on hardware components, control algorithms, and training processes.
    - Included progress updates and future milestones for the G-Exo project.
2026-07-30 docs:更新策划书
2026-08-01 8.1初版
2026-08-01 feat: scaffold gexo_web_agent package (config, schemas, logging)
    - ament_python + pip dual-mode package under 2.software/
    - schemas.py: 4-action whitelist (query_status/set_mode/adjust_assist/document_qa),
    bridge wire format (command/state/result), API models; delta hard-limited to ±0.1
    - config.py: default.yaml + GEXO_* env overrides via pydantic-settings
    - logging_config.py: structured single-line JSON control events
    - tests/test_schemas.py: 31 tests, all passing (Windows, no ROS 2)
2026-08-01 feat: state cache, mock controller core, bridge transport abstraction
    - StateCache: lock-guarded atomic snapshot + staleness clock
    - MockControllerCore: ROS-free controller sim (8 scenarios incl. estop/
    fault/can_offline/moving/no_reply), authoritative re-validation of commands
    - ros_bridge: BridgeTransport protocol, in-process MockTransport,
    Ros2Transport with lazy rclpy import, RosBridgeAdapter (source filtering,
    wire parsing, state/result dispatch)
    - 54 tests passing (Windows, no ROS 2)
2026-08-01 feat: safety guard with full ordered check list
    - stateless pure function check(action, state, stale, confirmed, cfg)
    - 11 ordered checks: no-state/stale/estop/fault/can-offline interlocks,
    damping blocks assist, exact ±0.1 delta, [0.3,1.0] bounds with float
    rounding, mode-switch confirmation + stationary gate, same-mode soft reject
    - read-only actions always pass; shared by LLM and button paths
    - 31 new tests (85 total passing)
2026-08-01 feat: FastAPI endpoints, WebSocket hub, main entrypoint
    - api.py: /health /api/state /api/action /api/confirm /api/action/{id}
    /api/chat (503 until LLM wired) /ws + debug scenario endpoints
    - WsHub: coalescing broadcast via dirty flag, min-interval throttle,
    dead-socket eviction; fed from transport thread via call_soon_threadsafe
    - main.py: build_app object graph, mock|ros2 transport switch, CLI flags
    - e2e tests over httpx ASGITransport + TestClient websocket (113→130 total)
    - acceptance #18: full demo loop runs with zero ROS 2 packages
2026-08-01 feat: mobile web UI (status panel, controls, chat shell, debug)
    - first-screen status card: online/mode/assist/estop/fault/CAN/battery/max-temp
    - joint table, IMU grid, collapsible debug area with mock scenario switcher
    - controls with mode-switch confirmation dialog; result states rendered
    verbatim (pending/sent/success/failed+reason/timeout)
    - chat area with quick hints; sources shown for document answers
    - WebSocket live updates with reconnect backoff + manual refresh fallback
    - plain HTML/CSS/JS, mobile-first, no framework
2026-08-01 feat: llm client, intent router, rag service
    - llm_client: minimal OpenAI-compatible httpx client for llama-server,
    hard timeout, tool-call extraction; LLM outage never touches control path
    - intent_router: Chinese rule fast-path (spec examples covered) → LLM tools
    API (json_schema fallback flag) → Pydantic re-validation; invented/out-of-
    range actions → clarification, never a guessed write
    - status answers rendered from real StateCache only; stale → 数据失联
    - rag_service: jieba + SQLite FTS5 unicode61 + bm25, heading-aware chunking,
    pypdf text layer (scanned pages skipped), incremental index by mtime+size
    - verified live: 4.document/ corpus = 14 files indexed, 0 errors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
2026-08-01 feat: ros2 finalization — mock controller node, launch, scripts, README
    - mock_controller_node: standalone rclpy shell over the shared
    MockControllerCore for real-topic integration on the K3
    - launch file (web agent + optional mock controller), start scripts for
    llama-server and web agent, build_rag_index CLI
    - device-only ros2 transport smoke test (importorskip rclpy)
    - README: architecture, zero-to-running for mock/pip/colcon, API table,
    safety design, acceptance test mapping
    - 176 passed + 1 ros2 skip on Windows
2026-08-03 第一版定稿(暂时未训练完)
2026-08-03 第二次定版
2026-08-04 fix: remove restrictive Alloop scan filter
2026-08-04 fix: scan Alloop rings without exact name filter
2026-08-04 Enhance cockpit key visual: fonts, branding, live-loop motion
    P0 fixes:
    - Self-host Noto Sans SC (latin + chinese-simplified 400/600)
    - Add favicon.svg and bilingual title/description/OG meta
    - Bind Reason panel engine badge to robot.apiReachable
    - Resolve TelemetryDock chart colors from CSS tokens
    P1 key visual (Living Blueprint):
    - Animated gradient data flow on closed-loop spine (online only)
    - Restrained radial depth glow behind stage panels
    - Wordmark closed-loop arrow accent
    - Joint map blueprint grid + edge-fade mask + online node pulse
    - Add main_visual_optimization.md proposal
2026-08-04 Add real IMU telemetry with simulated mode controls
2026-08-04 新增黑客松 PPT 大纲，包含项目介绍、问题分析、解决方案及技术实现
2026-08-04 更新黑客松 PPT 封面，新增品牌主标、主标语及英文副标
2026-08-04 更新黑客松 PPT 大纲，完善项目描述及解决方案，新增硬件架构和控制算法细节
2026-08-04 更新硬件架构细节，修改供电方案为单电池+BMS，新增精简版 PPT 内容，优化外骨骼功能描述
2026-08-05 更新最新的机械文件
2026-08-06 更新 .gitignore，新增 ROS2、SpaceMIT K3 SDK、Python、Node 和 IDE 的忽略规则
2026-08-06 更新 .gitignore，调整 ROS2 和 SpaceMIT K3 SDK 的忽略规则，移除不必要的构建产物路径；更新 README.md，修改机械设计目录结构以反映设计迭代。
2026-09-22 hardware: consolidate G-Exo CAD into a single design directory
    The parallel "G-Exo V1..V4" folders each carried a full copy of the whole
    assembly, so every part existed four times and it was impossible to tell
    which revision was current. Keep only the latest state.
    - add 1.hardware/G-exo/ as the single source of truth: G-exo.SLDASM
    (re-exported, 20 MB, down from 75 MB in V3) plus 72 part files,
    including a 标准件/ library of GB/T fasteners (M3/M4 socket head,
    countersunk and button head screws, mirrored instances)
    - of those 73 files, 39 are byte-identical to parts already in the
    repository (verified at the blob level: 3D_PCB1_2025-08-21.step matched
    V3/3D_PCB1_2025-08-21.step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
2026-09-22 docs: retire vendor hardware docs and the paper translation draft
    Sweep the reference material that no longer has a consumer in the tree.
    4.document (vendor hardware):
    - DM-J4340-2EC: datasheets, 3D model, performance curves and the
    bilingual README for the superseded V1.1 actuator
    - K3 Pico-ITX: BOM, PCB/SCH PDFs, 2D drawing, 3D model and user guide
    - K3 260com kit: PCB .brd
    - RS02: IP67 datasheet and STEP model
    - RS06: STEP model and datasheet
    The kit documentation that is still in use stays where it is:
    4.document/K3 260com kit/{DSN, PDF, BOM} and 4.document/RS02/{rs02.stp,
    RS02使用说明书}.
    3.paper:
    - drop the Chinese translation and annotation of "Task-agnostic
    exoskeleton co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
2026-09-22 docs: record alloop-track win and refresh stale project overview
    The README still described the pre-hackathon plan: it listed RS02 as
    "待采购", the hardware tree as "G-Exo V1 ~ V4" plus vector/, and the RL
    framework as "已搭建". None of that matches the repository any more.
    README:
    - add a 赛果 section: Hong Kong's first Physical AI Hackathon 2026,
    decided 2026-08-05 at HKSTC, alloop track champion, team AAA G-Exo
    - add the missing product narrative from ppt.md: the two interaction
    modes (Adaptive Assist / Damping), the Alloop Ring state loop
    (HR/HRV/activity + 14-day baseline), and the tagline
    SENSE THE BODY · DECIDE THE ASSIST
    - rewrite the status table against actual art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
2026-09-22 docs: align README with the final defense deck
    ppt.md is the final version of the design, so the README follows it rather
    than the older BOM where the two disagree.
    - power: 6S 5000mAh LiPo single pack + BMS (22.2V nominal, ~111 Wh),
    30-100 W system, ~10 W standby with roughly 11 h standby runtime.
    BOM.md still carries the earlier 6S 3000mAh x2 hot-swap plan
    - control pipeline: draw the 36-dim/frame @200Hz -> TCN (5 dilated conv
    layers, NPU INT8) -> shared latent -> PPO (MLP 128-64) -> [-1, 1]
    normalized torque -> scale/rate limit/low-pass -> CAN -> RS02 at 50 Hz,
    with TCN INT8 inference under 5 ms
    - keep the Kinesis training numbers as a labelled note instead of mixing
    them int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
2026-09-22 docs: make the README bilingual and record the hackathon result
    The root README was Chinese-only and still framed the repository as a
    pre-competition workspace.
    - README.md is now the English entry point, with README_zh.md as the
    Chinese counterpart and a language switch in both headers
    - record the alloop-track win, the event details and the team name
    - add the four supplied photos under assets/ (pitched, mid-build,
    finished unit, sponsored K3 board), downscaled to ~300 KB each
    - add the policy-effectiveness table from RL/evidence/ and state plainly
    that muscle-activation saving is 0.43% against the project's own >=5%
    target, so no metabolic-effort claim is made
    - note that the pow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
2026-09-22 docs: remove machine-specific paths and addresses for public release
    The repository is being open-sourced, so local paths, hostnames and LAN
    addresses must not ship.
    - replace the project root literals (/media/... and /home/... user paths,
    and the Windows export directory in the URDF export log) with
    <PROJECT_ROOT> / <EXPORT_DIR>
    - replace the K3 device's hostname, LAN address, home directory and user
    with <K3_HOSTNAME>, <K3_LAN_IP>, <K3_HOME> and <K3_USER>; the operator
    shell line continuations are preserved
    - keep the conda environment name in <CONDA_ENVS>/<name> so the training
    commands stay meaningful
    - drop RL/datasets/external, an absolute symlink pointing outside the
    repo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
2026-09-22 feat(control): add the RS02 motor and K3 deployment stack
    The on-device control code existed only on a side branch, so a clone of
    the default branch had no way to drive the hardware.
    - control/motor/: RS02 QDD driver over SocketCAN, MIT-mode torque
    commands, motor group composition, damping and direction demos, and a
    protocol conformance test
    - control/deploy/: ONNX actor + TCN runtime with SHA256 model
    verification and a deterministic reference replay, so a reloaded model
    can be checked against the one that was evaluated
    - control/deploy/tcn_pd/: TCN + PD variant with its own state machine
    documented in STATE_MACHINE.md
    - control/: ROS 2 package, control contract header and test,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
2026-09-22 feat(rl): add the on-device deployment packages
    Companion runtime to the K3 control stack, packaging the trained policy
    for the board.
    - RL/deploy/: actor + TCN ONNX package with SHA256 verification,
    reference replay and runtime test
    - RL/deploy_tcn_pd/: TCN + PD package with the same verification and
    smoke test
    - both ship model_config.json describing the observation/action contract
    and the source artifacts each model was exported from
2026-09-22 feat(rl): sync the training framework with the post-hackathon state
    The default branch carried an earlier snapshot of RL/ while development
    continued on a side branch; this brings the framework up to date.
    - env/myoassist: URDF attachment, motion reference, gait phase, domain
    randomisation and speed curriculum, plus the matching tests
    - env/gazebo: ROS-backed Gazebo environment and benchmark for Sim2Sim
    - controllers/: TCN impedance controller and delayed-prediction audit
    - runners/: MyoAssist and URDF training, policy audit, Gazebo and
    Kinesis Sim2Sim evaluation, TCN impedance evaluation, policy load
    compatibility, motion-reference collection
    - metrics/trajectory.py plus tests
    - asse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
2026-09-22 docs: add the hackathon site link and a screenshot
    The Result section named the competition but gave no way to look it up.
    - add a short "The event" / "赛事信息" block to both READMEs: one line on
    what the hackathon was (48 hours, physical AI prototype) and which track
    G-Exo entered
    - link the official site: https://www.brizanvp.com/physical-ai-hackathon
    - show the site's hero section via assets/hackathon-site.jpg, wrapped in
    the same link so the image is clickable
    Only the introduction, the URL and the screenshot are included; the theme,
    prize pool, organiser list and entry rules from the site are deliberately
    left out as they add little for a reader of this repository.
    The scr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
2026-09-23 Revise README for clarity and accuracy
    Updated README to clarify simulation vs on-body physiology, power supply details, missing control metrics, dangling submodule references, and absolute paths in earlier commits.
2026-10-31 提交V2版本
