Lain-Ego0/G-Exo/(notices)

Notices in the files:
README.md:
License: MIT
